yassinekarroukuxvc/WAD.Runner/Resources/Templates/1001/1001A_REQ_Rev0_07232026  .pptx

SMALL PRECISION TOOLS

Wedge Auto-Draw Requirements

Small Wire (SW) Wedge Series – 1001A Series – Microwave Bonding Tools
Requirements

DOCUMENT NO.

1001A_REQ_Rev0_07232026

DATE

2026-23-07

PREPARED BY

Youssef

STATUS

Draft

## Slide 2

Scope

This document defines the production drawing, customer drawing, and overlay requirements for the 1001A Series
Requirements series, covering both the finished wedge and the Pre-Ground Blank (PGB). Including 1001A, 1007, 1002A, 1005A, 1300

SMALL PRECISION TOOLS

Confidential

04

## Slide 3

Tool Overview

SMALL PRECISION TOOLS

Confidential

04

## Slide 4

Configuration Options

Shank: SW_STD with SLB feature , SW_180REV with SLB feature

For Tip detail we have STD 20°ISA , WITH VW VR , CHMFERED W2, 10°BA, 0°BA, SECOND RA2


SMALL PRECISION TOOLS

Confidential

04

## Slide 5

Configuration Options

Foot options: SW_C, SW_F, SW_CG, SW_G, SW_VG, SW_CC


SMALL PRECISION TOOLS

Confidential

04

## Slide 6

Configuration Options

Notch type: SW_L-Notch,


Note : No need for the C value

SMALL PRECISION TOOLS


Confidential

04

## Slide 7

Configuration Options

Feed hole types: STD (Round), Oval, Slot

Note : Y will be used to position the hole

SMALL PRECISION TOOLS


Confidential

04

## Slide 8

Configuration Options

BR feature: N/A


Note :

SMALL PRECISION TOOLS

Confidential

04

## Slide 9

Database Requirements

Schema is largely consistent with the COB tool family.

Note : We may need to add the fields like Wedge type; Foot type; etc.
Note : We will need to add some rules of data handling !

SMALL PRECISION TOOLS

Confidential

04

## Slide 10

Customer Drawing Requirements

For customer drawing we will replicate as the same provided, following the same step as COB

Front, Right & Top Views

Detail & Section Views

Dimensions Tables

Note : Noticed the VFL has an angle, but Not define in the DB

SMALL PRECISION TOOLS

Confidential

04

## Slide 11

Production Drawing Requirements

For customer drawing we will replicate as the same provided, following the same step as COB

Front, Right & Top Views

Detail & Section Views

Dimensions Tables

Add all dimensions and parameters to views

Note : The production drawing will follow the same as sample provided

SMALL PRECISION TOOLS

Confidential

04

## Slide 12

Overlay Requirements: Finish Wedge

Like COB overlay, with different tolerance zone construction. .

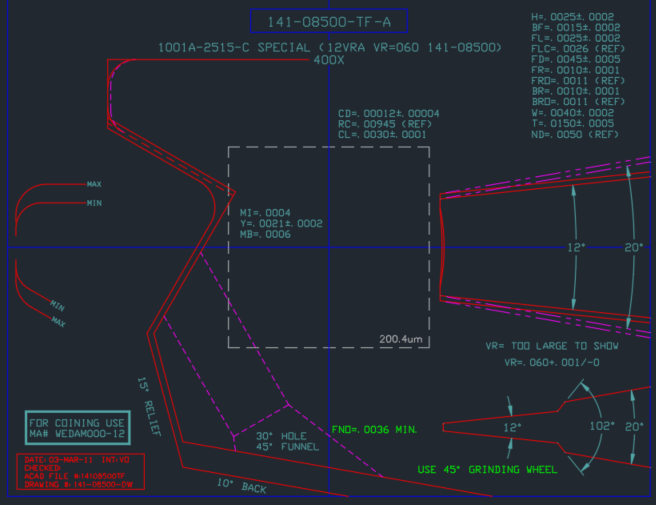
[picture p101: figure]

Note : Scaling the view the same way as COB, The T dimension start from TDF
Note : Only add two views to the overlays
Note : We need definition of the angles 12 & 20 & 102

SMALL PRECISION TOOLS

Confidential

04

## Slide 13

Overlay Requirements: PGB

Remains unchanged from the standard wedge overlay used across all tool families. Feed Hole added

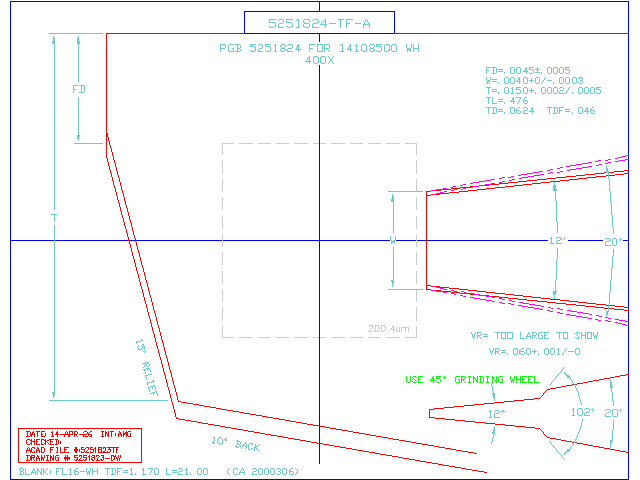
[picture p102: figure]

Note : The PGB may have the VR/VW version !

SMALL PRECISION TOOLS

Confidential

04
