yassinekarroukuxvc/WAD.Runner/Resources/Templates/AB16/AB16_rev1/AB16_REQ_Rev0_07222026 .pptx

SMALL PRECISION TOOLS

Wedge Auto-Draw Requirements

Small Wire (SW) Wedge Series – AB16 Series – Microwave Bonding Tools
Requirements

DOCUMENT NO.

AB16_REQ_Rev0_07222026

DATE

2026-22-07

PREPARED BY

Youssef

STATUS

Draft

## Slide 2

Scope

This document defines the production drawing, customer drawing, and overlay requirements for the AB16 Series – Microwave Bonding Tools
Requirements series, covering both the finished wedge and the Pre-Ground Blank (PGB).

SMALL PRECISION TOOLS

Confidential

04

## Slide 3

Tool Overview

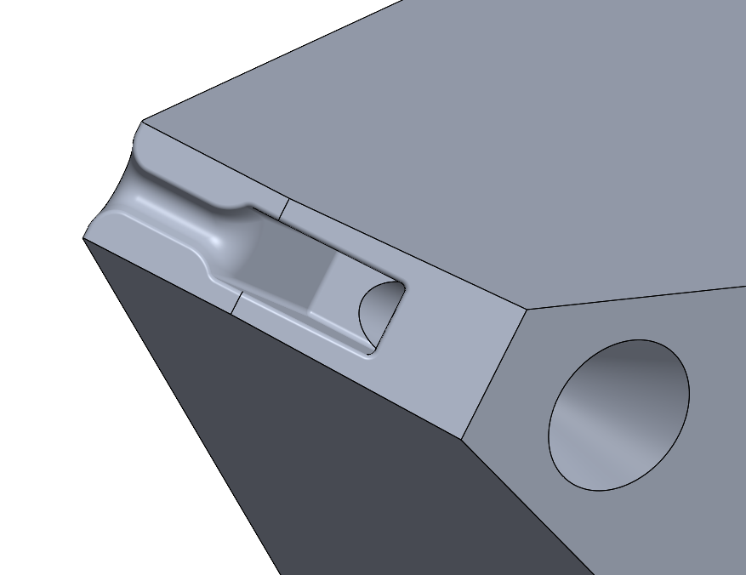
[picture p128: figure]

SMALL PRECISION TOOLS

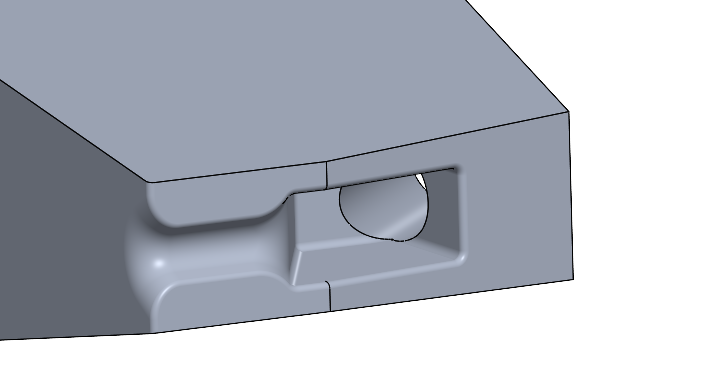
[picture p129: figure]

Confidential

04

## Slide 4

Configuration Options

Shank: SW_STD_Hole with SLB feature

For Tip detail we have STD 20°ISA , WITH VW VR , CHMFERED W2, 10°BA, 0°BA, SECOND RA2


04


SMALL PRECISION TOOLS

Confidential

## Slide 5

Configuration Options

Foot options: SW_VG, SW_VGCG


Note : For VGVG foot option is it the combination of the above ?

SMALL PRECISION TOOLS

Confidential

04

## Slide 6

Configuration Options

Notch type: SW_Cavity,

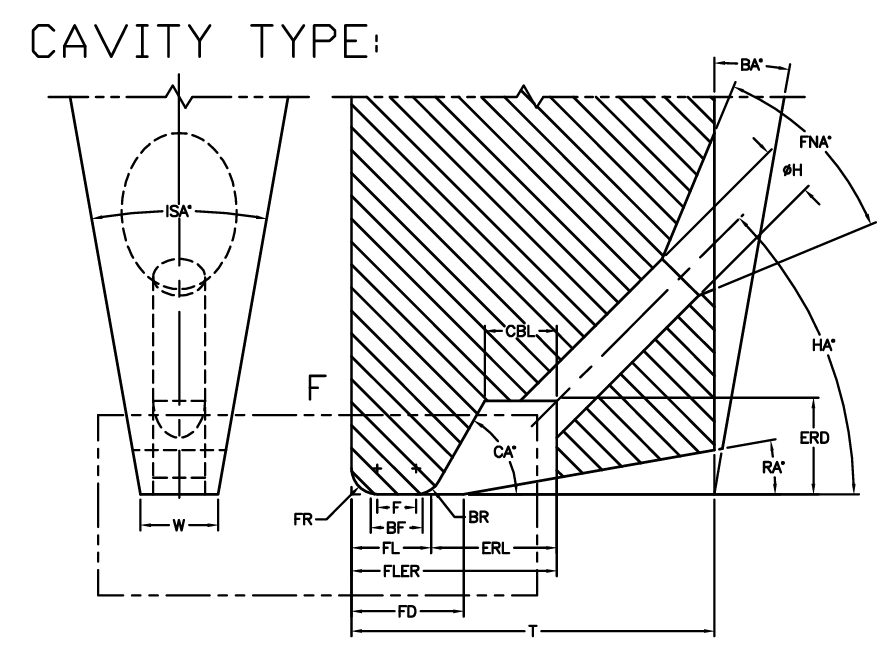
[picture p130: figure]

Note : Hole position with Y , tangent to BR and CA

SMALL PRECISION TOOLS

Confidential

04

## Slide 7

Configuration Options

Feed hole types: STD (Round), Oval, Slot


Note : Y will be used to position the hole

SMALL PRECISION TOOLS

Confidential

04

## Slide 8

Configuration Options

BR feature: Not specified !

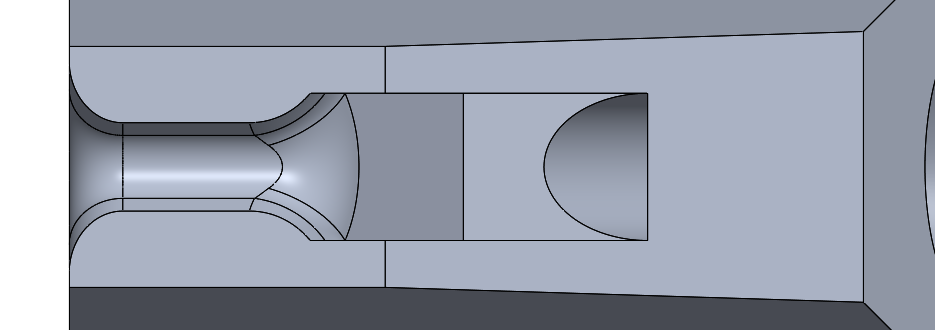
[picture p131: figure]
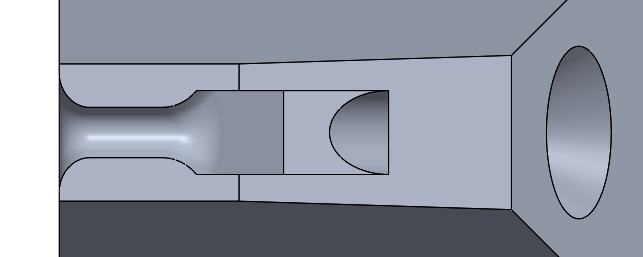
[picture p132: figure]

Note : Based on the drawing this is the output of the 3d model !

SMALL PRECISION TOOLS

Confidential

04

## Slide 9

Database Requirements

Schema is largely consistent with the COB tool family.

| drawing# | SG Description 2 | TL_NOM | TL_LTOL | TL_UTOL | TL_COMMENTS | TD_NOM | TD_LTOL | TD_UTOL
47 | 22002193 | AB16-3L-W-1/16-1.00-G (R) 220-02193 | 1 | 0.005 | 0.005 | | 0.0624 | 0.0001 | 0.0001
38 | 22002193 | AB16-3L-W-1/16-1.00-G 220-02193 | 1 | 0.005 | 0.005 | | 0.0624 | 0.0001 | 0.0001
120 | 2036194 | AB16-3L-W-1/16-1.20-G EP FFTP 2036194 | 1.2 | 0.005 | 0.005 | | 0.0624 | 0.0001 | 0.0001
72 | 2024953 | AB16-3L-WHF-1/16-1.20-G EP FFTP K&S 127260-60B | 1.2 | 0.005 | 0.005 | | 0.0624 | 0.0001 | 0.0001
121 | 2036193 | AB16-3R-W-1/16-1.20-G EP FFTP 2036193 | 1.2 | 0.005 | 0.005 | | 0.0624 | 0.0001 | 0.0001
99 | 2030100 | AB16-3R-WH-1/16-1.20-G | 1.2 | 0.005 | 0.005 | | 0.0624 | 0.0001 | 0.0001
50 | 2020912 | AB16-3R-WHF-1/16-1.20-G (R) CBR=0025 2020912 | 1.2 | 0.005 | 0.005 | | 0.0624 | 0.0001 | 0.0001
77 | 2026935 | AB16-3R-WHF-1/16-1.20-G 2026935 | 1.2 | 0.005 | 0.005 | | 0.0624 | 0.0001 | 0.0001

Note : We may need to add the fields like Wedge type; Foot type; etc.
Note : We will need to add some rules of data handling !

SMALL PRECISION TOOLS

Confidential

04

## Slide 10

Customer Drawing Requirements

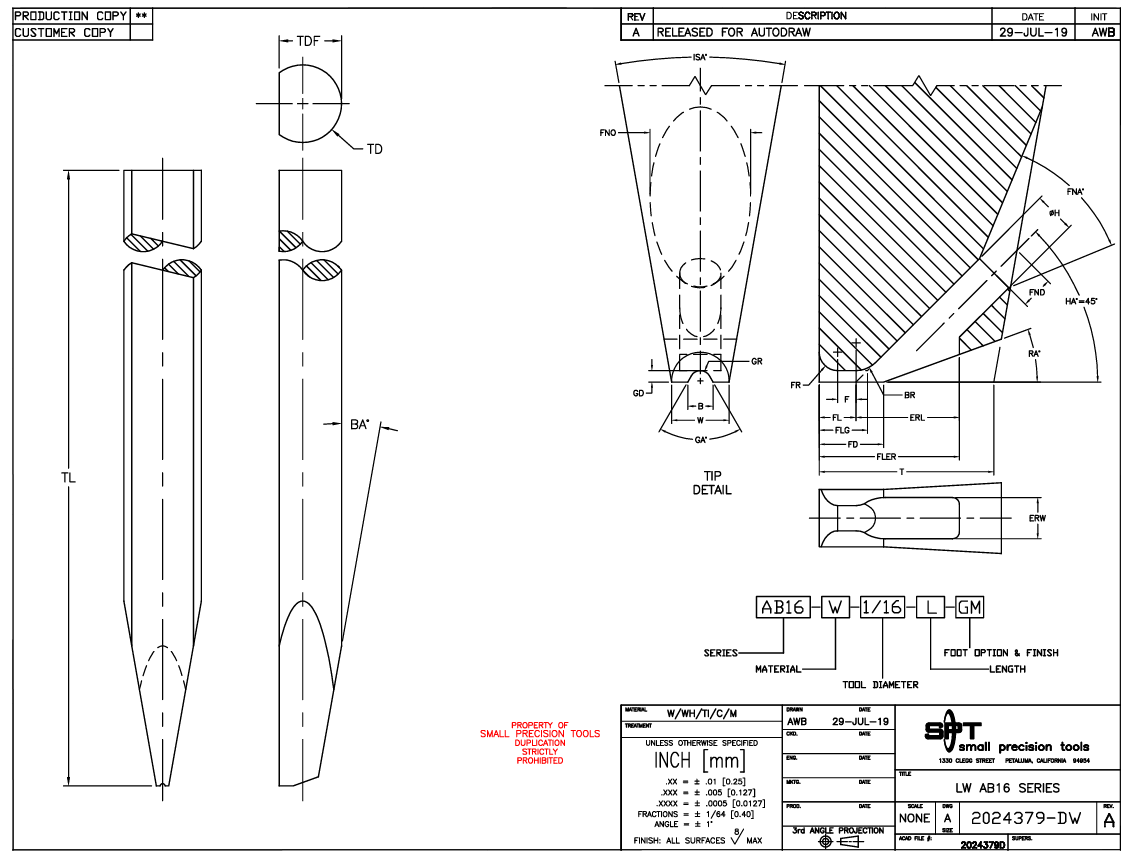
[picture p133: figure]

For customer drawing we will replicate as the same provided, following the same step as COB

Front, Right & Top Views

Detail & Section Views

Dimensions Tables

Note : I wil need the customer drawing sample

SMALL PRECISION TOOLS

Confidential

04

## Slide 11

Production Drawing Requirements

For customer drawing we will replicate as the same provided, following the same step as COB

Front, Right & Top Views

Detail & Section Views

Dimensions Tables

Add all dimensions and parameters to views

Note : The production drawing will follow the same as sample provided

SMALL PRECISION TOOLS

Confidential

04

## Slide 12

Overlay Requirements: Finish Wedge

Like COB overlay, with different tolerance zone construction. .

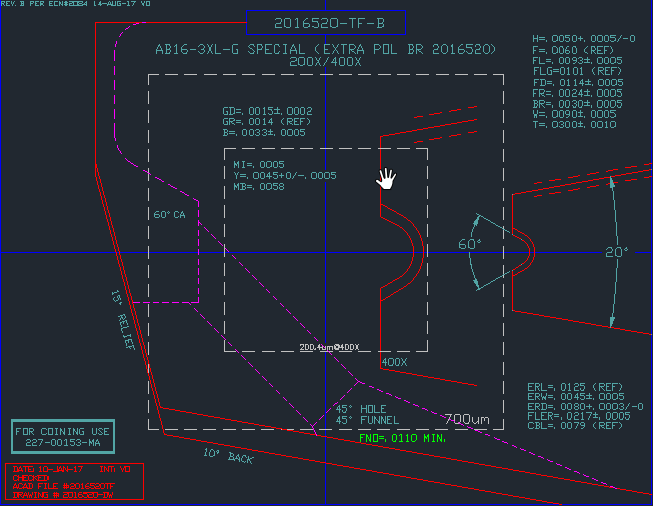
[picture p134: figure]
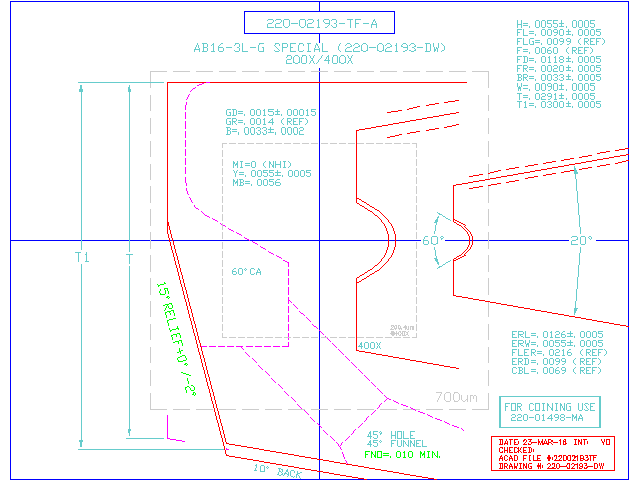
[picture p135: figure]

Note : Scaling the view the same way as COB, The T dimension start from TDF
Note : Only add two views to the overlays
Note : No need to all the annotations

SMALL PRECISION TOOLS

Confidential

04

## Slide 13

Overlay Requirements: PGB

Remains unchanged from the standard wedge overlay used across all tool families. Feed Hole added

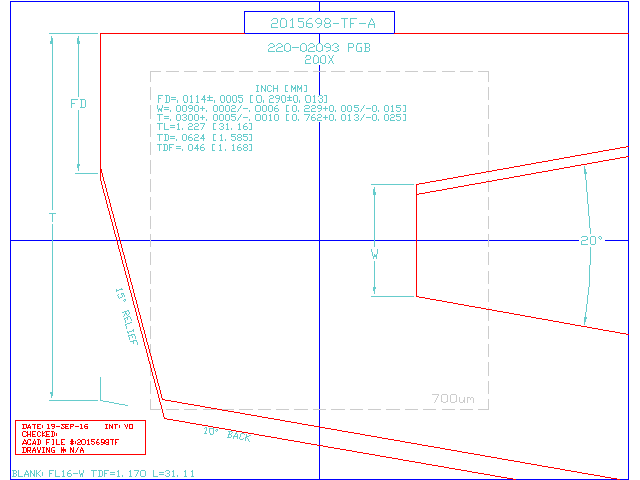
[picture p136: figure]

Note : The PGB may have the VR/VW version !

SMALL PRECISION TOOLS

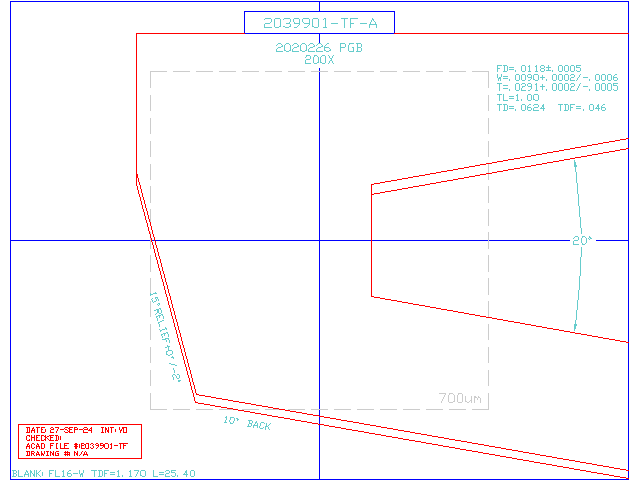
[picture p137: figure]

Confidential

04
