yassinekarroukuxvc/WAD.Runner/Resources/Out/FG/Overlay/3112260/3112260TF.tif

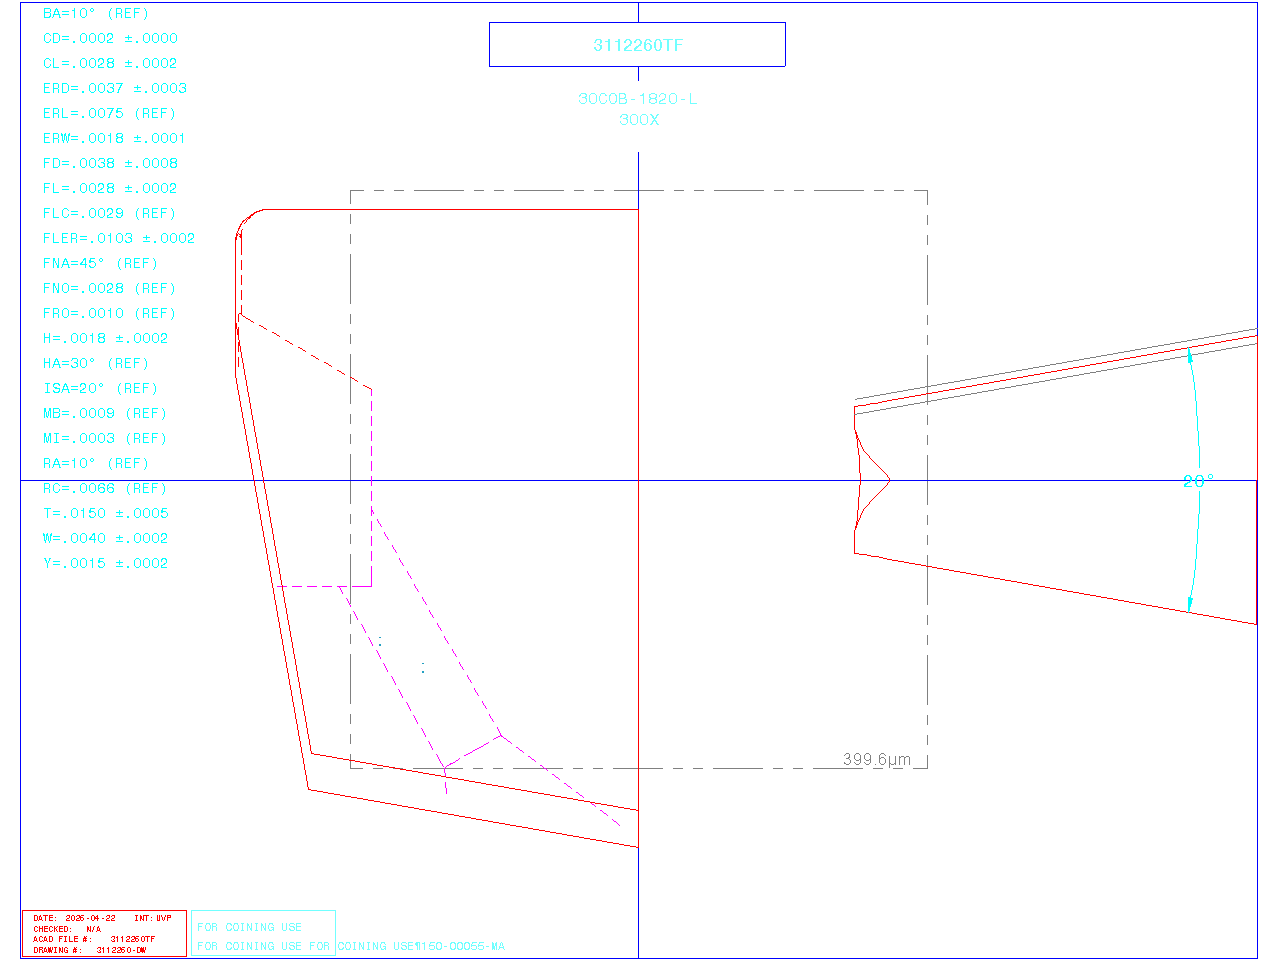
Resources/Out/FG/Overlay/3112260/3112260TF.tif
