yassinekarroukuxvc/WAD.Runner/Resources/Out/FG/Overlay/3118724/3118724TF.tif

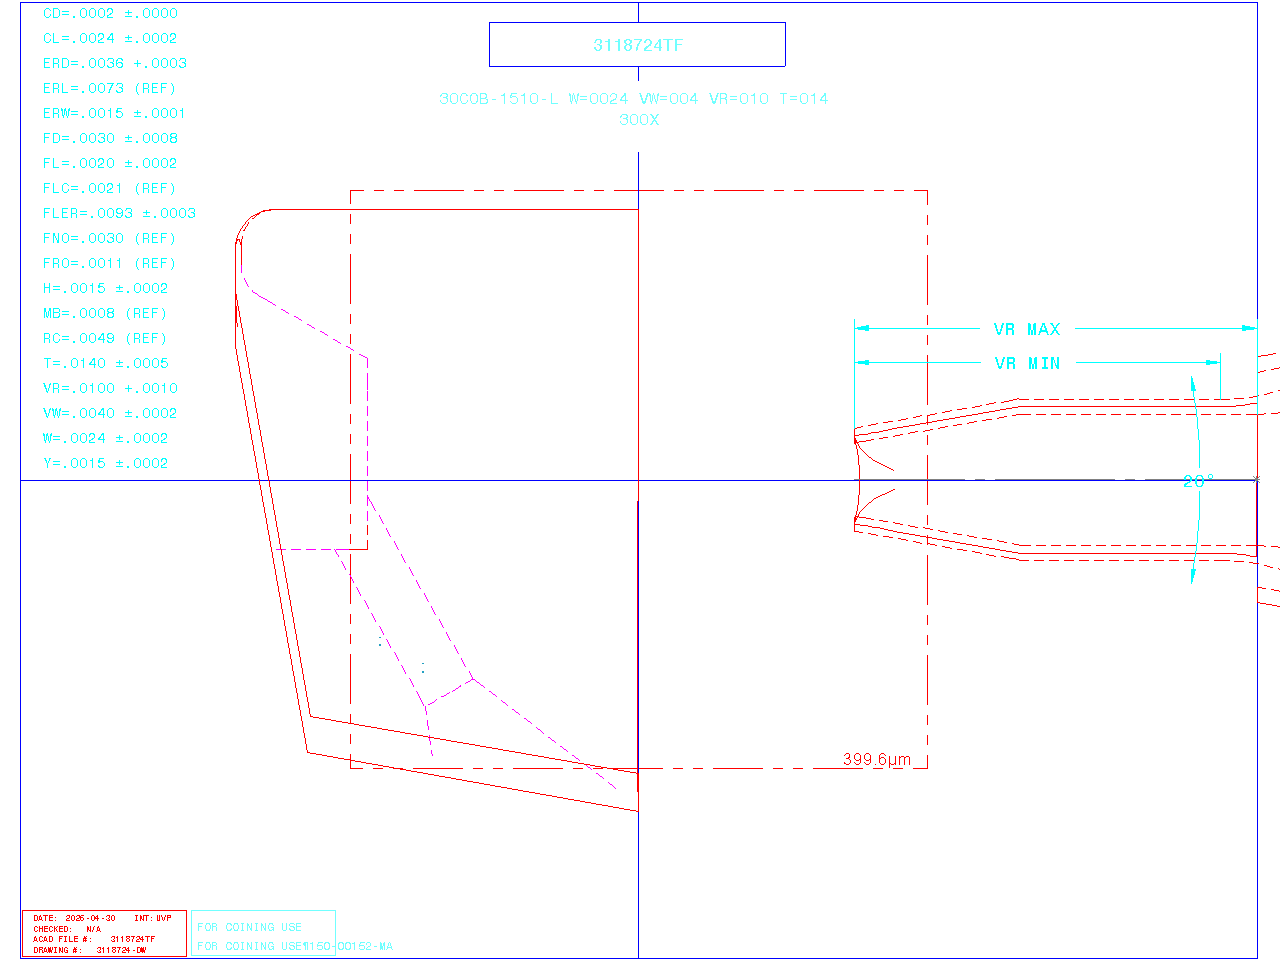
Resources/Out/FG/Overlay/3118724/3118724TF.tif
