yassinekarroukuxvc/WAD.Runner/Resources/Out/PGB/Overlay/3113909/3113909TF.tif

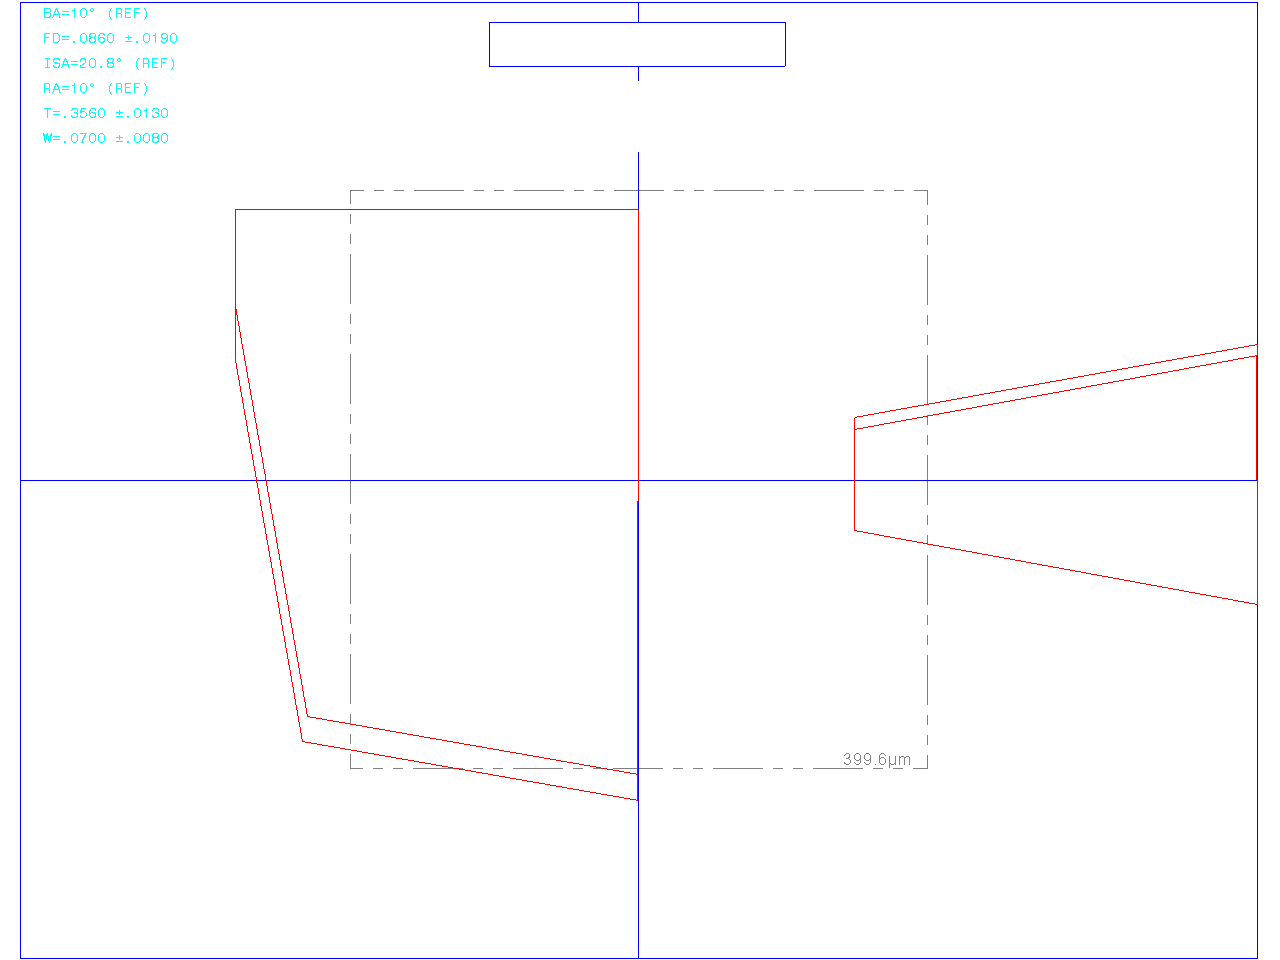
Resources/Out/PGB/Overlay/3113909/3113909TF.tif
