yassinekarroukuxvc/WAD.Runner/Resources/Out/PGB/Overlay/3114051/3114051TF.tif

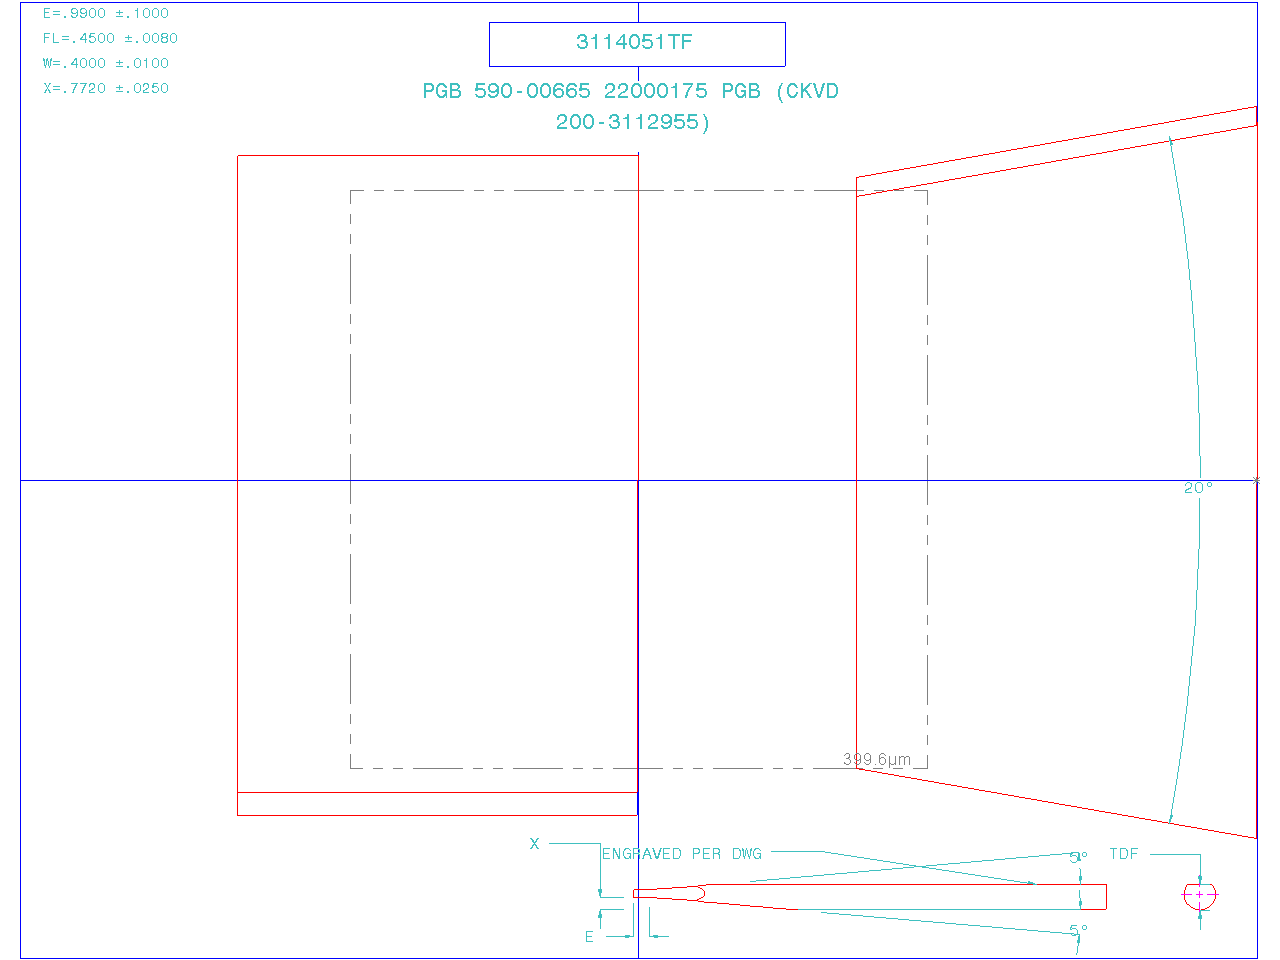
Resources/Out/PGB/Overlay/3114051/3114051TF.tif
