yassinekarroukuxvc/WAD.Runner/Resources/Templates/OSG7/OSG7_Produced_19-23_SG.xlsx

Sheet: Drawing_Sorted
 | drawing# | overlay_PA | article# | partspec# | partspec_templates | sources | PS_PA | drawing_title | wedge_title | units | TL_NOM | TL_LTOL | TL_UTOL | TL_COMMENTS | TD_NOM | TD_LTOL | TD_UTOL | TD_COMMENTS | TDF_NOM | TDF_LTOL | TDF_UTOL | TDF_COMMENTS | T_NOM | T_LTOL | T_UTOL | T_COMMENTS | FL_NOM | FL_LTOL | FL_UTOL | FL_COMMENTS | VFL_NOM | VFL_LTOL | VFL_UTOL | VFL_COMMENTS | FA_NOM | FA_LTOL | FA_UTOL | FA_COMMENTS | FX_NOM | FX_LTOL | FX_UTOL | FX_COMMENTS | X_NOM | X_LTOL | X_UTOL | X_COMMENTS | BA_NOM | BA_LTOL | BA_UTOL | BA_COMMENTS | ISA_NOM | ISA_LTOL | ISA_UTOL | ISA_COMMENTS | W_NOM | W_LTOL | W_UTOL | W_COMMENTS | VW_NOM
0 | 2011434 | SG-PA: 14102014T.etf | 3125071¦3126387 | 0¦128133 | Wed-Spec-Part1¦Wed-Spec-Part2 | Overlay & SG PA | 1 | 2011434-TF-A | OSG7-12-G SPECIAL (2011434-DW) |  | 2.5 | 0.005 | 0.005 | SG-PA: 2.50±.005 | 0.1249 | 0.0001 | 0.0001 | SG-PA: .1249±.0001 | 0.11 | 0.0005 | 0.0005 | SG-PA: .1100±.0005 | 0.0344 | 0.001 | 0.001 | SG-PA: .0344±.0010 {Wed-T.FL} | 0.0344 | 0.001 | 0.001 | FL=.0344±.0010¦SG-PA: .0344±.0010 {Wed-T.FL} |  |  |  |  | 5 | NaN | NaN | 5°FA |  |  |  |  | 0.0348 | 0.001 | 0.001 | X=.0348±.001 | 5 | NaN | NaN | 5°BA | 30 | NaN | NaN | 30°ISA | 0.023 | 0.001 | 0.001 | W=.0230±.0010¦SG-PA: .0230±.0010
1 | 2015228 | SG-PA: 14102014T.etf | 3122389 | 128661 | Wed-Spec-Part1¦Wed-Spec-Part2 | Overlay & SG PA | 1 | 2015228-TF-A | OSG7-20-G SPECIAL¶(20ISA FL=033 VFL=075 FX=0385 B=0202 2015228) |  | 2.5 | 0.005 | 0.005 | SG-PA: 2.50±.005 | 0.1249 | 0.0001 | 0.0001 | SG-PA: .1249±.0001 | 0.11 | 0.0005 | 0.0005 | SG-PA: .1100±.0005 | 0.033 | 0.001 | 0.001 | SG-PA: .0330±.0010 {Wed-T.FL} | 0.033¦0.0332 | 0.001 | 0.001 | FL=.0332±.0010¦SG-PA: .0330±.0010 {Wed-T.FL} | 0.075 | NaN | NaN | 0°FA VFL=.075 | 0 | NaN | NaN | 0°FA VFL=.075 |  |  |  |  | 0.0385 | NaN | NaN | X=.0385 | 5 | NaN | NaN | 5°BA | 20 | NaN | NaN | 20°ISA | 0.035 | 0.001 | 0.001 | W=.0350±.0010¦SG-PA: .0350±.0010
2 | 2015680 |  | 3122861 | 0 |  | Overlay & SG PA |  | 2015680-TF-A | OSG7-3-G SPECIAL (FL=0085 2015680) |  |  |  |  |  |  |  |  |  |  |  |  |  |  |  |  |  | 0.0085 | 0.0003 | 0.0003 | FL=.0085±.0003 |  |  |  |  | 5 | NaN | NaN | 5°FA |  |  |  |  | 0.0477 | NaN | NaN | X=.0477 | 5 | NaN | NaN | 5°BA | 30 | NaN | NaN | 30°ISA | 0.0059 | 0.0005 | 0.0005 | W=.0059±.0005
3 | 2015891 |  | 5201661 | 0 |  | Overlay & SG PA |  | 2015891-TF-A | OSG7-16-G SPECIAL (FL=044 2015891) |  |  |  |  |  |  |  |  |  |  |  |  |  |  |  |  |  | 0.044 | 0.001 | 0.001 | FL=.0440±.0010 |  |  |  |  | 5 | NaN | NaN | 5°FA |  |  |  |  | 0.03 | 0.001 | 0.001 | X=.0300±.0010 | 5 | NaN | NaN | 5°BA | 30 | NaN | NaN | 30°ISA | 0.032 | 0.001 | 0.001 | W=.0320±.0010
4 | 2015955 |  | 3123110 | 0 |  | Overlay & SG PA |  | 2015955-TF-A | OSG7-3-G SPECIAL (FL=0118 2015955) |  |  |  |  |  |  |  |  |  |  |  |  |  |  |  |  |  | 0.0118 | 0.0003 | 0.0003 | FL=.0118±.0003 |  |  |  |  | 5 | NaN | NaN | 5°FA |  |  |  |  | 0.0461 | NaN | NaN | X=.0461 | 5 | NaN | NaN | 5°BA | 30 | NaN | NaN | 30°ISA | 0.0059 | 0.0005 | 0.0005 | W=.0059±.0005
5 | 2016132 | SG-PA: 22000392RT.etf¦SG-PA: 14102014T.etf | 3123231¦3127184¦5201663¦5201825 | 127180¦128720¦133470¦133568 | Wed-Spec-Part1¦Wed-Spec-Part2 | Overlay & SG PA | 1 | 2016132-TF-A | OSG7-20-G SPECIAL (FL=033 VFL=075 FX=0385 2016132-DW) |  | 2.5 | 0.005 | 0.005 | SG-PA: 2.50±.005¦SG-PA: 2.5±.005 | 0.1249 | 0.0001 | 0.0001 | SG-PA: .1249±.0001 | 0.11 | 0.0005 | 0.0005 | SG-PA: .1100±.0005 | 0.033 | 0.001 | 0.001 | SG-PA: .0330±.0010 {Wed-T.FL} | 0.033 | 0.001 | 0.001 | FL=.0330±.0010¦SG-PA: .0330±.0010 {Wed-T.FL} | 0.075 | NaN | NaN | 0°FA VFL=.075 | 0 | NaN | NaN | 0°FA VFL=.075 |  |  |  |  | 0.0385 | NaN | NaN | X=.0385 | 5 | NaN | NaN | 5°BA | 30 | NaN | NaN | 30°ISA | 0.035 | 0.001 | 0.001 | W=.0350±.0010¦SG-PA: .0350±.0010
6 | 2016181 | SG-PA: 22000392RT.etf | 3123271¦3129349 | 127556¦130177 | Wed-Spec-Part1¦Wed-Spec-Part2 | Overlay & SG PA | 1 | 2016181-TF-A | OSG7-14-G SPECIAL (FL=0346 2016181-DW) |  | 2.5 | 0.005 | 0.005 | SG-PA: 2.500±.005 | 0.1249 | 0.0001 | 0.0001 | SG-PA: .1249±.0001 | 0.11 | 0.0005 | 0.0005 | SG-PA: .1100±.0005 | 0.0346 | 0.001 | 0.001 | SG-PA: .0346±.0010 {Wed-T.FL} | 0.0346 | 0.001 | 0.001 | FL=.0346±.0010¦SG-PA: .0346±.0010 {Wed-T.FL} |  |  |  |  | 5 | NaN | NaN | 5°FA |  |  |  |  | 0.035 | NaN | NaN | X=.035 | 5 | NaN | NaN | 5°BA | 30 | NaN | NaN | 30°ISA | 0.027 | 0.001 | 0.001 | W=.0270±.0010¦SG-PA: .0270±.0010
7 | 2016727 |  | 3123872¦3127400 | 0 |  | Overlay & SG PA |  | 2016727-TF-A | OSG7-20-G SPECIAL¶(FL=032 2016727-DW) |  |  |  |  |  |  |  |  |  |  |  |  |  |  |  |  |  | 0.032 | 0.001 | 0.001 | FL=.0320±.0010 |  |  |  |  | 5 | NaN | NaN | 5°FA |  |  |  |  | 0.036 | NaN | NaN | X=.036 | 5 | NaN | NaN | 5°BA | 20¦30 | NaN | NaN | 20°ISA¦30°ISA | 0.035 | 0.001 | 0.001 | W=.0350±.0010
8 | 2016910 |  | 3123975 | 0 |  | Overlay & SG PA |  | 2016910-TF-A | OSG7-12-G SPECIAL (2016910-DW) |  |  |  |  |  |  |  |  |  |  |  |  |  |  |  |  |  | 0.0254 | 0.001 | 0.001 | FL=.0254±.0010 |  |  |  |  | 5 | NaN | NaN | 5°FA |  |  |  |  | 0.0392 | NaN | NaN | X=.0392 | 5 | NaN | NaN | 5°BA | 30 | NaN | NaN | 30°ISA | 0.0227 | 0.001 | 0.001 | W=.0227±.0010
9 | 2017058 | SG-PA: 14102014T.etf | 3124508¦3126341¦5209996¦5209998¦5219736¦5224187 | 128571¦128095¦136967¦136968¦139968¦141447 | Wed-Spec-Part1¦Wed-Spec-Part2 | Overlay & SG PA | 1 | 2017058-TF-B | OSG7-5-G SPECIAL (2017058) |  | 2.5 | 0.005 | 0.005 | SG-PA: 2.50±.005¦SG-PA: 2.5±.005 | 0.1249 | 0.0001 | 0.0001 | SG-PA: .1249±.0001 | 0.11 | 0.0005 | 0.0005 | SG-PA: .1100±.0005 | 0.0148 | 0.0005 | 0.0005 | SG-PA: .0148±.0005 {Wed-T.FL} | 0.0148 | 0.0005 | 0.0005 | CUSTOMER SPECIFIED DIMENSION (NOT BASED ON MASTER)¦FL=.0148±.0005¦SG-PA: .0148±.0005 {Wed-T.FL} |  |  |  |  | 5 | NaN | NaN | 5°FA |  |  |  |  | 0.0442 | NaN | NaN | X=.0442 | 5 | NaN | NaN | 5°BA | 30 | NaN | NaN | 30°ISA | 0.011 | 0.0005 | 0.0005 | CUSTOMER SPECIFIED DIMENSION (NOT BASED ON MASTER)¦W=.0110±.0005¦SG-PA: .0110±.0005
10 | 2017059 |  | 5200780 | 0 |  | Overlay & SG PA |  | 2017059-TF-A | OSG7-5-G SPECIAL (FL=0125 2017059) |  |  |  |  |  |  |  |  |  |  |  |  |  |  |  |  |  | 0.0125 | 0.0005 | 0.0005 | FL=.0125±.0005 |  |  |  |  | 5 | NaN | NaN | 5°FA |  |  |  |  | 0.046 | NaN | NaN | X=.046 | 5 | NaN | NaN | 5°BA | 30 | NaN | NaN | 30°ISA | 0.0105 | 0.0005 | 0.0005 | W=.0105±.0005
11 | 2017060 | SG-PA: 14102014T.etf | 3124509¦3129536 | 0¦130287 | Wed-Spec-Part1¦Wed-Spec-Part2 | Overlay & SG PA | 1 | 2017060-TF-A | OSG7-10-G SPECIAL (2017060) |  | 2.5 | 0.005 | 0.005 | SG-PA: 2.50±.005 | 0.1249 | 0.0001 | 0.0001 | SG-PA: .1249±.0001 | 0.11 | 0.0005 | 0.0005 | SG-PA: .1100±.0005 | 0.0284 | 0.001 | 0.001 | SG-PA: .0284±.0010 {Wed-T.FL} | 0.0284 | 0.001 | 0.001 | FL=.0284±.0010¦SG-PA: .0284±.0010 {Wed-T.FL} |  |  |  |  | 5 | NaN | NaN | 5°FA |  |  |  |  | 0.0378 | 0.001 | 0.001 | X=.0378±.0010 | 5 | NaN | NaN | 5°BA | 30 | NaN | NaN | 30°ISA | 0.019 | 0.001 | 0.001 | W=.0190±.0010¦SG-PA: .0190±.0010
12 | 2017061 | SG-PA: 14102014T.etf | 5210501 | 137292 | Wed-Spec-Part1¦Wed-Spec-Part2 | Overlay & SG PA | 1 | 2017061-TF-A | OSG7-500-G SPECIAL (FL=039 2017061) |  | 2.5 | 0.005 | 0.005 | SG-PA: 2.50±.005 | 0.1249 | 0.0001 | 0.0001 | SG-PA: .1249±.0001 | 0.11 | 0.0005 | 0.0005 | SG-PA: .1100±.0005 | 0.039 | 0.001 | 0.001 | SG-PA: .0390±.0010 {Wed-T.FL} | 0.039 | 0.001 | 0.001 | FL=.0390±.0010¦SG-PA: .0390±.0010 {Wed-T.FL} |  |  |  |  | 5 | NaN | NaN | 5°FA |  |  |  |  | 0.0325 | NaN | NaN | X=.0325 | 5 | NaN | NaN | 5°BA | 30 | NaN | NaN | 30°ISA | 0.04 | 0.001 | 0.001 | W=.0400±.0010¦SG-PA: .0400±.0010
13 | 2017213 | SG-PA: 14008558T.etf | 3124393 | 128940 | Wed-Spec-Part1¦Wed-Spec-Part2 | Overlay & SG PA | 1 | 2017213-TF-B | OSG7-12-G SPECIAL¶(FL=0294 W=VW=019 VR=024 2017213) |  | 2.5 | 0.005 | 0.005 | SG-PA: 2.50±.005 | 0.1249 | 0.0001 | 0.0001 | SG-PA: .1249±.0001 | 0.11 | 0.0005 | 0.0005 | SG-PA: .1100±.0005 | 0.0294 | 0.001 | 0.001 | SG-PA: .0294±.0010 {Wed-T.FL} | 0.0294 | 0.001 | 0.001 | FL=.0294±.0010¦SG-PA: .0294±.0010 {Wed-T.FL} |  |  |  |  | 5 | NaN | NaN | 5°FA |  |  |  |  | 0.0373 | NaN | NaN | X=.0373 | 5 | NaN | NaN | 5°BA | 30 | NaN | NaN | 30°ISA | 0.019 | 0.001 | 0.001 | W=VW=.0190±.0010¦SG-PA: .019±.0010 | 0.019
14 | 2017436 | SG-PA: 14102014T.etf | 3126344¦5201659¦5201660¦5201699 | 128082¦133519¦133520¦133521 | Wed-Spec-Part1¦Wed-Spec-Part2 | Overlay & SG PA | 1 | 2017436-TF-A | OSG7-5-G SPECIAL (FL=012 2017436) |  | 2.5 | 0.005 | 0.005 | SG-PA: 2.50±.005¦SG-PA: 2.500±.005 | 0.1249 | 0.0001 | 0.0001 | SG-PA: .1249±.0001 | 0.11 | 0.0005 | 0.0005 | SG-PA: .1100±.0005 | 0.012 | 0.0005 | 0.0005 | SG-PA: .0120±.0005 {Wed-T.FL} | 0.012 | 0.0005 | 0.0005 | FL=.0120±.0005¦SG-PA: .0120±.0005 {Wed-T.FL} |  |  |  |  | 5 | NaN | NaN | 5°FA |  |  |  |  | 0.046 | NaN | NaN | X=.046 | 5 | NaN | NaN | 5°BA | 30 | NaN | NaN | 30°ISA | 0.011 | 0.0005 | 0.0005 | W=.0110±.0005¦SG-PA: .0110±.0005
15 | 2017438 | SG-PA: 14102014T.etf | 3126345¦3128709¦5202788 | 128142¦130394¦134083 | Wed-Spec-Part1¦Wed-Spec-Part2 | Overlay & SG PA | 1 | 2017438-TF-A | OSG7-20-G SPECIAL (2017438) |  | 2.5 | 0.005 | 0.005 | SG-PA: 2.50±.005 | 0.1249 | 0.0001 | 0.0001 | SG-PA: .1249±.0001 | 0.11 | 0.0005 | 0.0005 | SG-PA: .1100±.0005 | 0.0566 | 0.001 | 0.001 | SG-PA: .0566±.0010 {Wed-T.FL} | 0.0566 | 0.001 | 0.001 | FL=.0566±.0010¦SG-PA: .0566±.0010 {Wed-T.FL} |  |  |  |  | 5 | NaN | NaN | 5°FA |  |  |  |  | 0.024 | NaN | NaN | X=.024 | 5 | NaN | NaN | 5°BA | 30 | NaN | NaN | 30°ISA | 0.038 | 0.001 | 0.001 | W=.0380±.0010¦SG-PA: .0380±.0010
16 | 2017704 |  | 3124916 | 0 |  | Overlay & SG PA |  | 2017704-TF-A | OSG7-16-G SPECIAL (GD=0095 2017704) |  |  |  |  |  |  |  |  |  |  |  |  |  |  |  |  |  | 0.039 | 0.001 | 0.001 | FL=.0390±.0010 |  |  |  |  | 5 | NaN | NaN | 5°FA |  |  |  |  | 0.0325 | NaN | NaN | X=.0325 | 5 | NaN | NaN | 5°BA | 30 | NaN | NaN | 30°ISA | 0.03 | 0.001 | 0.001 | W=.0300±.0010
17 | 2017795 | SG-PA: 22001081T.etf | 3124920¦3124936 | 127468¦0 | Wed-Spec-Part1¦Wed-Spec-Part2 | Overlay & SG PA | 1 | 2017795-TF-A | OSG7-8-G SPECIAL (FL=0195 2017795) |  | 63.5 | 13 | 13 | SG-PA: 63.5±13 |  |  |  |  | 0.11 | 0.005 | 0.005 | SG-PA: .110±.005 | 0.0195 | 0.0005 | 0.0005 | SG-PA: .0195±.0005 {Wed-T.FL} | 0.0195 | 0.0005 | 0.0005 | FL=.0195±.0005¦SG-PA: .0195±.0005 {Wed-T.FL} |  |  |  |  | 5 | NaN | NaN | 5°FA |  |  |  |  | 0.0423 | NaN | NaN | X=.0423 | 5 | NaN | NaN | 5°BA | 30 | NaN | NaN | 30°ISA | 0.0146 | 0.0005 | 0.0005 | W=.0146±.0005¦SG-PA: .0146±.0005
18 | 2018051 | SG-PA: 14102014T.etf | 3125250 | 129186 | Wed-Spec-Part1¦Wed-Spec-Part2 | Overlay & SG PA | 1 | 2018051-TF-A | OSG7-12-G SPECIAL¶(FL=0294 B=0130 2018051) |  | 2.5 | 0.005 | 0.005 | SG-PA: 2.50±.005 | 0.1249 | 0.0001 | 0.0001 | SG-PA: .1249±.0001 | 0.11 | 0.0005 | 0.0005 | SG-PA: .1100±.0005 | 0.0294 | 0.001 | 0.001 | SG-PA: .0294±.0010 {Wed-T.FL} | 0.0294 | 0.001 | 0.001 | FL=.0294±.0010¦SG-PA: .0294±.0010 {Wed-T.FL} |  |  |  |  | 5 | NaN | NaN | 5°FA |  |  |  |  | 0.0373 | NaN | NaN | X=.0373 | 5 | NaN | NaN | 5°BA | 30 | NaN | NaN | 30°ISA | 0.023 | 0.001 | 0.001 | W=.0230±.0010¦SG-PA: .0230±.0010
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
32 | 2021018 | SG-PA: 14102014T.etf | 3127411¦3131731¦5201826 | 0¦131406¦133672 | Wed-Spec-Part1¦Wed-Spec-Part2 | Overlay & SG PA | 1 | 2021018-TF-A | OSG7-20-G SPECIAL (W=VW=031 VR=020¶FL=033 VFL=075 FX=0385 B=0202 2021018) |  | 1.97¦2.5 | 0.005 | 0.005 | SG-PA: 1.97±.005¦SG-PA: 2.5±.005 | 0.1249 | 0.0001 | 0.0001 | SG-PA: .1249±.0001 | 0.11 | 0.0005 | 0.0005 | SG-PA: .1100±.0005 | 0.033 | 0.001 | 0.001 | SG-PA: .0330±.0010 {Wed-T.FL} | 0.033 | 0.001 | 0.001 | FL=.0330±.0010¦SG-PA: .0330±.0010 {Wed-T.FL} | 0.075 | NaN | NaN | 0°FA VFL=.075 | 0 | NaN | NaN | 0°FA VFL=.075 |  |  |  |  | 0.0385 | 0.001 | 0.001 | X=.0385±.001 | 5 | NaN | NaN | 5°BA | 20 | NaN | NaN | 20°ISA | 0.031 | 0.001 | 0.001 | W=.0310±.0010¦SG-PA: .0310±.0010 | 0.031
33 | 2021217 |  | 3127489 | 0 |  | Overlay & SG PA |  | 2021217-TF-A | OSG7-8-G SPECIAL (FL=017 2021217) |  |  |  |  |  |  |  |  |  |  |  |  |  |  |  |  |  | 0.017 | 0.0005 | 0.0005 | FL=.0170±.0005 |  |  |  |  | 5 | NaN | NaN | 5°FA |  |  |  |  | 0.0435 | 0.001 | 0.001 | X=.0435±.001 | 5 | NaN | NaN | 5°BA | 30 | NaN | NaN | 30°ISA | 0.015 | 0.0005 | 0.0005 | W=.0150±.0005
34 | 2021980 | SG-PA: 14102014T.etf | 3128186¦3128427¦5201656¦5201657¦5209675 | 129650¦129739¦133517¦133518¦139890 | Wed-Spec-Part1¦Wed-Spec-Part2 | Overlay & SG PA | 1 | 2021980-TF-A | OSG7-5-G (FL=012 SPECIAL 2021980) |  | 2.5 | 0.005 | 0.005 | SG-PA: 2.50±.005¦SG-PA: 2.500±.005¦SG-PA: 2.5±.005 | 0.1249 | 0.0001 | 0.0001 | SG-PA: .1249±.0001 | 0.11 | 0.0005 | 0.0005 | SG-PA: .1100±.0005 | 0.012 | 0.0005 | 0.0005 | SG-PA: .0120±.0005 {Wed-T.FL} | 0.012 | 0.0005 | 0.0005 | FL=.0120±.0005¦SG-PA: .0120±.0005 {Wed-T.FL} |  |  |  |  | 5 | NaN | NaN | 5°FA |  |  |  |  | 0.046 | NaN | NaN | X=.046 | 5 | NaN | NaN | 5°BA | 30 | NaN | NaN | 30°ISA | 0.011 | 0.0005 | 0.0005 | W=.0110±.0005¦SG-PA: .0110±.0005
35 | 2022644 |  | 5200863 | 0 |  | Overlay & SG PA |  | 2022644-TF-A | OSG7-10-G SPECIAL (FL=021 2022644) |  |  |  |  |  |  |  |  |  |  |  |  |  |  |  |  |  | 0.021 | 0.001 | 0.001 | FL=.0210±.0010 |  |  |  |  | 5 | NaN | NaN | 5°FA |  |  |  |  | 0.0415 | NaN | NaN | X=.0415 | 5 | NaN | NaN | 5°BA | 30 | NaN | NaN | 30°ISA | 0.019 | 0.001 | 0.001 | W=.0190±.0010
36 | 2022645 | SG-PA: 14102014T.etf | 5213520 | 138090 | Wed-Spec-Part1¦Wed-Spec-Part2 | Overlay & SG PA | 1 | 2022645-TF-A | OSG7-20-G SPECIAL (FL=042 2022645) |  | 2.5 | 0.005 | 0.005 | SG-PA: 2.50±.005 | 0.1249 | 0.0001 | 0.0001 | SG-PA: .1249±.0001 | 0.11 | 0.0005 | 0.0005 | SG-PA: .1100±.0005 | 0.042 | 0.001 | 0.001 | SG-PA: .0420±.0010 {Wed-T.FL} | 0.042 | 0.001 | 0.001 | FL=.0420±.0010¦SG-PA: .0420±.0010 {Wed-T.FL} |  |  |  |  | 5 | NaN | NaN | 5°FA |  |  |  |  | 0.031 | NaN | NaN | X=.031 | 5 | NaN | NaN | 5°BA | 30 | NaN | NaN | 30°ISA | 0.038 | 0.001 | 0.001 | W=.0380±.0010¦SG-PA: .0380±.0010
37 | 2023091 | SG-PA: 14102014T.etf | 5203536 | 134550 | Wed-Spec-Part1¦Wed-Spec-Part2 | Overlay & SG PA | 1 | 2023091-TF-A | OSG7-15-G SPECIAL (FL=0366 2023091) |  | 2.5 | 0.005 | 0.005 | SG-PA: 2.50±.005 | 0.1249 | 0.0001 | 0.0001 | SG-PA: .1249±.0001 | 0.11 | 0.0005 | 0.0005 | SG-PA: .1100±.0005 | 0.0366 | 0.001 | 0.001 | SG-PA: .0366±.0010 {Wed-T.FL} | 0.0366 | 0.001 | 0.001 | FL=.0366±.0010¦SG-PA: .0366±.0010 {Wed-T.FL} |  |  |  |  | 5 | NaN | NaN | 5°FA |  |  |  |  | 0.0337 | 0.001 | 0.001 | X=.0337±.0010 | 5 | NaN | NaN | 5°BA | 30 | NaN | NaN | 30°ISA | 0.029 | 0.001 | 0.001 | W=.0290±.0010¦SG-PA: .0290±.0010
38 | 2023097 |  | 5220936 | 0 |  | Overlay & SG PA |  | 2023097-TF-A | OSG7-15-G SPECIAL (FL=0316 2023097) |  |  |  |  |  |  |  |  |  |  |  |  |  |  |  |  |  | 0.0316 | 0.001 | 0.001 | FL=.0316±.0010 |  |  |  |  | 5 | NaN | NaN | 5°FA |  |  |  |  | 0.0362 | NaN | NaN | X=.0362 | 5 | NaN | NaN | 5°BA | 30 | NaN | NaN | 30°ISA | 0.029 | 0.001 | 0.001 | W=.0290±.0010
39 | 2023203 | SG-PA: 14102014T.etf | 3129769 | 130377 | Wed-Spec-Part1¦Wed-Spec-Part2 | Overlay & SG PA | 1 | 2023203-TF-A | OSG7-12-G SPECIAL (2023203) |  | 2.5 | 0.005 | 0.005 | SG-PA: 2.50±.005 | 0.1249 | 0.0001 | 0.0001 | SG-PA: .1249±.0001 | 0.11 | 0.0005 | 0.0005 | SG-PA: .1100±.0005 | 0.0344 | 0.001 | 0.001 | SG-PA: .0344±.0010 {Wed-T.FL} | 0.0344 | 0.001 | 0.001 | FL=.0344±.0010¦SG-PA: .0344±.0010 {Wed-T.FL} |  |  |  |  | 5 | NaN | NaN | 5°FA |  |  |  |  | 0.0348 | 0.001 | 0.001 | X=.0348±.001 | 5 | NaN | NaN | 5°BA | 30 | NaN | NaN | 30°ISA | 0.023 | 0.001 | 0.001 | W=.0230±.0010¦SG-PA: .0230±.0010
40 | 2023432 |  | 3129859 | 0 |  | Overlay & SG PA |  | 2023432-TF-A | OSG7-5-G SPECIAL ((R) B=005 2023432) |  |  |  |  |  |  |  |  |  |  |  |  |  |  |  |  |  | 0.0148 | 0.0005 | 0.0005 | FL=.0148±.0005 |  |  |  |  | 5 | NaN | NaN | 5°FA |  |  |  |  | 0.0442 | NaN | NaN | X=.0442 | 5 | NaN | NaN | 5°BA | 30 | NaN | NaN | 30°ISA | 0.011 | 0.0005 | 0.0005 | W=.0110±.0005
41 | 2023433 |  | 3129860 | 0 |  | Overlay & SG PA |  | 2023433-TF-A | OSG7-12-G SPECIAL ((R) FL=0294 2023433) |  |  |  |  |  |  |  |  |  |  |  |  |  |  |  |  |  | 0.0294 | 0.001 | 0.001 | FL=.0294±.0010 |  |  |  |  | 5 | NaN | NaN | 5°FA |  |  |  |  |  | NaN | NaN | X=0433 | 5 | NaN | NaN | 5°BA | 30 | NaN | NaN | 30°ISA | 0.023 | 0.001 | 0.001 | W=.0230±.0010
42 | 2023467 |  | 3130233 | 0 |  | Overlay & SG PA |  | 2023467-TF-A | OSG7-4-G SPECIAL (FL=0114 2023467) |  |  |  |  |  |  |  |  |  |  |  |  |  |  |  |  |  | 0.0114 | 0.0005 | 0.0005 | FL=.0114±.0005 |  |  |  |  | 5 | NaN | NaN | 5°FA |  |  |  |  | 0.0463 | NaN | NaN | X=.0463 | 5 | NaN | NaN | 5°BA | 30 | NaN | NaN | 30°ISA | 0.0095 | 0.0005 | 0.0005 | W=.0095±.0005
43 | 2024153 |  | 5219122 | 0 |  | Overlay & SG PA |  | 2024153-TF-A | OSG7-20-G SPECIAL (2024153) |  |  |  |  |  |  |  |  |  |  |  |  |  |  |  |  |  | 0.0566 | 0.001 | 0.001 | FL=.0566±.0010 |  |  |  |  | 5 | NaN | NaN | 5°FA |  |  |  |  | 0.024 | NaN | NaN | X=.024 | 5 | NaN | NaN | 5°BA | 30 | NaN | NaN | 30°ISA | 0.038 | 0.001 | 0.001 | W=.0380±.0010
44 | 2025050 |  | 5204209 | 0 |  | Overlay & SG PA |  | 2025050-TF-A | OSG7-4-G SPECIAL (2025050) |  |  |  |  |  |  |  |  |  |  |  |  |  |  |  |  |  | 0.0114 | 0.0005 | 0.0005 | FL=.0114±.0005 |  |  |  |  | 5 | NaN | NaN | 5°FA |  |  |  |  | 0.0463 | NaN | NaN | X=.0463 | 5 | NaN | NaN | 5°BA | 30 | NaN | NaN | 30°ISA | 0.0095 | 0.0005 | 0.0005 | W=.0095±.0005
45 | 2025168 | SG-PA: 14102014T.etf | 3132663 | 132228 | Wed-Spec-Part1¦Wed-Spec-Part2 | Overlay & SG PA | 1 | 2025168-TF-A | OSG7-100-G SPECIAL (R) (FL=0.290 2025168) |  | 2.5 | 0.005 | 0.005 | SG-PA: 2.500±.005 | 0.1249 | 0.0001 | 0.0001 | SG-PA: .1249±.0001 | 0.11 | 0.0005 | 0.0005 | SG-PA: .1100±.0005 | 0.0114 | 0.0005 | 0.0005 | SG-PA: .0114±.0005 {Wed-T.FL} | 0.0114 | 0.0005 | 0.0005 | FL=.0114±.0005¦SG-PA: .0114±.0005 {Wed-T.FL} |  |  |  |  | 5 | NaN | NaN | 5°FA |  |  |  |  | 0.0463 | NaN | NaN | X=.0463 | 5 | NaN | NaN | 5°BA | 30 | NaN | NaN | 30°ISA | 0.008 | 0.0005 | 0.0005 | W=.0080±.0005¦SG-PA: .0080±.0005
46 | 2025169 | SG-PA: 14102014T.etf | 3132664 | 132229 | Wed-Spec-Part1¦Wed-Spec-Part2 | Overlay & SG PA | 1 | 2025169-TF-A | OSG7-125-G SPECIAL (R)(FL=0.361 2025169) |  | 2.5 | 0.005 | 0.005 | SG-PA: 2.500±.005 | 0.1249 | 0.0001 | 0.0001 | SG-PA: .1249±.0001 | 0.11 | 0.0005 | 0.0005 | SG-PA: .1100±.0005 | 0.0142 | 0.0005 | 0.0005 | SG-PA: .0142±.0005 {Wed-T.FL} | 0.0142 | 0.0005 | 0.0005 | FL=.0142±.0005¦SG-PA: .0142±.0005 {Wed-T.FL} |  |  |  |  | 5 | NaN | NaN | 5°FA |  |  |  |  | 0.0499 | NaN | NaN | X=.0499 | 5 | NaN | NaN | 5°BA | 30 | NaN | NaN | 30°ISA | 0.01 | 0.0005 | 0.0005 | W=.0100±.0005¦SG-PA: .0100±.0005
47 | 2025170 | SG-PA: 14102014T.etf | 3132665 | 132230 | Wed-Spec-Part1¦Wed-Spec-Part2 | Overlay & SG PA | 1 | 2025170-TF-A | OSG7-150-G SPECIAL (R) (FL=0.432 2025170) |  | 2.5 | 0.005 | 0.005 | SG-PA: 2.500±.005 | 0.1249 | 0.0001 | 0.0001 | SG-PA: .1249±.0001 | 0.11 | 0.0005 | 0.0005 | SG-PA: .1100±.0005 | 0.017 | 0.0005 | 0.0005 | SG-PA: .0170±.0005 {Wed-T.FL} | 0.017 | 0.0005 | 0.0005 | FL=.0170±.0005¦SG-PA: .0170±.0005 {Wed-T.FL} |  |  |  |  | 5 | NaN | NaN | 5°FA |  |  |  |  | 0.0435 | NaN | NaN | X=.0435 | 5 | NaN | NaN | 5°BA | 30 | NaN | NaN | 30°ISA | 0.012 | 0.0005 | 0.0005 | W=.0120±.0005¦SG-PA: .0120±.0005
48 | 2025171 | SG-PA: 14102014T.etf | 3132666 | 132231 | Wed-Spec-Part1¦Wed-Spec-Part2 | Overlay & SG PA | 1 | 2025171-TF-A | OSG7-200-G SPECIAL (R)(FL=0.574 2025171) |  | 2.5 | 0.005 | 0.005 | SG-PA: 2.500±.005 | 0.1249 | 0.0001 | 0.0001 | SG-PA: .1249±.0001 | 0.11 | 0.0005 | 0.0005 | SG-PA: .1100±.0005 | 0.0226 | 0.0005 | 0.0005 | SG-PA: .0226±.0005 {Wed-T.FL} | 0.0226 | 0.0005 | 0.0005 | FL=.0226±.0005¦SG-PA: .0226±.0005 {Wed-T.FL} |  |  |  |  | 5 | NaN | NaN | 5°FA |  |  |  |  | 0.0407 | NaN | NaN | X=.0407 | 5 | NaN | NaN | 5°BA | 30 | NaN | NaN | 30°ISA | 0.016 | 0.0005 | 0.0005 | W=.0160±.0005¦SG-PA: .0160±.0005
49 | 2025172 | SG-PA: 14102014T.etf | 3132667 | 132232 | Wed-Spec-Part1¦Wed-Spec-Part2 | Overlay & SG PA | 1 | 2025172-TF-A | OSG7-250-G SPECIAL (R) (FL=0.635 2025172) |  | 2.5 | 0.005 | 0.005 | SG-PA: 2.500±.005 | 0.1249 | 0.0001 | 0.0001 | SG-PA: .1249±.0001 | 0.11 | 0.0005 | 0.0005 | SG-PA: .1100±.0005 | 0.025 | 0.001 | 0.001 | SG-PA: .0250±.0010 {Wed-T.FL} | 0.025 | 0.001 | 0.001 | FL=.0250±.0010¦SG-PA: .0250±.0010 {Wed-T.FL} |  |  |  |  | 5 | NaN | NaN | 5°FA |  |  |  |  | 0.0385 | NaN | NaN | X=.0385 | 5 | NaN | NaN | 5°BA | 30 | NaN | NaN | 30°ISA | 0.02 | 0.001 | 0.001 | W=.0200±.0010¦SG-PA: .0200±.0010
50 | 2025173 | SG-PA: 14102014T.etf | 3132668 | 132233 | Wed-Spec-Part1¦Wed-Spec-Part2 | Overlay & SG PA | 1 | 2025173-TF-A | OSG7-300-G SPECIAL (R)¶(FL=0.864 2025173) |  | 2.5 | 0.005 | 0.005 | SG-PA: 2.500±.005 | 0.1249 | 0.0001 | 0.0001 | SG-PA: .1249±.0001 | 0.11 | 0.0005 | 0.0005 | SG-PA: .1100±.0005 | 0.034 | 0.001 | 0.001 | SG-PA: .0340±.0010 {Wed-T.FL} | 0.034 | 0.001 | 0.001 | FL=.0340±.0010¦SG-PA: .0340±.0010 {Wed-T.FL} |  |  |  |  | 5 | NaN | NaN | 5°FA |  |  |  |  | 0.035 | NaN | NaN | X=.0350 | 5 | NaN | NaN | 5°BA | 30 | NaN | NaN | 30°ISA | 0.024 | 0.001 | 0.001 | W=.0240±.0010¦SG-PA: .0240±.0010
51 | 2025174 | SG-PA: 14102014T.etf | 3132669 | 132234 | Wed-Spec-Part1¦Wed-Spec-Part2 | Overlay & SG PA | 1 | 2025174-TF-A | OSG7-380-G SPECIAL (R)(FL=0.952 2025174) |  | 2.5 | 0.005 | 0.005 | SG-PA: 2.500±.005 | 0.1249 | 0.0001 | 0.0001 | SG-PA: .1249±.0001 | 0.11 | 0.0005 | 0.0005 | SG-PA: .1100±.0005 | 0.0375 | 0.001 | 0.001 | SG-PA: .0375±.0010 {Wed-T.FL} | 0.0375 | 0.001 | 0.001 | FL=.0375±.0010¦SG-PA: .0375±.0010 {Wed-T.FL} |  |  |  |  | 5 | NaN | NaN | 5°FA |  |  |  |  | 0.0333 | NaN | NaN | X=.0333 | 5 | NaN | NaN | 5°BA | 30 | NaN | NaN | 30°ISA | 0.03 | 0.001 | 0.001 | W=.0300±.0010¦SG-PA: .0300±.0010
52 | 2025175 | SG-PA: 14102014T.etf | 3132670 | 132235 | Wed-Spec-Part1¦Wed-Spec-Part2 | Overlay & SG PA | 1 | 2025175-TF-A | OSG7-500-G SPECIAL (R) (FL=1.237 2025175) |  | 2.5 | 0.005 | 0.005 | SG-PA: 2.500±.005 | 0.1249 | 0.0001 | 0.0001 | SG-PA: .1249±.0001 | 0.11 | 0.0005 | 0.0005 | SG-PA: .1100±.0005 | 0.0487 | 0.001 | 0.001 | SG-PA: .0487±.0010 {Wed-T.FL} | 0.0487 | 0.001 | 0.001 | FL=.0487±.0010¦SG-PA: .0487±.0010 {Wed-T.FL} |  |  |  |  | 5 | NaN | NaN | 5°FA |  |  |  |  | 0.0276 | NaN | NaN | X=.0276 | 5 | NaN | NaN | 5°BA | 30 | NaN | NaN | 30°ISA | 0.04 | 0.001 | 0.001 | W=.0400±.0010¦SG-PA: .0400±.0010
53 | 2025216 | SG-PA: 14102014T.etf | 3132280 | 132089 | Wed-Spec-Part1¦Wed-Spec-Part2 | Overlay & SG PA | 1 | 2025216-TF-A | OSG7-20-G SPECIAL (W=VW=031 VR=020¶FL=033 VFL=075 FX=0385 B=0202 2025216) |  | 1.97 | 0.005 | 0.005 | SG-PA: 1.970±.005 | 0.1249 | 0.0001 | 0.0001 | SG-PA: .1249±.0001 | 0.11 | 0.0005 | 0.0005 | SG-PA: .1100±.0005 | 0.033 | 0.001 | 0.001 | SG-PA: .0330±.0010 {Wed-T.FL} | 0.033 | 0.001 | 0.001 | FL=.0330±.0010¦SG-PA: .0330±.0010 {Wed-T.FL} | 0.075 | NaN | NaN | 0°FA VFL=.075 | 0 | NaN | NaN | 0°FA VFL=.075 |  |  |  |  | 0.0385 | 0.001 | 0.001 | X=.0385±.001 | 5 | NaN | NaN | 5°BA | 20 | NaN | NaN | 20°ISA | 0.031 | 0.001 | 0.001 | W=.0310±.0010¦SG-PA: .0310±.0010 | 0.031
54 | 2025910 | SG-PA: 14102014T.etf | 5211782¦5216096 | 0¦138961 | Wed-Spec-Part1¦Wed-Spec-Part2 | Overlay & SG PA | 1 | 2025910-TF-A | OSG7-5-G STANDARD |  | 2 | 0.005 | 0.005 | SG-PA: 2±.005 | 0.1249 | 0.0001 | 0.0001 | SG-PA: .1249±.0001 | 0.11 | 0.0005 | 0.0005 | SG-PA: .1100±.0005 | 0.0142 | 0.0005 | 0.0005 | SG-PA: .0142±.0005 {Wed-T.FL} | 0.0142 | 0.0005 | 0.0005 | FL=.0142±.0005¦SG-PA: .0142±.0005 {Wed-T.FL} |  |  |  |  | 5 | NaN | NaN | 5°FA |  |  |  |  | 0.0452 | NaN | NaN | X=.0452 | 5 | NaN | NaN | 5°BA | 30 | NaN | NaN | 30°ISA | 0.01 | 0.0005 | 0.0005 | W=.0100±.0005¦SG-PA: .0100±.0005
55 | 2026480 |  | 5200862 | 0 |  | Overlay & SG PA |  | 2026480-TF-A | OSG7-8-G SPECIAL (FL=017 2026480) |  |  |  |  |  |  |  |  |  |  |  |  |  |  |  |  |  | 0.017 | 0.0005 | 0.0005 | FL=.0170±.0005 |  |  |  |  | 5 | NaN | NaN | 5°FA |  |  |  |  | 0.0435 | NaN | NaN | X=.0435 | 5 | NaN | NaN | 5°BA | 30 | NaN | NaN | 30°ISA | 0.014 | 0.0005 | 0.0005 | W=.0140±.0005
56 | 2026801 | SG-PA: 14102014T.etf | 5200878 | 133065 | Wed-Spec-Part1¦Wed-Spec-Part2 | Overlay & SG PA | 1 | 2026801-TF-A | OSG7-20-G SPECIAL (W=VW=031 VR=071¶FL=033 VFL=075 FX=0385 B=0202 2026801) |  | 1.97 | 0.005 | 0.005 | SG-PA: 1.970±.005 | 0.1249 | 0.0001 | 0.0001 | SG-PA: .1249±.0001 | 0.11 | 0.0005 | 0.0005 | SG-PA: .1100±.0005 | 0.033 | 0.001 | 0.001 | SG-PA: .0330±.0010 {Wed-T.FL} | 0.033 | 0.001 | 0.001 | FL=.0330±.0010¦SG-PA: .0330±.0010 {Wed-T.FL} | 0.075 | NaN | NaN | 0°FA VFL=.075 | 0 | NaN | NaN | 0°FA VFL=.075 |  |  |  |  | 0.0385 | 0.001 | 0.001 | X=.0385±.001 | 5 | NaN | NaN | 5°BA | 20 | NaN | NaN | 20°ISA | 0.031 | 0.001 | 0.001 | W=.0310±.0010¦W=VW¦SG-PA: .0310±.0010 | 0.031
57 | 2026802 | SG-PA: 14102014T.etf | 5200879 | 133064 | Wed-Spec-Part1¦Wed-Spec-Part2 | Overlay & SG PA | 1 | 2026802-TF-A | OSG7-20-G SPECIAL (W=VW=031 VR=079¶FL=033 VFL=075 FX=0385 B=0202 2026802) |  | 1.97 | 0.005 | 0.005 | SG-PA: 1.970±.005 | 0.1249 | 0.0001 | 0.0001 | SG-PA: .1249±.0001 | 0.11 | 0.0005 | 0.0005 | SG-PA: .1100±.0005 | 0.033 | 0.001 | 0.001 | SG-PA: .0330±.0010 {Wed-T.FL} | 0.033 | 0.001 | 0.001 | FL=.0330±.0010¦SG-PA: .0330±.0010 {Wed-T.FL} | 0.075 | NaN | NaN | 0°FA VFL=.075 | 0 | NaN | NaN | 0°FA VFL=.075 |  |  |  |  | 0.0385 | 0.001 | 0.001 | X=.0385±.001 | 5 | NaN | NaN | 5°BA | 20 | NaN | NaN | 20°ISA | 0.031 | 0.001 | 0.001 | W=.0310±.0010¦W=VW¦SG-PA: .0310±.0010 | 0.031
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
64 | 2027203 |  | 5201662 | 0 |  | Overlay & SG PA |  | 2027203-TF-A | OSG7-16-G SPECIAL (FL=044 2027203) |  |  |  |  |  |  |  |  |  |  |  |  |  |  |  |  |  | 0.044 | 0.001 | 0.001 | FL=.0440±.0010 |  |  |  |  | 5 | NaN | NaN | 5°FA |  |  |  |  | 0.03 | 0.001 | 0.001 | X=.0300±.0010 | 5 | NaN | NaN | 5°BA | 30 | NaN | NaN | 30°ISA | 0.032 | 0.001 | 0.001 | W=.0320±.0010
65 | 2027205 | SG-PA: 14102014T.etf | 5201701 | 133469 | Wed-Spec-Part1¦Wed-Spec-Part2 | Overlay & SG PA | 1 | 2027205-TF-A | OSG7-12-G SPECIAL (VFL=050 FL=0235 2027205) |  | 2.5 | 0.005 | 0.005 | SG-PA: 2.5±.005 | 0.1249 | 0.0001 | 0.0001 | SG-PA: .1249±.0001 | 0.11 | 0.0005 | 0.0005 | SG-PA: .1100±.0005 | 0.0235 | 0.0003 | 0.0003 | SG-PA: .0235±.0003 {Wed-T.FL} | 0.0235 | 0.0003 | 0.0003 | FL=.0235±.0003¦SG-PA: .0235±.0003 {Wed-T.FL} | 0.05 | 0 | 0.001 | 0°FA VFL=.050+.001/-0 | 0 | NaN | NaN | 0°FA VFL=.050+.001/-0 |  |  |  |  | 0.0403 | 0.001 | 0.001 | X=.0403±.0010 | 5 | NaN | NaN | 5°BA | 30 | NaN | NaN | 30°ISA | 0.0236 | 0.0005 | 0.0005 | W=.0236±.0005¦SG-PA: .0236±.0005
66 | 2027266 |  | 5212402 | 0 |  | Overlay & SG PA |  | 2027266-TF-A | OSG7-10-G STANDARD |  |  |  |  |  |  |  |  |  |  |  |  |  |  |  |  |  | 0.0283 | 0.0005 | 0.0005 | FL=.0283±.0005 |  |  |  |  | 5 | NaN | NaN | 5°FA |  |  |  |  | 0.0379 | NaN | NaN | X=.0379 | 5 | NaN | NaN | 5°BA | 30 | NaN | NaN | 30°ISA | 0.02 | 0.0005 | 0.0005 | W=.0200±.0005
67 | 2027318 | SG-PA: 14102014T.etf | 5201933 | 133636 | Wed-Spec-Part1¦Wed-Spec-Part2 | Overlay & SG PA | 1 | 2027318-TF-A | OSG7-5-G SPECIAL (R) (FL=0125 2027318) |  | 2.5 | 0.005 | 0.005 | SG-PA: 2.500±.005 | 0.1249 | 0.0001 | 0.0001 | SG-PA: .1249±.0001 | 0.11 | 0.0005 | 0.0005 | SG-PA: .1100±.0005 | 0.0125 | 0.0005 | 0.0005 | SG-PA: .0125±.0005 {Wed-T.FL} | 0.0125 | 0.0005 | 0.0005 | FL=.0125±.0005¦SG-PA: .0125±.0005 {Wed-T.FL} |  |  |  |  | 5 | NaN | NaN | 5°FA |  |  |  |  | 0.0457 | NaN | NaN | X=.0457 | 5 | NaN | NaN | 5°BA | 30 | NaN | NaN | 30°ISA | 0.011 | 0.0005 | 0.0005 | W=.0110±.0005¦SG-PA: .0110±.0005
68 | 2027320 | SG-PA: 14102014T.etf | 5201934 | 133637 | Wed-Spec-Part1¦Wed-Spec-Part2 | Overlay & SG PA | 1 | 2027320-TF-A | OSG7-5-G SPECIAL (SFL FL=0125 2027320) |  | 2.5 | 0.005 | 0.005 | SG-PA: 2.500±.005 | 0.1249 | 0.0001 | 0.0001 | SG-PA: .1249±.0001 | 0.11 | 0.0005 | 0.0005 | SG-PA: .1100±.0005 | 0.0125 | 0.0005 | 0.0005 | SG-PA: .0125±.0005 {Wed-T.FL} | 0.0125 | 0.0005 | 0.0005 | FL=.0125±.0005¦SG-PA: .0125±.0005 {Wed-T.FL} |  |  |  |  | 5 | NaN | NaN | 5°FA |  |  |  |  | 0.0457 | NaN | NaN | X=.0457 | 5 | NaN | NaN | 5°BA | 30 | NaN | NaN | 30°ISA | 0.011 | 0.0005 | 0.0005 | W=.0110±.0005¦SG-PA: .0110±.0005
69 | 2027591 | SG-PA: 14102014T.etf | 5223251 | 141198 | Wed-Spec-Part1¦Wed-Spec-Part2 | Overlay & SG PA | 1 | 2027591-TF-A | OSG7-20-G SPECIAL (FL=0487) |  | 2 | 0 | 0.005 | SG-PA: 2.0+.005/0 | 0.1249 | 0.0001 | 0.0001 | SG-PA: .1249±.0001 | 0.11 | 0.0005 | 0.0005 | SG-PA: .1100±.0005 | 0.0487 | 0.001 | 0.001 | SG-PA: .0487±.0010 {Wed-T.FL} | 0.0487 | 0.001 | 0.001 | FL=.0487±.0010¦SG-PA: .0487±.0010 {Wed-T.FL} |  |  |  |  | 5 | NaN | NaN | 5°FA |  |  |  |  | 0.0276 | NaN | NaN | X=.0276 | 5 | NaN | NaN | 5°BA | 30 | NaN | NaN | 30°ISA | 0.038 | 0.001 | 0.001 | W=.0380±.0010¦SG-PA: .0380±.0010
70 | 2027635 | SG-PA: 14102014T.etf | 5202341¦5202343 | 133990¦133991 | Wed-Spec-Part1¦Wed-Spec-Part2 | Overlay & SG PA | 1 | 2027635-TF-A | OSG7-5 SPECIAL (2027635) |  | 2.5 | 0.005 | 0.005 | SG-PA: 2.50±.005 | 0.1249 | 0.0001 | 0.0001 | SG-PA: .1249±.0001 | 0.11 | 0.0005 | 0.0005 | SG-PA: .1100±.0005 | 0.0152 | 0.0003 | 0.0003 | SG-PA: .0152±.0003 {Wed-T.FL} | 0.0152 | 0.0003 | 0.0003 | FL=.0152±.0003¦SG-PA: .0152±.0003 {Wed-T.FL} |  |  |  |  | 5 | NaN | NaN | 5°FA |  |  |  |  | 0.0444 | NaN | NaN | X=.0444 | 5 | NaN | NaN | 5°BA | 30 | NaN | NaN | 30°ISA | 0.011 | 0.0005 | 0.0005 | W=.0110±.0005¦SG-PA: .0110±.0005
71 | 2027636 | SG-PA: 14102014T.etf | 5202342¦5202344 | 133992¦133993 | Wed-Spec-Part1¦Wed-Spec-Part2 | Overlay & SG PA | 1 | 2027636-TF-A | OSG7-10-G SPECIAL (2027636) |  | 2.5 | 0.005 | 0.005 | SG-PA: 2.50±.005 | 0.1249 | 0.0001 | 0.0001 | SG-PA: .1249±.0001 | 0.11 | 0.0005 | 0.0005 | SG-PA: .1100±.0005 | 0.0283 | 0.001 | 0.001 | SG-PA: .0283±.0010 {Wed-T.FL} | 0.0283 | 0.001 | 0.001 | FL=.0283±.0010¦SG-PA: .0283±.0010 {Wed-T.FL} |  |  |  |  | 5 | NaN | NaN | 5°FA |  |  |  |  | 0.0379 | 0.001 | 0.001 | X=.0379±.0010 | 5 | NaN | NaN | 5°BA | 30 | NaN | NaN | 30°ISA | 0.019 | 0.001 | 0.001 | W=.0190±.0010¦SG-PA: .0190±.0010
72 | 2027869 | SG-PA: 14102014T.etf | 5213521 | 138091 | Wed-Spec-Part1¦Wed-Spec-Part2 | Overlay & SG PA | 1 | 2027869-TF-A | OSG7-5-G SPECIAL (SFL 2027869) |  | 2.5 | 0.005 | 0.005 | SG-PA: 2.50±.005 | 0.1249 | 0.0001 | 0.0001 | SG-PA: .1249±.0001 | 0.11 | 0.0005 | 0.0005 | SG-PA: .1100±.0005 | 0.0148 | 0.0005 | 0.0005 | SG-PA: .0148±.0005 {Wed-T.FL} | 0.0148 | 0.0005 | 0.0005 | FL=.0148±.0005¦SG-PA: .0148±.0005 {Wed-T.FL} |  |  |  |  | 5 | NaN | NaN | 5°FA |  |  |  |  | 0.0442 | NaN | NaN | X=.0442 | 5 | NaN | NaN | 5°BA | 30 | NaN | NaN | 30°ISA | 0.011 | 0.0005 | 0.0005 | W=.0110±.0005¦SG-PA: .0110±.0005
73 | 2027871 | SG-PA: 14102014T.etf | 5203396 | 134451 | Wed-Spec-Part1¦Wed-Spec-Part2 | Overlay & SG PA | 1 | 2027871-TF-A | OSG7-4-G SPECIAL (TDF=100 FL=0112 2027871) |  | 2.5 | 0.005 | 0.005 | SG-PA: 2.50±.005 | 0.1249 | 0.0001 | 0.0001 | SG-PA: .1249±.0001 | 0.1 | 0.0005 | 0.0005 | SG-PA: .1000±.0005 | 0.0112 | 0.0003 | 0.0003 | SG-PA: .0112±.0003 {Wed-T.FL} | 0.0112 | 0.0003 | 0.0003 | FL=.0112±.0003¦SG-PA: .0112±.0003 {Wed-T.FL} |  |  |  |  | 7.5 | NaN | NaN | 7.5°FA |  |  |  |  | 0.0484 | NaN | NaN | X=.0484 | 7.5 | NaN | NaN | 7.5°BA | 30 | NaN | NaN | 30°ISA | 0.011 | 0.0005 | 0.0005 | W=.0110±.0005¦SG-PA: .0110±.0005
74 | 2027948 | SG-PA: 14102014T.etf | 5202877 | 134273 | Wed-Spec-Part1¦Wed-Spec-Part2 | Overlay & SG PA | 1 | 2027948-TF-A | OSG7-12-G SPECIAL (FL=0294 2027948) |  | 2.5 | 0.005 | 0.005 | SG-PA: 2.5±.005 | 0.1249 | 0.0001 | 0.0001 | SG-PA: .1249±.0001 | 0.11 | 0.0005 | 0.0005 | SG-PA: .1100±.0005 | 0.0294 | 0.001 | 0.001 | SG-PA: .0294±.0010 {Wed-T.FL} | 0.0294 | 0.001 | 0.001 | FL=.0294±.0010¦SG-PA: .0294±.0010 {Wed-T.FL} |  |  |  |  | 5 | NaN | NaN | 5°FA |  |  |  |  | 0.0373 | NaN | NaN | X=.0373 | 5 | NaN | NaN | 5°BA | 30 | NaN | NaN | 30°ISA | 0.023 | 0.001 | 0.001 | W=.0230±.0010¦SG-PA: .0230±.0010
75 | 2029875 |  | 5205232 | 0 |  | Overlay & SG PA |  | 2029875-TF-A | OSG7-125-GCG SPECIAL¶(CRMET DWG HWT9142 REV L) |  |  |  |  |  |  |  |  |  |  |  |  |  |  |  |  |  | 0.0142 | 0.0001 | 0.0006 | FL=.0142+.0006/-.0001 |  |  |  |  | 5 | NaN | NaN | 5°FA |  |  |  |  | 0.0454 | NaN | NaN | X=.0454 | 5 | NaN | NaN | 5°BA | 30 | NaN | NaN | 30°ISA | 0.011 | 0.0005 | 0.0005 | W=.0110±.0005
76 | 2029991 |  | 5209224 | 0 |  | Overlay & SG PA |  | 2029991-TF-A | OSG7-15-G SPECIAL (TD=.1246 FL=030 2029991) |  |  |  |  |  |  |  |  |  |  |  |  |  |  |  |  |  | 0.03 | 0.0005 | 0.0005 | FL=.0300±.0005 |  |  |  |  | 0 | NaN | NaN | 0°FA |  |  |  |  | 0.04 | NaN | NaN | X=.040 | 5 | NaN | NaN | 5°BA | 30 | NaN | NaN | 30°ISA | 0.032 | 0.0005 | 0.0005 | W=.0320±.0005
77 | 2030073 |  | 5205824 | 0 |  | Overlay & SG PA |  | 2030073-TF-A | OSG7-5-G SPECIAL (35ISA FL=012 2030073) |  |  |  |  |  |  |  |  |  |  |  |  |  |  |  |  |  | 0.012 | 0.0005 | 0.0005 | FL=.0120±.0005 |  |  |  |  | 5 | NaN | NaN | 5°FA |  |  |  |  | 0.046 | NaN | NaN | X=.046 | 5 | NaN | NaN | 5°BA | 35 | NaN | NaN | 35°ISA | 0.011 | 0.0005 | 0.0005 | W=.0110±.0005
78 | 2030074 |  | 5205826 | 0 |  | Overlay & SG PA |  | 2030074-TF-A | OSG7-5-G SPECIAL (40ISA FL=012 2030074) |  |  |  |  |  |  |  |  |  |  |  |  |  |  |  |  |  | 0.012 | 0.0005 | 0.0005 | FL=.0120±.0005 |  |  |  |  | 5 | NaN | NaN | 5°FA |  |  |  |  | 0.046 | NaN | NaN | X=.046 | 5 | NaN | NaN | 5°BA |  |  |  |  | 0.011 | 0.0005 | 0.0005 | W=.0110±.0005
79 | 2030075 |  | 5205827 | 0 |  | Overlay & SG PA |  | 2030075-TF-A | OSG7-5-G SPECIAL (7.5FA 7.5BA FL=012 2030075) |  |  |  |  |  |  |  |  |  |  |  |  |  |  |  |  |  | 0.012 | 0.0005 | 0.0005 | FL=.0120±.0005 |  |  |  |  | 5¦7.5 | NaN | NaN | 7.5°FA¦5°FA |  |  |  |  | 0.046 | NaN | NaN | X=.046 | 5¦7.5 | NaN | NaN | 7.5°BA¦5°BA | 30 | NaN | NaN | 30°ISA | 0.011 | 0.0005 | 0.0005 | W=.0110±.0005
80 | 2030076 |  | 5205828 | 0 |  | Overlay & SG PA |  | 2030076-TF-A | OSG7-5-G SPECIAL (10FA 10BA FL=012 2030076) |  |  |  |  |  |  |  |  |  |  |  |  |  |  |  |  |  | 0.012 | 0.0005 | 0.0005 | FL=.0120±.0005 |  |  |  |  | 10¦5 | NaN | NaN | 10°FA¦5°FA |  |  |  |  | 0.046 | NaN | NaN | X=.046 | 10¦5 | NaN | NaN | 10°BA¦5°BA | 30 | NaN | NaN | 30°ISA | 0.011 | 0.0005 | 0.0005 | W=.0110±.0005
81 | 2030819 |  | 5208079 | 0 |  | Overlay & SG PA |  | 2030819-TF-A | OSG7-10-G SPECIAL (VFL=030 FL=019) |  |  |  |  |  |  |  |  |  |  |  |  |  |  |  |  |  | 0.019 | 0.001 | 0.001 | FL=.0190±.0010 | 0.03 | 0 | 0.001 | 0°FA VFL=.030+.001/-0 | 0 | NaN | NaN | 0°FA VFL=.030+.001/-0 |  |  |  |  | 0.0425 | NaN | NaN | X=.0425 | 5 | NaN | NaN | 5°BA | 30 | NaN | NaN | 30°ISA | 0.019 | 0.001 | 0.001 | W=.0190±.0010
82 | 2031391 |  | 5209144 | 0 |  | Overlay & SG PA |  | 2031391-TF-A | OSG7-10-G SPECIAL (FL=021 2031391) |  |  |  |  |  |  |  |  |  |  |  |  |  |  |  |  |  | 0.021 | 0.001 | 0.001 | FL=.0210±.0010 |  |  |  |  | 5 | NaN | NaN | 5°FA |  |  |  |  | 0.0415 | NaN | NaN | X=.0415 | 5 | NaN | NaN | 5°BA | 30 | NaN | NaN | 30°ISA | 0.019 | 0.001 | 0.001 | W=.0190±.0010
83 | 2031392 |  | 5209145 | 0 |  | Overlay & SG PA |  | 2031392-TF-A | OSG7-12-G SPECIAL (FL=024 2031392) |  |  |  |  |  |  |  |  |  |  |  |  |  |  |  |  |  | 0.024 | 0.001 | 0.001 | FL=.0240±.0010 |  |  |  |  | 5 | NaN | NaN | 5°FA |  |  |  |  | 0.039 | NaN | NaN | X=.0390 | 5 | NaN | NaN | 5°BA | 30 | NaN | NaN | 30°ISA | 0.023 | 0.001 | 0.001 | W=.0230±.0010
84 | 2031394 |  | 5209146 | 0 |  | Overlay & SG PA |  | 2031394-TF-A | OSG7-20-G SPECIAL (FL=033 2031394) |  |  |  |  |  |  |  |  |  |  |  |  |  |  |  |  |  | 0.0333 | 0.001 | 0.001 | FL=.0333±.0010 |  |  |  |  | 5 | NaN | NaN | 5°FA |  |  |  |  | 0.0354 | NaN | NaN | X=.0354 | 5 | NaN | NaN | 5°BA | 30 | NaN | NaN | 30°ISA | 0.036 | 0.001 | 0.001 | W=.0360±.0010
85 | 2031395 | SG-PA: 14008558T.etf | 5208815 | 136652 | Wed-Spec-Part1¦Wed-Spec-Part2 | Overlay & SG PA | 1 | 2031395-TF-A | OSG7-20-G SPECIAL (180-DEG-REV 2031395) |  | 2.62 | 0.005 | 0.005 | SG-PA: 2.62±.005 | 0.1249 | 0.0001 | 0.0001 | SG-PA: .1249±.0001 | 0.11 | 0.0005 | 0.0005 | SG-PA: .1100±.0005 | 0.0566 | 0.001 | 0.001 | SG-PA: .0566±.0010 {Wed-T.FL} | 0.0566 | 0.001 | 0.001 | FL=.0566±.0010¦SG-PA: .0566±.0010 {Wed-T.FL} |  |  |  |  | 5 | NaN | NaN | 5°FA |  |  |  |  | 0.024 | NaN | NaN | X=.024 | 5 | NaN | NaN | 5°BA | 30 | NaN | NaN | 30°ISA | 0.038 | 0.001 | 0.001 | W=.0380±.0010¦SG-PA: .0380±.0010
86 | 2031905 |  | 5209850 | 0 |  | Overlay & SG PA |  | 2031905-TF-A | OSG7-5-G SPECIAL (FL=012 2031905) |  |  |  |  |  |  |  |  |  |  |  |  |  |  |  |  |  | 0.012 | 0.0005 | 0.0005 | FL=.0120±.0005 |  |  |  |  | 5 | NaN | NaN | 5°FA |  |  |  |  | 0.046 | NaN | NaN | X=.046 | 5 | NaN | NaN | 5°BA | 30 | NaN | NaN | 30°ISA | 0.011 | 0.0005 | 0.0005 | W=.0110±.0005
87 | 2031906 | SG-PA: 14102014T.etf | 5209869 | 137360 | Wed-Spec-Part1¦Wed-Spec-Part2 | Overlay & SG PA | 1 | 2031906-TF-A | OSG7-10-G SPECIAL (FL=0244 2031906) |  | 2.5 | 0.005 | 0.005 | SG-PA: 2.50±.005 | 0.1249 | 0.0001 | 0.0001 | SG-PA: .1249±.0001 | 0.11 | 0.0005 | 0.0005 | SG-PA: .1100±.0005 | 0.0244 | 0.001 | 0.001 | SG-PA: .0244±.0010 {Wed-T.FL} | 0.0244 | 0.001 | 0.001 | FL=.0244±.0010¦SG-PA: .0244±.0010 {Wed-T.FL} |  |  |  |  | 5 | NaN | NaN | 5°FA |  |  |  |  | 0.0398 | NaN | NaN | X=.0398 | 5 | NaN | NaN | 5°BA | 30 | NaN | NaN | 30°ISA | 0.019 | 0.001 | 0.001 | W=.0190±.0010¦SG-PA: .0190±.0010
88 | 2031907 | SG-PA: 14102014T.etf | 5209870 | 137361 | Wed-Spec-Part1¦Wed-Spec-Part2 | Overlay & SG PA | 1 | 2031907-TF-A | OSG7-15-G SPECIAL (FL=0366 2031907) |  | 2.5 | 0.005 | 0.005 | SG-PA: 2.50±.005 | 0.1249 | 0.0001 | 0.0001 | SG-PA: .1249±.0001 | 0.11 | 0.0005 | 0.0005 | SG-PA: .1100±.0005 | 0.0366 | 0.001 | 0.001 | SG-PA: .0366±.0010 {Wed-T.FL} | 0.0366 | 0.001 | 0.001 | FL=.0366±.0010¦SG-PA: .0366±.0010 {Wed-T.FL} |  |  |  |  | 5 | NaN | NaN | 5°FA |  |  |  |  | 0.0337 | 0.001 | 0.001 | X=.0337±.0010 | 5 | NaN | NaN | 5°BA | 30 | NaN | NaN | 30°ISA | 0.029 | 0.001 | 0.001 | W=.0290±.0010¦SG-PA: .0290±.0010
89 | 2031908 | SG-PA: 14102014T.etf | 5209871 | 137362 | Wed-Spec-Part1¦Wed-Spec-Part2 | Overlay & SG PA | 1 | 2031908-TF-A | OSG7-20-G SPECIAL (FL=0487 2031908) |  | 2.5 | 0.005 | 0.005 | SG-PA: 2.50±.005 | 0.1249 | 0.0001 | 0.0001 | SG-PA: .1249±.0001 | 0.11 | 0.0005 | 0.0005 | SG-PA: .1100±.0005 | 0.0487 | 0.001 | 0.001 | SG-PA: .0487±.0010 {Wed-T.FL} | 0.0487 | 0.001 | 0.001 | FL=.0487±.0010¦SG-PA: .0487±.0010 {Wed-T.FL} |  |  |  |  | 5 | NaN | NaN | 5°FA |  |  |  |  | 0.0276 | NaN | NaN | X=.0276 | 5 | NaN | NaN | 5°BA | 30 | NaN | NaN | 30°ISA | 0.038 | 0.001 | 0.001 | W=.0380±.0010¦SG-PA: .0380±.0010
90 | 2032082 |  | 5210108¦5221605 | 0 |  | Overlay & SG PA |  | 2032082-TF-A | OSG7-20-G SPECIAL (20ISA 2032082) |  |  |  |  |  |  |  |  |  |  |  |  |  |  |  |  |  | 0.0566 | 0.001 | 0.001 | FL=.0566±.0010 |  |  |  |  | 5 | NaN | NaN | 5°FA |  |  |  |  | 0.0237 | NaN | NaN | X=.0237 | 5 | NaN | NaN | 5°BA | 20 | NaN | NaN | 20°ISA | 0.038 | 0.001 | 0.001 | W=.0380±.0010
91 | 2032276 |  | 5210727 | 0 |  | Overlay & SG PA |  | 2032276-TF-A | OSG7-15-G SPECIAL (2032276) |  |  |  |  |  |  |  |  |  |  |  |  |  |  |  |  |  | 0.0425 | 0.001 | 0.001 | FL=.0425±.0010 |  |  |  |  | 5 | NaN | NaN | 5°FA |  |  |  |  | 0.0307 | 0.001 | 0.001 | X=.0307±.0010 | 5 | NaN | NaN | 5°BA | 20 | NaN | NaN | 20°ISA | 0.029 | 0.001 | 0.001 | W=.0290±.0010
92 | 2033079 | SG-PA: 14102014T.etf | 5212535¦5214803 | 138307¦0 | Wed-Spec-Part1¦Wed-Spec-Part2 | Overlay & SG PA | 1 | 2033079-TF-A | OSG7-10-G SPECIAL (FL=021 2033079) |  | 2.5 | 0.005 | 0.005 | SG-PA: 2.5±.005 | 0.1249 | 0.0001 | 0.0001 | SG-PA: .1249±.0001 | 0.11 | 0.0005 | 0.0005 | SG-PA: .1100±.0005 | 0.021 | 0.0005 | 0.0005 | SG-PA: .0210±.0005 {Wed-T.FL} | 0.021 | 0.0005 | 0.0005 | FL=.0210±.0005¦SG-PA: .0210±.0005 {Wed-T.FL} |  |  |  |  | 5 | NaN | NaN | 5°FA |  |  |  |  | 0.0415 | NaN | NaN | X=.0415 | 5 | NaN | NaN | 5°BA | 30 | NaN | NaN | 30°ISA | 0.019 | 0.0005 | 0.0005 | W=.0190±.0005¦SG-PA: .0190±.0005
93 | 2033174 | SG-PA: 14102014T.etf | 5213116 | 138005 | Wed-Spec-Part1¦Wed-Spec-Part2 | Overlay & SG PA | 1 | 2033174-TF-B | OSG7-20-G SPECIAL (FL=042 B=0195 2033174 |  | 2.5 | 0.005 | 0.005 | SG-PA: 2.5±.005 | 0.1249 | 0.0001 | 0.0001 | SG-PA: .1249±.0001 | 0.11 | 0.0005 | 0.0005 | SG-PA: .1100±.0005 | 0.042 | 0.001 | 0.001 | SG-PA: .0420±.0010 {Wed-T.FL} | 0.042 | 0.001 | 0.001 | FL=.0420±.0010¦SG-PA: .0420±.0010 {Wed-T.FL} |  |  |  |  | 5 | NaN | NaN | 5°FA |  |  |  |  | 0.0309 | 0.001 | 0.001 | X=.0309±.0010 | 5 | NaN | NaN | 5°BA |  |  |  |  | 0.04 | 0.001 | 0.001 | W=.0400±.0010¦SG-PA: .0400±.0010
94 | 2033249 |  | 5214493 | 0 |  | Overlay & SG PA |  | 2033249-TF-A | OSG7-15-G SPECIAL (FL=0375 20ISA 2033249) |  |  |  |  |  |  |  |  |  |  |  |  |  |  |  |  |  | 0.0375 | 0.001 | 0.001 | FL=.0375±.0010 |  |  |  |  | 5 | NaN | NaN | 5°FA |  |  |  |  | 0.0333 | NaN | NaN | X=.0333 | 5 | NaN | NaN | 5°BA | 20 | NaN | NaN | 20°ISA | 0.03 | 0.001 | 0.001 | W=.0300±.0010
95 | 2033253 |  | 5214309 | 0 |  | Overlay & SG PA |  | 2033253-TF-A | OSG7-10-G SPECIAL (2033253) |  |  |  |  |  |  |  |  |  |  |  |  |  |  |  |  |  | 0.0284 | 0.001 | 0.001 | FL=.0284±.0010 |  |  |  |  | 5 | NaN | NaN | 5°FA |  |  |  |  | 0.0378 | 0.001 | 0.001 | X=.0378±.0010 | 5 | NaN | NaN | 5°BA | 30 | NaN | NaN | 30°ISA | 0.019 | 0.001 | 0.001 | W=.0190±.0010
96 | 2034297 |  | 5216117 | 0 |  | Overlay & SG PA |  | 2034297-TF-A | OSG7-15-G SPECIAL ( 2034297) |  |  |  |  |  |  |  |  |  |  |  |  |  |  |  |  |  | 0.0425 | 0.001 | 0.001 | FL=.0425±.0010 |  |  |  |  | 5 | NaN | NaN | 5°FA |  |  |  |  | 0.03675 | REF | REF | X=.03675 (REF) | 5 | NaN | NaN | 5°BA |  |  |  |  | 0.0305 | 0.001 | 0.001 | W=.0305±.0010
97 | 2034298 | SG-PA: 14102014T.etf | 5215979¦5215980¦5215981 | 138805¦139154¦139155 | Wed-Spec-Part1¦Wed-Spec-Part2 | Overlay & SG PA | 1 | 2034298-TF-A | OSG7-15-G SPECIAL (FL=0316 2034298) |  | 2.5 | 0.005 | 0.005 | SG-PA: 2.50±.005 | 0.1249 | 0.0001 | 0.0001 | SG-PA: .1249±.0001 | 0.11 | 0.0005 | 0.0005 | SG-PA: .1100±.0005 | 0.0316 | 0.001 | 0.001 | SG-PA: .0316±.0010 {Wed-T.FL} | 0.0316 | 0.001 | 0.001 | FL=.0316±.0010¦SG-PA: .0316±.0010 {Wed-T.FL} |  |  |  |  | 5 | NaN | NaN | 5°FA |  |  |  |  | 0.0362 | 0.001 | 0.001 | X=.0362±.0010 | 5 | NaN | NaN | 5°BA | 30 | NaN | NaN | 30°ISA | 0.029 | 0.001 | 0.001 | W=.0290±.0010¦SG-PA: .0290±.0010
98 | 2034299 | SG-PA: 14102014T.etf | 5224402 | 141553 | Wed-Spec-Part1¦Wed-Spec-Part2 | Overlay & SG PA | 1 | 2034299-TF-A | OSG7-5 SPECIAL (2034299) |  | 2.5 | 0.005 | 0.005 | SG-PA: 2.50±.005 | 0.1249 | 0.0001 | 0.0001 | SG-PA: .1249±.0001 | 0.11 | 0.0005 | 0.0005 | SG-PA: .1100±.0005 | 0.0152 | 0.0003 | 0.0003 | SG-PA: .0152±.0003 {Wed-T.FL} | 0.0152 | 0.0003 | 0.0003 | FL=.0152±.0003¦SG-PA: .0152±.0003 {Wed-T.FL} |  |  |  |  | 5 | NaN | NaN | 5°FA |  |  |  |  | 0.0444 | 0.001 | 0.001 | X=.0444±.0010 | 5 | NaN | NaN | 5°BA | 30 | NaN | NaN | 30°ISA | 0.011 | 0.0005 | 0.0005 | W=.0110±.0005¦SG-PA: .0110±.0005
99 | 2034302 |  | 5216752 | 0 |  | Overlay & SG PA |  | 2034302-TF-A | 180-DEG-REV¶OSG7-12-G SPECIAL ( 2034302) |  |  |  |  |  |  |  |  |  |  |  |  |  |  |  |  |  | 0.0344 | 0.001 | 0.001 | FL=.0344±.0010 |  |  |  |  | 5 | NaN | NaN | 5°FA |  |  |  |  | 0.0408 | REF | REF | X=.0408 (REF) | 5 | NaN | NaN | 5°BA |  |  |  |  | 0.024 | 0.001 | 0.001 | W=.0240±.0010
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
111 | 2034892 | SG-PA: 14102014T.etf | 5217481 | 139278 | Wed-Spec-Part1¦Wed-Spec-Part2 | Overlay & SG PA | 1 | 2034892-TF-A | OSG7-20-G SPECIAL (20ISA W=035 VW=0353 VR=040 FL=033 VFL=075 FX=0385 2034892) |  | 2.5 | 0.005 | 0.005 | SG-PA: 2.5±.005 | 0.1249 | 0.0001 | 0.0001 | SG-PA: .1249±.0001 | 0.11 | 0.0005 | 0.0005 | SG-PA: .1100±.0005 | 0.033 | 0.001 | 0.001 | SG-PA: .0330±.0010 {Wed-T.FL} | 0.033 | 0.001 | 0.001 | FL=.0330±.0010¦SG-PA: .0330±.0010 {Wed-T.FL} | 0.075 | 0 | 0.003 | VFL=.075+.003/-0 | 0 | NaN | NaN | 0°FA | 0.0385 | 0.001 | 0.001 | FX=.0385±.0010 | 0.0385 | REF | REF | X=.0385 (REF) | 5 | NaN | NaN | 5°BA | 20 | NaN | NaN | 20°ISA | 0.035 | 0.001 | 0.001 | W=.0350±.0010¦SG-PA: .0350±.0010 | 0.0353
112 | 2034974 |  | 5217819 | 0 |  | Overlay & SG PA |  | 2034974-TF-A | OSG7-20-G SPECIAL 2034974-DW |  |  |  |  |  |  |  |  |  |  |  |  |  |  |  |  |  | 0.0555 | 0.0005 | 0.0005 | FL=.0555±.0005 |  |  |  |  | 5 | NaN | NaN | 5°FA |  |  |  |  | 0.0243 | 0.001 | 0.001 | X=.0243±.0010 | 5 | NaN | NaN | 5°BA | 30 | NaN | NaN | 30°ISA | 0.0382 | 0.0005 | 0.0005 | W=.0382±.0005
113 | 2035307 |  | 5219147 | 0 |  | Overlay & SG PA |  | 2035307-TF-A | OSG7-15-G SPECIAL (FL=0415 B=0146 2035307) |  |  |  |  |  |  |  |  |  |  |  |  |  |  |  |  |  | 0.0415 | 0.0005 | 0.0005 | FL=.0415±.0005 |  |  |  |  | 5 | NaN | NaN | 5°FA |  |  |  |  | 0.0313 | NaN | NaN | X=.0313 | 5 | NaN | NaN | 5°BA | 30 | NaN | NaN | 30°ISA | 0.03 | 0.0005 | 0.0005 | *W=.0300±.0005
114 | 2035316 | SG-PA: 14102014T.etf | 5219923 | 140148 | Wed-Spec-Part1¦Wed-Spec-Part2 | Overlay & SG PA | 1 | 2035316-TF-A | OSG7-20-G SPECIAL (FL=0388 2035316) |  | 2.5 | 0.005 | 0.005 | SG-PA: 2.5±.005 | 0.1249 | 0.0001 | 0.0001 | SG-PA: .1249±.0001 | 0.11 | 0.0005 | 0.0005 | SG-PA: .1100±.0005 | 0.0388 | 0.001 | 0.001 | SG-PA: .0388±.0010 {Wed-T.FL} | 0.0388 | 0.001 | 0.001 | FL=.0388±.0010¦MAKE FL=.0388 AND COIN ¶ IN THE MIDDLE (.0067 REF) FROM F¦SG-PA: .0388±.0010 {Wed-T.FL} |  |  |  |  | 5 | NaN | NaN | 5°FA |  |  |  |  | 0.0326 | 0.001 | 0.001 | X=.0326±.0010 | 5 | NaN | NaN | 5°BA | 30 | NaN | NaN | 30°ISA | 0.038 | 0.001 | 0.001 | W=.0380±.0010¦SG-PA: .0380±.0010
115 | 2035395 |  | 5221286 | 0 |  | Overlay & SG PA |  | 2035395-TF-C | OSG7-5-G SPECIAL (FL=0145 B=0049 2035395) |  |  |  |  |  |  |  |  |  |  |  |  |  |  |  |  |  | 0.0145 | 0.0005 | 0.0005 | FL=.0145±.0005 |  |  |  |  | 5 | NaN | NaN | 5°FA |  |  |  |  | 0.0442 | NaN | NaN | X=.0442 | 5 | NaN | NaN | 5°BA | 30 | NaN | NaN | 30°ISA | 0.0105 | 0.0005 | 0.0005 | *W=.0105±.0005
116 | 2035398 |  | 5221285 | 0 |  | Overlay & SG PA |  | 2035398-TF-A | OSG7-12-G SPECIAL¶(FL=0335 B=0118 2035398) |  |  |  |  |  |  |  |  |  |  |  |  |  |  |  |  |  | 0.0335 | 0.001 | 0.001 | FL=.0335±.0010 |  |  |  |  | 5 | NaN | NaN | 5°FA |  |  |  |  | 0.0365 | 0.001 | 0.001 | X=.0365±.0010 | 5 | NaN | NaN | 5°BA | 30 | NaN | NaN | 30°ISA | 0.023 | 0.001 | 0.001 | W=.0230±.0010
117 | 2035399 |  | 5221659 | 0 |  | Overlay & SG PA |  | 2035399-TF-A | OSG7-16-G SPACIAL (FL=044 B=0157 2035399) |  |  |  |  |  |  |  |  |  |  |  |  |  |  |  |  |  | 0.044 | 0.001 | 0.001 | FL=.0440±.0010 |  |  |  |  | 5 | NaN | NaN | 5°FA |  |  |  |  | 0.03 | 0.001 | 0.001 | X=.0300±.0010 | 5 | NaN | NaN | 5°BA | 30 | NaN | NaN | 30°ISA | 0.032 | 0.001 | 0.001 | W=.0320±.0010
118 | 2035400 |  | 5221660 | 0 |  | Overlay & SG PA |  | 2035400-TF-A | OSG7-20-G SPECIAL (FL=0555 B=0197 2035400) |  |  |  |  |  |  |  |  |  |  |  |  |  |  |  |  |  | 0.0555 | 0.001 | 0.001 | FL=.0555±.0010 |  |  |  |  | 5 | NaN | NaN | 5°FA |  |  |  |  | 0.0243 | 0.001 | 0.001 | X=.0243±.0010 | 5 | NaN | NaN | 5°BA | 30 | NaN | NaN | 30°ISA | 0.0382 | 0.001 | 0.001 | W=.0382±.0010
119 | 2035401 | SG-PA: 14102014T.etf | 5219283 | 140175 | Wed-Spec-Part1¦Wed-Spec-Part2 | Overlay & SG PA | 1 | 2035401-TF-A | OSG7-15-G SPECIAL ( 2035401) |  | 2.62 | 0.005 | 0.005 | SG-PA: 2.62±.005 | 0.1249 | 0.0001 | 0.0001 | SG-PA: .1249±.0001 | 0.11 | 0.0005 | 0.0005 | SG-PA: .1100±.0005 | 0.0425 | 0.001 | 0.001 | SG-PA: .0425±.0010 {Wed-T.FL} | 0.0425 | 0.001 | 0.001 | FL=.0425±.0010¦SG-PA: .0425±.0010 {Wed-T.FL} |  |  |  |  | 5 | NaN | NaN | 5°FA |  |  |  |  | 0.03675 | REF | REF | X=.03675 (REF) | 5 | NaN | NaN | 5°BA |  |  |  |  | 0.0305 | 0.001 | 0.001 | W=.0305±.0010¦SG-PA: .0305±.0010
120 | 2035402 | SG-PA: 14102014T.etf | 5219284 | 140178 | Wed-Spec-Part1¦Wed-Spec-Part2 | Overlay & SG PA | 1 | 2035402-TF-A | OSG7-15-G SPECIAL C2 ( 2035402)¦OSG7-15-G SPECIAL C2 ( 20354027) |  | 2.62 | 0.005 | 0.005 | SG-PA: 2.62±.005 | 0.1249 | 0.0001 | 0.0001 | SG-PA: .1249±.0001 | 0.11 | 0.0005 | 0.0005 | SG-PA: .1100±.0005 | 0.0425 | 0.001 | 0.001 | SG-PA: .0425±.0010 {Wed-T.FL} | 0.0425 | 0.001 | 0.001 | FL=.0425±.0010¦SG-PA: .0425±.0010 {Wed-T.FL} |  |  |  |  | 5 | NaN | NaN | 5°FA |  |  |  |  | 0.03675 | REF | REF | X=.03675 (REF) | 5 | NaN | NaN | 5°BA |  |  |  |  | 0.0305 | 0.001 | 0.001 | W=.0305±.0010¦SG-PA: .0305±.0010
121 | 2035666 | SG-PA: 14102014T.etf | 5220886 | 140304 | Wed-Spec-Part1¦Wed-Spec-Part2 | Overlay & SG PA | 1 | 2035666-TF-B | OSG7-20-G SPECIAL (20ISA W=031 VW=0353 VR=040 FL=033 VFL=075 FX=0385 2035666) |  | 2.5 | 0.005 | 0.005 | SG-PA: 2.5±.005 | 0.1249 | 0.0001 | 0.0001 | SG-PA: .1249±.0001 | 0.11 | 0.0005 | 0.0005 | SG-PA: .1100±.0005 | 0.033 | 0.001 | 0.001 | SG-PA: .0330±.0010 {Wed-T.FL} | 0.033 | 0.001 | 0.001 | FL=.0330±.0010¦SG-PA: .0330±.0010 {Wed-T.FL} | 0.075 | 0 | 0.003 | VFL=.075+.003/-0 | 0 | NaN | NaN | 0°FA | 0.0385 | 0.001 | 0.001 | FX=.0385±.0010 | 0.0385 | REF | REF | X=.0385 (REF) | 5 | NaN | NaN | 5°BA | 20 | NaN | NaN | 20°ISA | 0.031 | 0.001 | 0.001 | W=.0310±.0010¦SG-PA: .0310±.0010 | 0.0353
122 | 2035991 |  | 5221321 | 0 |  | Overlay & SG PA |  | 2035991-TF-A | OSG7-15-G SPECIAL (180-DEG-REV 2035991) |  |  |  |  |  |  |  |  |  |  |  |  |  |  |  |  |  | 0.0425 | 0.001 | 0.001 | FL=.0425±.0010 |  |  |  |  | 5 | NaN | NaN | 5°FA |  |  |  |  | 0.0307 | 0.001 | 0.001 | X=.0307±.0010 | 5 | NaN | NaN | 5°BA | 30 | NaN | NaN | 30°ISA | 0.029 | 0.001 | 0.001 | W=.0290±.0010
123 | 2036069 | SG-PA: 14102014T.etf | 5221935 | 140728 | Wed-Spec-Part1¦Wed-Spec-Part2 | Overlay & SG PA | 1 | 2036069-TF-B | OSG7-20-G SPECIAL (20ISA W=031 VW=0353 VR=040 FL=033 VFL=075 FX=0385 2036069 |  | 1.97 | 0.005 | 0.005 | SG-PA: 1.970±.005 | 0.1249 | 0.0001 | 0.0001 | SG-PA: .1249±.0001 | 0.11 | 0.0005 | 0.0005 | SG-PA: .1100±.0005 | 0.033 | 0.001 | 0.001 | SG-PA: .0330±.0010 {Wed-T.FL} | 0.033 | 0.001 | 0.001 | FL=.0330±.0010¦SG-PA: .0330±.0010 {Wed-T.FL} | 0.075 | 0 | 0.003 | VFL=.075+.003/-0¦0°FA VFL=.075 | 0 | NaN | NaN | 0°FA VFL=.075 | 0.0385 | 0.001 | 0.001 | FX=.0385±.0010 |  |  |  |  | 5 | NaN | NaN | 5°BA | 20 | NaN | NaN | 20°ISA | 0.031 | 0.001 | 0.001 | W=.0310±.0010¦SG-PA: .0310±.0010 | 0.0353
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
135 | 22000135 | SG-PA: 22000135T.etf | 3113014¦3113073¦3127396 | 117025¦116907¦0 | Wed-Spec-Part1¦Wed-Spec-Part2 | Overlay & SG PA |  | 220-00135-TF-E | OSG7-10-G 220-00135 |  | 63.5 | 0.13 | 0.13 | SG-PA: 63.5±.130 | 0.1249 | 0.0001 | 0.0001 | SG-PA: .1249±.0001 | 0.11 | 0.0005 | 0.0005 | SG-PA: .110±.0005 | 0.0283 | 0.001 | 0.001 | SG-PA: .0283±.0010 {Wed-T.FL} | 0.0283 | 0.001 | 0.001 | FL=.0283±.0010¦SG-PA: .0283±.0010 {Wed-T.FL} |  |  |  |  | 5 | NaN | NaN | 5°FA |  |  |  |  | 0.0379 | NaN | NaN | X=.0379 | 5 | NaN | NaN | 5°BA | 30 | NaN | NaN | 30°ISA | 0.02 | 0.001 | 0.001 | W=.0200±.0010¦SG-PA: .0200±.0010
136 | 22000497 |  | 5209610 | 0 |  | Overlay & SG PA |  | 220-00497-TF-B | OSG7-380-G SPECIAL (FL=036 220-00497-DW) |  |  |  |  |  |  |  |  |  |  |  |  |  |  |  |  |  | 0.036 | 0.001 | 0.001 | FL=.0360±.0010 |  |  |  |  | 5 | NaN | NaN | 5°FA |  |  |  |  | 0.034 | NaN | NaN | X=.034 | 5 | NaN | NaN | 5°BA | 30 | NaN | NaN | 30°ISA | 0.03 | 0.001 | 0.001 | W=.0300±.0010
137 | 22000533 |  | 5205983 | 0 |  | Overlay & SG PA |  | 220-00533-TF-B | OSG7-150-G SPECIAL¶(FL=0140 TDF=110 DWG 220-00533-DW) |  |  |  |  |  |  |  |  |  |  |  |  |  |  |  |  |  | 0.014 | 0.0005 | 0.0005 | FL=.0140±.0005 |  |  |  |  | 5 | NaN | NaN | 5°FA |  |  |  |  | 0.045 | NaN | NaN | X=.0450 | 5 | NaN | NaN | 5°BA | 30 | NaN | NaN | 30°ISA | 0.012 | 0.0005 | 0.0005 | W=.0120±.0005
138 | 22000535 | SG-PA: 22000535T.etf¦SG-PA: 14102014T.etf | 3113009¦3116154¦3128871¦5204110 | 117009¦133694¦129948¦135092 | Wed-Spec-Part1¦Wed-Spec-Part2 | Overlay & SG PA | 1 | 220-00535-TF-C | OSG7-100 SPECIAL FL=010 (TDF=110 220-00535-DW) |  | 2.5¦63.5 | 0.005¦0.13 | 0.005¦0.13 | SG-PA: 63.5±0.13¦SG-PA: 2.50±.005¦SG-PA: 2.5±.005 | 0.1249 | 0.0001 | 0.0001 | SG-PA: .1249±.0001 | 0.11 | 0.0005 | 0.0005 | SG-PA: .110±.0005¦SG-PA: .1100±.0005 | 0.01 | 0.0005 | 0.0005 | SG-PA: .0100±.0005 {Wed-T.FL} | 0.01 | 0.0005 | 0.0005 | FL=.0100±.0005¦SG-PA: .0100±.0005 {Wed-T.FL} |  |  |  |  | 5 | NaN | NaN | 5°FA |  |  |  |  | 0.0475 | NaN | NaN | X=.0475 | 5 | NaN | NaN | 5°BA | 30 | NaN | NaN | 30°ISA | 0.009 | 0.0005 | 0.0005 | W=.0090±.0005¦SG-PA: .0090±.0005
139 | 22000591 | SG-PA: 22000591T.etf¦SG-PA: 14102014T.etf | 3114767¦3128676 | 117867¦129862 | Wed-Spec-Part1¦Wed-Spec-Part2 | Overlay & SG PA | 1 | 220-00591-TF-F | OSG7-380 SPECIAL (FL=031 220-00591-DW) |  | 2.5¦63.5 | 0.005¦13 | 0.005¦13 | SG-PA: 63.5±13¦SG-PA: 2.50±.005 | 0.1249 | 0.0001 | 0.0001 | SG-PA: .1249±.0001 | 0.11 | 0.0005 | 0.0005 | SG-PA: 0.11±.0005¦SG-PA: .1100±.0005 | 0.031 | 0.001 | 0.001 | SG-PA: .0310±.0010 {Wed-T.FL} | 0.031 | 0.001 | 0.001 | FL=.0310±.0010¦SG-PA: .0310±.0010 {Wed-T.FL} |  |  |  |  | 5 | NaN | NaN | 5°FA |  |  |  |  | 0.0365 | NaN | NaN | X=.0365 | 5 | NaN | NaN | 5°BA | 30 | NaN | NaN | 30°ISA | 0.029 | 0.0005¦0.001 | 0.0005¦0.001 | W=.0290±.0010¦SG-PA: 0.029±.0005¦SG-PA: .0290±.0010
140 | 22000614 | SG-PA: 22000614T.etf | 3113062 | 116912 | Wed-Spec-Part1¦Wed-Spec-Part2 | Overlay & SG PA | 1 | 220-00614-TF-C | OSG7-200-G SPECIAL (SPEC BR REL DWG 220-00614-DW) |  | 63.5 | 13 | 13 | SG-PA: 63.5±13 |  |  |  |  | 0.11 | 0.0005 | 0.0005 | SG-PA: .110±.0005 |  |  |  |  | 0.0215 | 0.0005 | 0.0005 | FL=.0215±.0005 |  |  |  |  | 5 | NaN | NaN | 5°FA |  |  |  |  | 0.0413 | NaN | NaN | X=.0413 | 5 | NaN | NaN | 5°BA | 30 | NaN | NaN | 30°ISA | 0.0147 | 0.0005 | 0.0005 | W=.0147±.0005¦SG-PA: .0147±.0005
141 | 22000615 | SG-PA: 14102014T.etf | 3113044 | 129003 | Wed-Spec-Part1¦Wed-Spec-Part2 | Overlay & SG PA | 1 | 220-00615-TF-C | OSG7-150 SPECIAL (FL=0165 TDF=110¶SPECIAL BR REL) DWG 220-00615-DW |  | 2.5 | 0.005 | 0.005 | SG-PA: 2.50±.005 | 0.1249 | 0.0001 | 0.0001 | SG-PA: .1249±.0001 | 0.11 | 0.0005 | 0.0005 | SG-PA: .1100±.0005 | 0.0165 | 0.0005 | 0.0005 | SG-PA: .0165±.0005 {Wed-T.FL} | 0.0165 | 0.0005 | 0.0005 | FL=.0165±.0005¦SG-PA: .0165±.0005 {Wed-T.FL} |  |  |  |  | 5 | NaN | NaN | 5°FA |  |  |  |  | 0.0437 | NaN | NaN | X=.0437 | 5 | NaN | NaN | 5°BA | 30 | NaN | NaN | 30°ISA | 0.012 | 0.0005 | 0.0005 | W=.0120±.0005¦SG-PA: .0120±.0005
142 | 22000621 | SG-PA: 22000621T.etf | 3113027¦3113029 | 116911¦117008 | Wed-Spec-Part1¦Wed-Spec-Part2 | Overlay & SG PA | 1 | 220-00621-TF-E | OSG7-125 SPECIAL¶(FL=016 TDF=110 SPECIAL BR REL 220-00621-DW) |  | 63.5 | 0.13 | 0.13 | SG-PA: 63.5±0.13 |  |  |  |  | 0.11 | 0.0005 | 0.0005 | SG-PA: .110±.0005 |  |  |  |  | 0.016 | 0.0005 | 0.0005 | FL=.0160±.0005 |  |  |  |  | 5 | NaN | NaN | 5°FA |  |  |  |  | 0.044 | NaN | NaN | X=.044 | 5 | NaN | NaN | 5°BA | 30 | NaN | NaN | 30°ISA | 0.0108 | 0.0005 | 0.0005 | W=.0108±.0005¦SG-PA: .0108±.0005
143 | 22000622 | SG-PA: 22000622T.etf | 3113072 | 117006 | Wed-Spec-Part1¦Wed-Spec-Part2 | Overlay & SG PA | 1 | 220-00622-TF-C | OSG7-250 SPECIAL (FL=0285 TDF=110¶SPEC BR REL 220-00622-DW) |  | 63.5 | 0.13 | 0.13 | SG-PA: 63.5±0.13 |  |  |  |  | 0.11 | 0.0005 | 0.0005 | SG-PA: .110±.0005 | 0.0242 | NaN | NaN | SG-PA: .0242 {Wed-T.FL} | 0.0242¦0.0285 | 0.0005 | 0.0005 | FL=.0285±.0005¦SG-PA: .0242 {Wed-T.FL} |  |  |  |  | 5 | NaN | NaN | 5°FA |  |  |  |  | 0.038 | NaN | NaN | X=.038 | 5 | NaN | NaN | 5°BA | 30 | NaN | NaN | 30°ISA | 0.0192 | 0.0005 | 0.0005 | W=.0192±.0005¦SG-PA: .0192±.0005
144 | 22000948 | SG-PA: 22000948T.etf¦SG-PA: 14102014T.etf | 3113089¦3115255 | 116920¦131134 | Wed-Spec-Part1¦Wed-Spec-Part2 | Overlay & SG PA | 1 | 220-00948-TF-C | OSG7-380 SPECIAL (FL=031 220-00948-DW) |  | 2.5¦63.5 | 0.005¦13 | 0.005¦13 | SG-PA: 63.5±13¦SG-PA: 2.500±.005 | 0.1249 | 0.0001 | 0.0001 | SG-PA: .1249±.0001 | 0.11 | 0.0005 | 0.0005 | SG-PA: .110±.0005¦SG-PA: .1100±.0005 | 0.031 | 0.0005 | 0.0005 | SG-PA: .0310±.0005 {Wed-T.FL} | 0.031 | 0.0005 | 0.0005 | FL=.0310±.0005¦SG-PA: .0310±.0005 {Wed-T.FL} |  |  |  |  | 5 | NaN | NaN | 5°FA |  |  |  |  | 0.0365 | NaN | NaN | X=.0365 | 5 | NaN | NaN | 5°BA | 30 | NaN | NaN | 30°ISA | 0.029 | 0.0005 | 0.0005 | W=.0290±.0005¦SG-PA: .0290±.0005
145 | 22000979 |  | 5205988 | 0 |  | Overlay & SG PA |  | 220-00979-TF-A | OSG7-200 STANDARD (TDF=110) |  |  |  |  |  |  |  |  |  |  |  |  |  |  |  |  |  | 0.0216¦0.0226 | 0.0005¦REF | 0.0005¦REF | GRINDING FL¦FINISHED FL=.0216 (REF)¦GRINDING FL=.0226±.0005 |  |  |  |  | 5 | NaN | NaN | 5°FA |  |  |  |  | 0.0407 | NaN | NaN | X=.0407 | 5 | NaN | NaN | 5°BA |  |  |  |  | 0.016 | 0.0005 | 0.0005 | W=.0160±.0005
146 | 22001102 | SG-PA: 22001102T.etf | 3113015 | 117020 | Wed-Spec-Part1¦Wed-Spec-Part2 | Overlay & SG PA |  | 220-01102-TF-D | OSG7-10-G SPECIAL (NFL) 220-01102-DW |  |  |  |  |  |  |  |  |  |  |  |  |  |  |  |  |  | 0.0283 | 0.0005 | 0.0005 | FL=.0283±.0005 |  |  |  |  | 5 | NaN | NaN | 5°FA |  |  |  |  | 0.0385 | NaN | NaN | X=.0385 | 5 | NaN | NaN | 5°BA | 30 | NaN | NaN | 30°ISA | 0.019 | 0.0005 | 0.0005 | W=.0190±.0005
147 | 22001104 | SG-PA: 22000135T.etf | 3129803 | 130374 | Wed-Spec-Part1¦Wed-Spec-Part2 | Overlay & SG PA |  | 220-01104-TF-D | OSG7-250 SPECIAL (W=019 FL=0283 TDF=110 DWG 220-01104-DW) |  | 63.5 | 0.13 | 0.13 | SG-PA: 63.5±.130 | 0.1249 | 0.0001 | 0.0001 | SG-PA: .1249±.0001 | 0.11 | 0.0005 | 0.0005 | SG-PA: .110±.0005 | 0.0283 | 0.001 | 0.001 | SG-PA: .0283±.0010 {Wed-T.FL} | 0.0283 | 0.0005¦0.001 | 0.0005¦0.001 | FL=.0283±.0005¦SG-PA: .0283±.0010 {Wed-T.FL} |  |  |  |  | 5 | NaN | NaN | 5°FA |  |  |  |  | 0.0385 | NaN | NaN | X=.0385 | 5 | NaN | NaN | 5°BA | 30 | NaN | NaN | 30°ISA | 0.019¦0.02 | 0.0005¦0.001 | 0.0005¦0.001 | W=.0190±.0005¦SG-PA: .0200±.0010
148 | 22001189 | SG-PA: 22001189T.etf | 3113057¦5206801¦5206802 | 116917¦136233¦136234 | Wed-Spec-Part1¦Wed-Spec-Part2 | Overlay & SG PA | 1 | 220-01189-TF-C | OSG7-175-GCG SPECIAL (TDF=110 FL=011¶FR=003 BR=005 GD=0045 B=008 DWG 220-01189-DW) |  | 64 | 13 | 13 | SG-PA: 64±13 |  |  |  |  |  |  |  |  | 0.011 | 0.0005 | 0.0005 | SG-PA: .0110±.0005 {Wed-T.FL} | 0.011 | 0.0005 | 0.0005 | FL=.0110±.0005¦SG-PA: .0110±.0005 {Wed-T.FL} |  |  |  |  | 5 | NaN | NaN | 5°FA |  |  |  |  | 0.047 | 0.0005 | 0.0005 | X=.0470±.0005 | 5 | NaN | NaN | 5°BA | 30 | NaN | NaN | 30°ISA | 0.014 | 0.0005 | 0.0005 | W=.0140±.0005¦SG-PA: .0140±.0005
149 | 22001246 | SG-PA: 14102014T.etf | 3113034¦3127397¦5217239¦5225959 | 140737¦0¦140586¦142132 | Wed-Spec-Part1¦Wed-Spec-Part2 | Overlay & SG PA | 1 | 220-01246-TF-C | OSG7-12-G SPECIAL 220-01246-DW |  | 2.5 | 0.005 | 0.005 | SG-PA: 2.50±.005 | 0.1249 | 0.0001 | 0.0001 | SG-PA: .1249±.0001 | 0.11 | 0.0005 | 0.0005 | SG-PA: .1100±.0005 | 0.0342 | 0.0015 | 0 | SG-PA: .0342+0/-.0015 {Wed-T.FL} | 0.0342¦0.0344 | 0.0015 | 0 | FL=.0342+0/-.0015¦FL DIMENSION TO BE CLOSE¶TO OE 127153-12 (FL=.0344)¦SG-PA: .0342+0/-.0015 {Wed-T.FL} |  |  |  |  | 5 | NaN | NaN | 5°FA |  |  |  |  | 0.036 | NaN | NaN | X=.036 | 5 | NaN | NaN | 5°BA | 30 | NaN | NaN | 30°ISA | 0.023 | 0.001 | 0.001 | W=.0230±.0010¦SG-PA: .0230±.0010
150 | 22001251 | SG-PA: 22001251T.etf | 3113064 | 117021 | Wed-Spec-Part1¦Wed-Spec-Part2 | Overlay & SG PA | 1 | 220-01251-TF-B | OSG7-20-G SPECIAL 220-01251-DW |  | 2.5 | 0.005 | 0.005 | SG-PA: 2.5±0.005 | 0.1249 | 0.0001 | 0.0001 | SG-PA: 0.1249±0.0001 | 0.11 | 0.0005 | 0.0005 | SG-PA: 0.11±0.0005 | 0.0555 | 0.0005 | 0.0005 | SG-PA: .0555±0.0005 {Wed-T.FL} | 0.0555 | 0.0005 | 0.0005 | FL=.0555±.0005¦SG-PA: .0555±0.0005 {Wed-T.FL} |  |  |  |  | 5 | NaN | NaN | 5°FA |  |  |  |  | 0.0243 | NaN | NaN | X=.0243 | 5 | NaN | NaN | 5°BA | 30 | NaN | NaN | 30°ISA | 0.0382 | 0.0005 | 0.0005 | W=.0382±.0005¦SG-PA: 0.0382±0.0005
151 | 22001253 | SG-PA: 22001253T.etf¦SG-PA: 22000392RT.etf | 3113047¦3113087¦3114712 | 117023¦116898¦113315 | Wed-Spec-Part1¦Wed-Spec-Part2 | Overlay & SG PA |  | 220-01253-TF-B | OSG7-15-G SPECIAL 220-01253-DW |  | 63.5 | 13 | 13 | SG-PA: 63.5±13 |  |  |  |  | 0.11 | 0.0005 | 0.0005 | SG-PA: .110±.0005 |  |  |  |  | 0.0415 | 0.0005 | 0.0005 | FL=.0415±.0005 |  |  |  |  | 5 | NaN | NaN | 5°FA |  |  |  |  | 0.0313 | NaN | NaN | X=.0313 | 5 | NaN | NaN | 5°BA | 30 | NaN | NaN | 30°ISA | 0.0288¦0.0298 | 0.0005 | 0.0005 | W=.0288±.0005¦SG-PA: .0288±.0005¦SG-PA: .0298±.0005
152 | 22001289 | SG-PA: 22001289T.etf | 3113107 | 117028 | Wed-Spec-Part1¦Wed-Spec-Part2 | Overlay & SG PA | 1 | 220-01289-TF-C | OSG7-5-G SPECIAL (NFL 220-01289-DW) |  | 63.5 | 13 | 13 | SG-PA: 63.5±13 |  |  |  |  | 0.11 | 0.005 | 0.005 | SG-PA: .110±+.005 | 0.0148 | 0.005 | 0.005 | SG-PA: .0148±+.005 {Wed-T.FL} | 0.0148 | 0.0005¦0.005 | 0.0005¦0.005 | CUSTOMER SPECIFIED DIMENSION (NOT BASED ON MASTER)¦FL=.0148±.0005¦SG-PA: .0148±+.005 {Wed-T.FL} |  |  |  |  | 5 | NaN | NaN | 5°FA |  |  |  |  | 0.0442 | NaN | NaN | X=.0442 | 5 | NaN | NaN | 5°BA | 30 | NaN | NaN | 30°ISA | 0.011 | 0.0005 | 0.0005 | CUSTOMER SPECIFIED DIMENSION (NOT BASED ON MASTER)¦W=.0110±.0005¦SG-PA: .0110±+.0005
153 | 22001292 | SG-PA: 22001292T.etf | 3113035¦3114711¦3129329 | 117041¦113710¦130197 | Wed-Spec-Part1¦Wed-Spec-Part2 | Overlay & SG PA | 1 | 220-01292-TF-D | OSG7-12-G 220-01292-DW |  | 63.5 | 13 | 13 | SG-PA: 63.5±13 |  |  |  |  | 0.11 | 0.0005 | 0.0005 | SG-PA: .110±.0005 | 0.0294 | 0.0005 | 0.0005 | SG-PA: .0294±.0005 {Wed-T.FL} | 0.0294 | 0.0005¦0.001 | 0.0005¦0.001 | FL=.0294±.0010¦SG-PA: .0294±.0005 {Wed-T.FL} |  |  |  |  | 5 | NaN | NaN | 5°FA |  |  |  |  | 0.0373 | NaN | NaN | X=.0373 | 5 | NaN | NaN | 5°BA | 30 | NaN | NaN | 30°ISA | 0.023 | 0.0005¦0.001 | 0.0005¦0.001 | W=.0230±.0010¦SG-PA: .0230±.0005
154 | 22001293 | SG-PA: 22001293T.etf¦SG-PA: 14102014T.etf | 3113051¦5201636 | 117031¦133648 | Wed-Spec-Part1¦Wed-Spec-Part2 | Overlay & SG PA | 1 | 220-01293-TF-C | OSG7-16-G SPECIAL (220-01293-DW) |  | 2.5¦63.5 | 0.005¦13 | 0.005¦13 | SG-PA: 63.5±13¦SG-PA: 2.5±.005 | 0.1249 | 0.0001 | 0.0001 | SG-PA: .1249±.0001 | 0.11 | 0.0005 | 0.0005 | SG-PA: .110±.0005¦SG-PA: .1100±.0005 | 0.039 | 0.001 | 0.001 | SG-PA: .0390±.0010 {Wed-T.FL} | 0.039 | 0.001 | 0.001 | FL=.0390±.0010¦SG-PA: .0390±.0010 {Wed-T.FL} |  |  |  |  | 5 | NaN | NaN | 5°FA |  |  |  |  | 0.0325 | NaN | NaN | X=.0325 | 5 | NaN | NaN | 5°BA | 30 | NaN | NaN | 30°ISA | 0.03 | 0.001 | 0.001 | W=.0300±.0010¦SG-PA: .0300±.0010
155 | 22001295 | SG-PA: 22001295T.etf | 3113065¦5215590 | 117032¦138705 | Wed-Spec-Part1¦Wed-Spec-Part2 | Overlay & SG PA | 1 | 220-01295-TF-C | OSG7-20-G SPECIAL (220-01295-DW) |  | 2.5 | 0.005 | 0.005 | SG-PA: 2.5±.005 | 0.1249 | 0.0001 | 0.0001 | SG-PA: .1249±.0001 | 0.11 | 0.005 | 0.005 | SG-PA: .110±+.005¦SG-PA: .1100±.005 | 0.042 | 0.001 | 0.001 | SG-PA: .0420±+.0010 {Wed-T.FL}¦SG-PA: .0420±.0010 {Wed-T.FL} | 0.042 | 0.001 | 0.001 | FL=.0420±.0010¦SG-PA: .0420±+.0010 {Wed-T.FL}¦SG-PA: .0420±.0010 {Wed-T.FL} |  |  |  |  | 5 | NaN | NaN | 5°FA |  |  |  |  | 0.031 | NaN | NaN | X=.031 | 5 | NaN | NaN | 5°BA | 30 | NaN | NaN | 30°ISA | 0.038 | 0.001 | 0.001 | W=.0380±.0010¦SG-PA: .0380±+.0010¦SG-PA: .0380±.0010
156 | 22001424 | SG-PA: 22001424T.etf | 3113108 | 117034 | Wed-Spec-Part1¦Wed-Spec-Part2 | Overlay & SG PA |  | 220-01424-TF-C | OSG7-5-G SPECIAL (NFL 220-01424-DW) |  |  |  |  |  |  |  |  |  |  |  |  |  |  |  |  |  | 0.0145 | 0.0005 | 0.0005 | FL=.0145±.0005 |  |  |  |  | 5 | NaN | NaN | 5°FA |  |  |  |  | 0.0442 | NaN | NaN | X=.0442 | 5 | NaN | NaN | 5°BA | 30 | NaN | NaN | 30°ISA | 0.0105 | 0.0005 | 0.0005 | W=.0105±.0005
157 | 22001442 | SG-PA: 22001442T.etf | 3113094¦3127398 | 117038¦0 | Wed-Spec-Part1¦Wed-Spec-Part2 | Overlay & SG PA |  | 220-01442-TF-B | OSG7-4-G SPECIAL 220-01442-DW |  |  |  |  |  |  |  |  |  |  |  |  |  |  |  |  |  | 0.0114 | 0.0005 | 0.0005 | FL=.0114±.0005 |  |  |  |  | 5 | NaN | NaN | 5°FA |  |  |  |  | 0.0463 | NaN | NaN | X=.0463 | 5 | NaN | NaN | 5°BA | 30 | NaN | NaN | 30°ISA | 0.0095 | 0.0005 | 0.0005 | W=.0095±.0005
158 | 22001497 |  | 3116849 | 0 |  | Overlay & SG PA |  | 220-01497-TF-A | OSG7-3-G SPECIAL (220-01497-DW) |  |  |  |  |  |  |  |  |  |  |  |  |  |  |  |  |  | 0.005 | 0.0003 | 0.0003 | FL=.0050±.0003 |  |  |  |  | 5 | NaN | NaN | 5°FA |  |  |  |  | 0.0495 | NaN | NaN | X=.0495 | 5 | NaN | NaN | 5°BA | 30 | NaN | NaN | 30°ISA | 0.0087 | 0.0003 | 0.0003 | W=.0087±.0003
159 | 22001672 | SG-PA: 14102014T.etf | 5220295 | 140198 | Wed-Spec-Part1¦Wed-Spec-Part2 | Overlay & SG PA | 1 | 220-01672-TF-A | OSG7-8-G SPECIAL (NFL 220-01672-DW) |  | 2.5 | 0.005 | 0.005 | SG-PA: 2.5±.005 | 0.1249 | 0.0001 | 0.0001 | SG-PA: .1249±.0001 | 0.11 | 0.0005 | 0.0005 | SG-PA: .1100±.0005 | 0.0195 | 0.0005 | 0.0005 | SG-PA: .0195±.0005 {Wed-T.FL} | 0.0195 | 0.0005 | 0.0005 | FL=.0195±.0005¦SG-PA: .0195±.0005 {Wed-T.FL} |  |  |  |  | 5 | NaN | NaN | 5°FA |  |  |  |  | 0.0433 | NaN | NaN | X=.0433 | 5 | NaN | NaN | 5°BA | 30 | NaN | NaN | 30°ISA | 0.0146 | 0.0005 | 0.0005 | W=.0146±.0005¦SG-PA: .0146±.0005
160 | 22001688 | SG-PA: 22001688T.etf | 3113069¦3113071 | 116919¦116918 | Wed-Spec-Part1¦Wed-Spec-Part2 | Overlay & SG PA |  | 220-01688-TF-F | OSG7-20-G SPECIAL (FL=033 VFL=075 FX=0385 220-01688-DW) |  | 2.5¦63.5 | 0.005¦13 | 0.005¦13 | SG-PA: 2.5±.005¦SG-PA: 63.5±13 | 0.1249 | 0.0001 | 0.0001 | SG-PA: .1249±.0001 | 0.11 | 0.0005 | 0.0005 | SG-PA: .110±.0005 | 0.033 | 0.001 | 0.001 | SG-PA: 0.0330±0.0010 {Wed-T.FL} | 0.033 | 0.001 | 0.001 | FL=.0330±.0010¦SG-PA: 0.0330±0.0010 {Wed-T.FL} | 0.075 | NaN | NaN | 0°FA VFL=.075 | 0 | NaN | NaN | 0°FA VFL=.075 |  |  |  |  | 0.0385 | NaN | NaN | X=.0385 | 5 | NaN | NaN | 5°BA | 30 | NaN | NaN | 30°ISA | 0.035 | 0.001 | 0.001 | W=.0350±.0010¦SG-PA: .0350±.001¦SG-PA: .0350±.0010
161 | 22001739 | SG-PA: 22001739T.etf | 3113067 | 117060 | Wed-Spec-Part1¦Wed-Spec-Part2 | Overlay & SG PA |  | 220-01739-TF-A | OSG7-20-G SPECIAL (FL=030 W=035 220-01739-DW) |  |  |  |  |  |  |  |  |  |  |  |  |  |  |  |  |  | 0.03 | 0.001 | 0.001 | FL=.0300±.0010 |  |  |  |  | 5 | NaN | NaN | 5°FA |  |  |  |  | 0.037 | NaN | NaN | X=.037 | 5 | NaN | NaN | 5°BA | 30 | NaN | NaN | 30°ISA | 0.035 | 0.001 | 0.001 | W=.0350±.0010
162 | 22001769 | SG-PA: 22001769T.etf | 3113116 | 117062 | Wed-Spec-Part1¦Wed-Spec-Part2 | Overlay & SG PA |  | 220-01769-TF-A | OSG7-6-G SPECIAL (220-01769-DW) |  |  |  |  |  |  |  |  |  |  |  |  |  |  |  |  |  | 0.014 | 0.0005 | 0.0005 | FL=.0140±.0005 |  |  |  |  | 5 | NaN | NaN | 5°FA |  |  |  |  | 0.045 | NaN | NaN | X=.0450 | 5 | NaN | NaN | 5°BA | 30 | NaN | NaN | 30°ISA | 0.012 | 0.0005 | 0.0005 | W=.0120±.0005
163 | 22001838 |  | 5220951 | 0 |  | Overlay & SG PA |  | 220-01838-TF-A | OSG7-8-G SPECIAL (220-01838-DW) |  |  |  |  |  |  |  |  |  |  |  |  |  |  |  |  |  | 0.022 | 0.0005 | 0.0005 | FL=.0220±.0005 |  |  |  |  | 5 | NaN | NaN | 5°FA |  |  |  |  | 0.0415 | NaN | NaN | X=.0415 | 5 | NaN | NaN | 5°BA | 30 | NaN | NaN | 30°ISA | 0.0155 | 0.0005 | 0.0005 | W=.0155±.0005
164 | 22001841 |  | 5220952 | 0 |  | Overlay & SG PA |  | 220-01841-TF-A | OSG7-15-G SPECIAL (220-01841-DW) |  |  |  |  |  |  |  |  |  |  |  |  |  |  |  |  |  | 0.0415 | 0.001 | 0.001 | FL=.0415±.0010 |  |  |  |  | 5 | NaN | NaN | 5°FA |  |  |  |  | 0.0313 | NaN | NaN | X=.0313 | 5 | NaN | NaN | 5°BA | 30 | NaN | NaN | 30°ISA | 0.0288 | 0.001 | 0.001 | W=.0288±.0010
165 | 22001895 | SG-PA: 14102014T.etf | 3113109 | 132102 | Wed-Spec-Part1¦Wed-Spec-Part2 | Overlay & SG PA | 1 | 220-01895-TF-A | OSG7-5-G SPECIAL (220-01895-DW) |  | 2.5 | 0.005 | 0.005 | SG-PA: 2.500±.005 | 0.1249 | 0.0001 | 0.0001 | SG-PA: .1249±.0001 | 0.11 | 0.0005 | 0.0005 | SG-PA: .1100±.0005 | 0.0142 | 0.0005 | 0.0005 | SG-PA: .0142±.0005 {Wed-T.FL} | 0.0142 | 0.0005 | 0.0005 | FL=.0142±.0005¦SG-PA: .0142±.0005 {Wed-T.FL} |  |  |  |  | 5 | NaN | NaN | 5°FA |  |  |  |  | 0.0449 | NaN | NaN | X=.0449 | 5 | NaN | NaN | 5°BA | 30 | NaN | NaN | 30°ISA | 0.011 | 0.0005 | 0.0005 | W=.0110±.0005¦SG-PA: .0110±.0005
166 | 22001896 | SG-PA: 22000467T.etf | 3113019 | 122507 | Wed-Spec-Part1¦Wed-Spec-Part2 | Overlay & SG PA | 1 | 220-01896-TF-B | OSG7-10-G SPECIAL (220-01896-DW) |  | 63.5 | 13 | 13 | SG-PA: 63.5±13 |  |  |  |  | 0.11 | 0.0005 | 0.0005 | SG-PA: 0.11±.0005 | 0.0283 | 0.001 | 0.001 | SG-PA: .0283±.0010 {Wed-T.FL} | 0.0283 | 0.001 | 0.001 | FL=.0283±.0010¦SG-PA: .0283±.0010 {Wed-T.FL} |  |  |  |  | 5 | NaN | NaN | 5°FA |  |  |  |  | 0.0379 | 0.001 | 0.001 | X=.0379±.0010 | 5 | NaN | NaN | 5°BA | 30 | NaN | NaN | 30°ISA | 0.0195 | 0.001 | 0.001 | W=.0195±.0010¦SG-PA: .0195±.0010
167 | 22001929 |  | 3128828 | 0 |  | Overlay & SG PA |  | 220-01929-TF-A | OSG7-15-G STANDARD |  |  |  |  |  |  |  |  |  |  |  |  |  |  |  |  |  | 0.0415 | 0.001 | 0.001 | FL=.0415±.0010 |  |  |  |  | 5 | NaN | NaN | 5°FA |  |  |  |  | 0.0313 | NaN | NaN | X=.0313 | 5 | NaN | NaN | 5°BA | 30 | NaN | NaN | 30°ISA | 0.0288 | 0.001 | 0.001 | W=.0288±.0010
168 | 22001942 | SG-PA: 22001942T.etf | 3113124 | 117801 | Wed-Spec-Part1¦Wed-Spec-Part2 | Overlay & SG PA |  | 220-01942-TF-A | OSG7-8-G SPECIAL (FL=017 220-01942-DW) |  |  |  |  |  |  |  |  |  |  |  |  |  |  |  |  |  | 0.017 | 0.0005 | 0.0005 | FL=.0170±.0005 |  |  |  |  | 5 | NaN | NaN | 5°FA |  |  |  |  | 0.0435 | NaN | NaN | X=.0435 | 5 | NaN | NaN | 5°BA | 30 | NaN | NaN | 30°ISA | 0.014 | 0.0005 | 0.0005 | W=.0140±.0005
169 | 22002032 |  | 3128829 | 0 |  | Overlay & SG PA |  | 220-02032-TF-A | OSG7-8-G SPECIAL |  |  |  |  |  |  |  |  |  |  |  |  |  |  |  |  |  | 0.022 | 0.0005 | 0.0005 | FL=.0220±.0005 |  |  |  |  | 5 | NaN | NaN | 5°FA |  |  |  |  | 0.0415 | NaN | NaN | X=.0415 | 5 | NaN | NaN | 5°BA | 30 | NaN | NaN | 30°ISA | 0.0155 | 0.0005 | 0.0005 | W=.0155±.0005
170 | 22002033 | SG-PA: 22001779T.etf¦SG-PA: 22001292T.etf | 3114437¦5225474 | 122353¦141960 | Wed-Spec-Part1¦Wed-Spec-Part2 | Overlay & SG PA | 1 | 220-02033-TF-B | OSG7-6-G SPECIAL (220-02033-DW) |  | 2.5¦63.5 | 0.005¦0.13 | 0.005¦0.13 | SG-PA: 63.5±.13¦SG-PA: 2.5±0.005 | 0.1249 | 0.0001 | 0.0001 | SG-PA: .1249±.0001¦SG-PA: .1249±0.0001 | 0.11 | 0.0005 | 0.0005 | SG-PA: .1100±.0005¦SG-PA: .110±.0005 | 0.0167 | 0.0005 | 0.0005 | SG-PA: .0167±.0005 {Wed-T.FL} | 0.0167 | 0.0005 | 0.0005 | FL=.0167±.0005¦SG-PA: .0167±.0005 {Wed-T.FL} |  |  |  |  | 5 | NaN | NaN | 5°FA |  |  |  |  | 0.0436 | NaN | NaN | X=.0436 | 5 | NaN | NaN | 5°BA | 30 | NaN | NaN | 30°ISA | 0.012 | 0.0005 | 0.0005 | W=.0120±.0005¦SG-PA: .0120±.0005
171 | 22002073 | SG-PA: 14102014T.etf | 3126388¦5219121 | 128134¦0 | Wed-Spec-Part1¦Wed-Spec-Part2 | Overlay & SG PA | 1 | 220-02073-TF-A | OSG7-12-G SPECIAL (220-02073) |  | 2.5 | 0.005 | 0.005 | SG-PA: 2.50±.005 | 0.1249 | 0.0001 | 0.0001 | SG-PA: .1249±.0001 | 0.11 | 0.0005 | 0.0005 | SG-PA: .1100±.0005 | 0.0344 | 0.001 | 0.001 | SG-PA: .0344±.0010 {Wed-T.FL} | 0.0344 | 0.001 | 0.001 | FL=.0344±.0010¦SG-PA: .0344±.0010 {Wed-T.FL} |  |  |  |  | 5 | NaN | NaN | 5°FA |  |  |  |  | 0.0348 | 0.001 | 0.001 | X=.0348±.001 | 5 | NaN | NaN | 5°BA | 30 | NaN | NaN | 30°ISA | 0.023 | 0.001 | 0.001 | W=.0230±.0010¦SG-PA: .0230±.0010
172 | 22002094 |  | 3117561 | 0 |  | Overlay & SG PA |  | 220-02094-TF-A | OSG7-10-G SPECIAL (FL=021 220-02094-DW) |  |  |  |  |  |  |  |  |  |  |  |  |  |  |  |  |  | 0.021 | 0.001 | 0.001 | FL=.0210±.0010 | 0.03 | 0 | 0.001 | 0°FA VFL=.030+.001/-0 | 0 | NaN | NaN | 0°FA VFL=.030+.001/-0 |  |  |  |  | 0.0415 | NaN | NaN | X=.0415 | 5 | NaN | NaN | 5°BA | 30 | NaN | NaN | 30°ISA | 0.019 | 0.001 | 0.001 | W=.0190±.0010
173 | 22002097 |  | 3117743¦3127399¦3129084 | 0 |  | Overlay & SG PA |  | 220-02097-TF-A | OSG7-5-G SPECIAL (FL=011 220-02097-DW) |  |  |  |  |  |  |  |  |  |  |  |  |  |  |  |  |  | 0.011 | 0.0005 | 0.0005 | FL=.0110±.0005 |  |  |  |  | 5 | NaN | NaN | 5°FA |  |  |  |  | 0.0465 | NaN | NaN | X=.0465 | 5 | NaN | NaN | 5°BA | 30 | NaN | NaN | 30°ISA | 0.0105 | 0.0005 | 0.0005 | W=.0105±.0005
174 | 22002146 | SG-PA: 22001292T.etf | 3120420¦5225473 | 123660¦141958 | Wed-Spec-Part1¦Wed-Spec-Part2 | Overlay & SG PA | 1 | 220-02146-TF-A | OSG7-12-G SPECIAL (FL=025 220-02146) |  | 2.5¦63.5 | 0.005¦13 | 0.005¦13 | SG-PA: 63.5±13¦SG-PA: 2.5±0.005 | 0.1249 | 0.0001 | 0.0001 | SG-PA: .1249±0.0001 | 0.11 | 0.0005 | 0.0005 | SG-PA: .110±.0005 | 0.025 | 0.001 | 0.001 | SG-PA: .0250±.0010 {Wed-T.FL} | 0.025 | 0.001 | 0.001 | FL=.0250±.0010¦SG-PA: .0250±.0010 {Wed-T.FL} |  |  |  |  | 5 | NaN | NaN | 5°FA |  |  |  |  | 0.0395 | 0.001 | 0.001 | X=.0395±.001 | 5 | NaN | NaN | 5°BA | 30 | NaN | NaN | 30°ISA | 0.023 | 0.001 | 0.001 | W=.0230±.0010¦SG-PA: .0230±.0010
175 | 22002147 | SG-PA: 14102014T.etf | 3125869¦5221752¦5225396 | 130205¦0¦141932 | Wed-Spec-Part1¦Wed-Spec-Part2 | Overlay & SG PA | 1 | 220-02147-TF-A | OSG7-10-G SPECIAL (FL=0244 220-02147) |  | 2.5 | 0¦0.005 | 0.005 | TL=2.50+.005/-0¦SG-PA: 2.50±.005 | 0.1249 | 0.0001 | 0.0001 | TD=.1249 TDF=.110¦SG-PA: .1249±.0001 | 0.11 | 0.0005 | 0.0005 | TD=.1249 TDF=.110¦SG-PA: .1100±.0005 | 0.0244 | 0.001 | 0.001 | SG-PA: .0244±.0010 {Wed-T.FL} | 0.0244¦0.0487 | 0.001 | 0.0006¦0.001 | FL=.0487+.0006/-.0010¦FL=.0244±.0010¦SG-PA: .0244±.0010 {Wed-T.FL} |  |  |  |  | 5 | NaN | NaN | 5°FA |  |  |  |  | 0.0276¦0.0398 | 0.001 | 0.001 | X=.0276±.0010¦X=.0398 | 5 | NaN | NaN | 5°BA | 30 | NaN | NaN | 30°ISA | 0.019¦0.038 | 0.001¦0.0012 | 0.0006¦0.001 | W=.0380+.0006/-.0012¦W=.0190±.0010¦SG-PA: .0190±.0010
176 | 22002178 |  | 5205987 | 0 |  | Overlay & SG PA |  | 220-02178-TF-A | OSG7-5-G SPECIAL (220-02178) |  |  |  |  |  |  |  |  |  |  |  |  |  |  |  |  |  | 0.0142 | 0.0005 | 0.0005 | FL=.0142±.0005 |  |  |  |  | 5 | NaN | NaN | 5°FA |  |  |  |  | 0.0452 | NaN | NaN | X=.0452 | 5 | NaN | NaN | 5°BA | 30 | NaN | NaN | 30°ISA | 0.01 | 0.0005 | 0.0005 | W=.0100±.0005
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
190 | 22000599 | SG-PA: 22000599T.etf | 3113122¦5224610 | 117022¦141622 | Wed-Spec-Part1¦Wed-Spec-Part2 | Overlay & SG PA |  | 220-00599-TF2-A¦220-00599-TF-C | OSG7-200 GEM SHANGHAI SPECIAL (TDF=110)¶DWG 220-00599-DW 200X¦OSG7-8-G SPECIAL (NFL) |  |  |  |  |  |  |  |  |  |  |  |  |  |  |  |  |  | 0.022 | 0.0005 | 0.0005 | FL=.0220±.0005 |  |  |  |  | 5 | NaN | NaN | 5°FA |  |  |  |  | 0.0415 | NaN | NaN | X=.0415 | 5 | NaN | NaN | 5°BA | 30 | NaN | NaN | 30°ISA | 0.0155 | 0.0005 | 0.0005 | W=.0155±.0005
191 | 22000609 | SG-PA: 22000609T.etf | 3113083 | 113318 | Wed-Spec-Part1¦Wed-Spec-Part2 | Overlay & SG PA | 1 | 220-00609-TF2-A¦220-00609-TF-B | OSG7-350 SPECIAL (FL=044 TDF=110 SPECIAL BR REL)¶DWG 220-00609-DW 100X¦OSG7-350 SPECIAL¶(FL=044 TDF=110 SPECIAL BR REL 220-00609-DW) |  | 63.5 | 13 | 13 | SG-PA: 63.5±13 |  |  |  |  | 0.11 | 0.0005 | 0.0005 | SG-PA: .110±.0005 |  |  |  |  | 0.044 | 0.0005 | 0.0005 | FL=.0440±.0005 |  |  |  |  | 5 | NaN | NaN | 5°FA |  |  |  |  | 0.03 | NaN | NaN | X=.0300 | 5 | NaN | NaN | 5°BA | 30 | NaN | NaN | 30°ISA | 0.03 | 0.0005 | 0.0005 | W=.0300±.0005¦SG-PA: .0300±.0005
192 | 22000648 | SG-PA: 22000648T.etf¦SG-PA: 22000621T.etf | 3113079¦3113080¦3119050 | 116916¦113556¦121984 | Wed-Spec-Part1¦Wed-Spec-Part2 | Overlay & SG PA | 1 | 220-00648-100X-TF-A¦220-00648-TF-B | OSG7-300 SPECIAL (TDF=110 FL=026) |  | 63.5 | 13 | 13 | SG-PA: 63.5±13 |  |  |  |  | 0.11 | 0.0005 | 0.0005 | SG-PA: .110±.0005 | 0.026 | 0.001 | 0.001 | SG-PA: .0260±.0010 {Wed-T.FL} | 0.026 | 0.001 | 0.001 | FL=.0260±.0010¦SG-PA: .0260±.0010 {Wed-T.FL} |  |  |  |  | 5 | NaN | NaN | 5°FA |  |  |  |  | 0.039 | NaN | NaN | X=.0390 | 5 | NaN | NaN | 5°BA | 30 | NaN | NaN | 30°ISA | 0.023 | 0.001 | 0.001 | W=.0230±.0010¦SG-PA: .0230±.0010
193 | 22001081 | SG-PA: 22001081T.etf | 3113063¦5215376 | 117013¦138744 | Wed-Spec-Part1¦Wed-Spec-Part2 | Overlay & SG PA | 1 | 220-01081-GPTF-A¦220-01081-TF-D | OSG7-200-G GRANDPA MASTER¦OSG7-200 SPECIAL (TDF=110 220-01081-DW) |  | 63.5¦64 | 0.13 | 0.13 | SG-PA: 63.5±.13¦SG-PA: 64±.13 | 0.1249 | 0.0001 | 0.0001 | SG-PA: .1249±.0001 | 0.11 | 0.0005 | 0.0005 | SG-PA: .110±+.0005¦SG-PA: .110±.0005 | 0.0195 | 0.001 | 0.001 | SG-PA: .0195±+.0010 {Wed-T.FL}¦SG-PA: .0195±.0010 {Wed-T.FL} | 0.0195¦0.0208 | 0.0003¦0.001 | 0.0003¦0.001 | FL=.0208±.0003¦FL=.0195±.0010¦SG-PA: .0195±+.0010 {Wed-T.FL}¦SG-PA: .0195±.0010 {Wed-T.FL} |  |  |  |  | 5¦6.5 | NaN | NaN | 6.5°FA¦5°FA |  |  |  |  | 0.0423 | NaN | NaN | X=.0423 | 5¦6.5 | NaN | NaN | 6.5°BA¦5°BA | 30 | NaN | NaN | 30°ISA | 0.0146¦0.036 | 0.0003¦0.001 | 0.0003¦0.001 | W=.0360±.0003¦W=.0146±.0010¦SG-PA: .0146±+.0010¦SG-PA: .0146±.0010
194 | 22500002 | SG-PA: 14102014T.etf | 3113130¦5204388 | 129818¦0 | Wed-Spec-Part1¦Wed-Spec-Part2 | Overlay & SG PA | 1 | 225-00002-OL-B¦225-00002-TF-A¦225-00002-TF-H | OSG7-125-GCG SPECIAL (B=0043 FL=0142 TDF=110)¶DWG HWT9142 REV E 100X/250X¦OSG7-125-GCG SPECIAL¶(B=0043 FL=0142 TDF=110)¶DWG HWT9142 REV F¦OSG7-125-GCG SPECIAL¶(B=0043 FL=0142 TDF=110 DWG HWT9142) |  | 2.5 | 0.005 | 0.005 | SG-PA: 2.50±.005 | 0.1249 | 0.0001 | 0.0001 | SG-PA: .1249±.0001 | 0.11 | 0.0005 | 0.0005 | SG-PA: .1100±.0005 | 0.0142 | 0.0001 | 0.0006 | SG-PA: .0142+.0006/-.0001 {Wed-T.FL} | 0.0136¦0.0142 | 0.0001¦0.0005¦REF | 0.0005¦0.0006¦REF | FINISHED FL=.0136 (REF)¦GRINDING FL=.0142±.0005¦FL=.0142+.0006/-.0001¦SG-PA: .0142+.0006/-.0001 {Wed-T.FL} |  |  |  |  | 5 | NaN | NaN | 5°FA |  |  |  |  | 0.0454 | NaN | NaN | X=.0454 | 5 | NaN | NaN | 5°BA | 30 | NaN | NaN | 30°ISA | 0.011 | 0.0005 | 0.0005 | W=.0110±.0005¦SG-PA: .0110±.0005

Sheet: Article_Sorted
 | drawing# | overlay_PA | article# | partspec# | partspec_templates | PS_PA | drawing_title | wedge_title | units | TL_NOM | TL_LTOL | TL_UTOL | TL_COMMENTS | TD_NOM | TD_LTOL | TD_UTOL | TD_COMMENTS | TDF_NOM | TDF_LTOL | TDF_UTOL | TDF_COMMENTS | T_NOM | T_LTOL | T_UTOL | T_COMMENTS | FL_NOM | FL_LTOL | FL_UTOL | FL_COMMENTS | VFL_NOM | VFL_LTOL | VFL_UTOL | VFL_COMMENTS | FA_NOM | FA_LTOL | FA_UTOL | FA_COMMENTS | FX_NOM | FX_LTOL | FX_UTOL | FX_COMMENTS | X_NOM | X_LTOL | X_UTOL | X_COMMENTS | BA_NOM | BA_LTOL | BA_UTOL | BA_COMMENTS | ISA_NOM | ISA_LTOL | ISA_UTOL | ISA_COMMENTS | W_NOM | W_LTOL | W_UTOL | W_COMMENTS | VW_NOM | VW_LTOL
0 | 22000535 | SG-PA: 22000535T.etf | 3113009 | 117009 | Wed-Spec-Part1¦Wed-Spec-Part2 | 1 | 220-00535-TF-C | OSG7-100 SPECIAL FL=010 (TDF=110 220-00535-DW) |  | 63.5 | 0.13 | 0.13 | SG-PA: 63.5±0.13 |  |  |  |  | 0.11 | 0.0005 | 0.0005 | SG-PA: .110±.0005 | 0.01 | 0.0005 | 0.0005 | SG-PA: .0100±.0005 {Wed-T.FL} | 0.01 | 0.0005 | 0.0005 | FL=.0100±.0005¦SG-PA: .0100±.0005 {Wed-T.FL} |  |  |  |  | 5 | NaN | NaN | 5°FA |  |  |  |  | 0.0475 | NaN | NaN | X=.0475 | 5 | NaN | NaN | 5°BA | 30 | NaN | NaN | 30°ISA | 0.009 | 0.0005 | 0.0005 | W=.0090±.0005¦SG-PA: .0090±.0005
1 | 22000135 |  | 3113014 | 117025 | Wed-Spec-Part1¦Wed-Spec-Part2 |  | 220-00135-TF-E | OSG7-10-G 220-00135 |  |  |  |  |  |  |  |  |  |  |  |  |  |  |  |  |  | 0.0283 | 0.001 | 0.001 | FL=.0283±.0010 |  |  |  |  | 5 | NaN | NaN | 5°FA |  |  |  |  | 0.0379 | NaN | NaN | X=.0379 | 5 | NaN | NaN | 5°BA | 30 | NaN | NaN | 30°ISA | 0.02 | 0.001 | 0.001 | W=.0200±.0010
2 | 22001102 | SG-PA: 22001102T.etf | 3113015 | 117020 | Wed-Spec-Part1¦Wed-Spec-Part2 |  | 220-01102-TF-D | OSG7-10-G SPECIAL (NFL) 220-01102-DW |  |  |  |  |  |  |  |  |  |  |  |  |  |  |  |  |  | 0.0283 | 0.0005 | 0.0005 | FL=.0283±.0005 |  |  |  |  | 5 | NaN | NaN | 5°FA |  |  |  |  | 0.0385 | NaN | NaN | X=.0385 | 5 | NaN | NaN | 5°BA | 30 | NaN | NaN | 30°ISA | 0.019 | 0.0005 | 0.0005 | W=.0190±.0005
3 | 22001896 | SG-PA: 22000467T.etf | 3113019 | 122507 | Wed-Spec-Part1¦Wed-Spec-Part2 | 1 | 220-01896-TF-B | OSG7-10-G SPECIAL (220-01896-DW) |  | 63.5 | 13 | 13 | SG-PA: 63.5±13 |  |  |  |  | 0.11 | 0.0005 | 0.0005 | SG-PA: 0.11±.0005 | 0.0283 | 0.001 | 0.001 | SG-PA: .0283±.0010 {Wed-T.FL} | 0.0283 | 0.001 | 0.001 | FL=.0283±.0010¦SG-PA: .0283±.0010 {Wed-T.FL} |  |  |  |  | 5 | NaN | NaN | 5°FA |  |  |  |  | 0.0379 | 0.001 | 0.001 | X=.0379±.0010 | 5 | NaN | NaN | 5°BA | 30 | NaN | NaN | 30°ISA | 0.0195 | 0.001 | 0.001 | W=.0195±.0010¦SG-PA: .0195±.0010
4 | 22000395 | SG-PA: 22000395T.etf | 3113026 | 116904 | Wed-Spec-Part1¦Wed-Spec-Part2 |  | 220-00395R-TF-B¦220-00395-TF-G | OSG7-5 SPECIAL (220-00395R-DW)¦OSG7-125 SPECIAL (TDF=110 220-00395-DW) | INCH [MM] | 63.5 | 13 | 13 | SG-PA: 63.5±13 |  |  |  |  | 0.11 | 0.0005 | 0.0005 | SG-PA: .110±.0005 |  |  |  |  | 0.0145¦0.368 | 0.0005¦0.013 | 0.0005¦0.013 | FL=.0145±.0005 [0.368±0.013]¦FL=.0145±.0005 |  |  |  |  | 5 | NaN | NaN | 5°FA |  |  |  |  | 0.0442¦1.123 | NaN | NaN | X=.0442 [1.123]¦X=.0442 | 5 | NaN | NaN | 5°BA | 30 | NaN | NaN | 30°ISA | 0.0105¦0.267 | 0.0005¦0.013 | 0.0005¦0.013 | W=.0105±.0005 [0.267±0.013]¦W=.0105±.0005¦SG-PA: .0105±.0005
5 | 22000621 | SG-PA: 22000621T.etf | 3113027 | 116911 | Wed-Spec-Part1¦Wed-Spec-Part2 | 1 | 220-00621-TF-E | OSG7-125 SPECIAL¶(FL=016 TDF=110 SPECIAL BR REL 220-00621-DW) |  | 63.5 | 0.13 | 0.13 | SG-PA: 63.5±0.13 |  |  |  |  | 0.11 | 0.0005 | 0.0005 | SG-PA: .110±.0005 |  |  |  |  | 0.016 | 0.0005 | 0.0005 | FL=.0160±.0005 |  |  |  |  | 5 | NaN | NaN | 5°FA |  |  |  |  | 0.044 | NaN | NaN | X=.044 | 5 | NaN | NaN | 5°BA | 30 | NaN | NaN | 30°ISA | 0.0108 | 0.0005 | 0.0005 | W=.0108±.0005¦SG-PA: .0108±.0005
6 | 22000395 | SG-PA: 22100395RT.etf | 3113028 | 116909 | Wed-Spec-Part1¦Wed-Spec-Part2 |  | 220-00395R-TF-B¦220-00395-TF-G | OSG7-5 SPECIAL (220-00395R-DW)¦OSG7-125 SPECIAL (TDF=110 220-00395-DW) | INCH [MM] | 63.5 | 13 | 13 | SG-PA: 63.5±13 |  |  |  |  | 0.11 | 0.0005 | 0.0005 | SG-PA: .110±.0005 |  |  |  |  | 0.0145¦0.368 | 0.0005¦0.013 | 0.0005¦0.013 | FL=.0145±.0005 [0.368±0.013]¦FL=.0145±.0005 |  |  |  |  | 5 | NaN | NaN | 5°FA |  |  |  |  | 0.0442¦1.123 | NaN | NaN | X=.0442 [1.123]¦X=.0442 | 5 | NaN | NaN | 5°BA | 30 | NaN | NaN | 30°ISA | 0.0105¦0.0115¦0.267 | 0.0005¦0.013 | 0.0005¦0.013 | W=.0105±.0005 [0.267±0.013]¦W=.0105±.0005¦SG-PA: .0115±.0005
7 | 22000621 | SG-PA: 22000621T.etf | 3113029 | 117008 | Wed-Spec-Part1¦Wed-Spec-Part2 |  | 220-00621-TF-E | OSG7-125 SPECIAL¶(FL=016 TDF=110 SPECIAL BR REL 220-00621-DW) |  |  |  |  |  |  |  |  |  |  |  |  |  |  |  |  |  | 0.016 | 0.0005 | 0.0005 | FL=.0160±.0005 |  |  |  |  | 5 | NaN | NaN | 5°FA |  |  |  |  | 0.044 | NaN | NaN | X=.044 | 5 | NaN | NaN | 5°BA | 30 | NaN | NaN | 30°ISA | 0.0108 | 0.0005 | 0.0005 | W=.0108±.0005
8 | 22001246 | SG-PA: 14102014T.etf | 3113034 | 140737 | Wed-Spec-Part1¦Wed-Spec-Part2 | 1 | 220-01246-TF-C | OSG7-12-G SPECIAL 220-01246-DW |  | 2.5 | 0.005 | 0.005 | SG-PA: 2.50±.005 | 0.1249 | 0.0001 | 0.0001 | SG-PA: .1249±.0001 | 0.11 | 0.0005 | 0.0005 | SG-PA: .1100±.0005 | 0.0342 | 0.0015 | 0 | SG-PA: .0342+0/-.0015 {Wed-T.FL} | 0.0342¦0.0344 | 0.0015 | 0 | FL=.0342+0/-.0015¦FL DIMENSION TO BE CLOSE¶TO OE 127153-12 (FL=.0344)¦SG-PA: .0342+0/-.0015 {Wed-T.FL} |  |  |  |  | 5 | NaN | NaN | 5°FA |  |  |  |  | 0.036 | NaN | NaN | X=.036 | 5 | NaN | NaN | 5°BA | 30 | NaN | NaN | 30°ISA | 0.023 | 0.001 | 0.001 | W=.0230±.0010¦SG-PA: .0230±.0010
9 | 22001292 | SG-PA: 22001292T.etf | 3113035 | 117041 | Wed-Spec-Part1¦Wed-Spec-Part2 |  | 220-01292-TF-D | OSG7-12-G 220-01292-DW |  |  |  |  |  |  |  |  |  |  |  |  |  |  |  |  |  | 0.0294 | 0.001 | 0.001 | FL=.0294±.0010 |  |  |  |  | 5 | NaN | NaN | 5°FA |  |  |  |  | 0.0373 | NaN | NaN | X=.0373 | 5 | NaN | NaN | 5°BA | 30 | NaN | NaN | 30°ISA | 0.023 | 0.001 | 0.001 | W=.0230±.0010
10 | 22101897 |  | 3113043 | 117795 | Wed-Spec-Part1¦Wed-Spec-Part2 | 1 | 221-01897-TF-A | OSG7-14-G SPECIAL (221-01897-DW) |  | 2.5 | 0.005 | 0.005 | SG-PA: 2.5±.005 | 0.1249 | 0.0001 | 0.0001 | SG-PA: .1249±.0001 | 0.11 | 0.0005 | 0.0005 | SG-PA: .1100±.0005 | 0.0396 | 0.001 | 0.001 | SG-PA: .0396±.001 {Wed-T.FL} | 0.0396 | 0.001 | 0.001 | FL=.0396±.0010¦SG-PA: .0396±.001 {Wed-T.FL} |  |  |  |  | 5 | NaN | NaN | 5°FA |  |  |  |  | 0.0322 | NaN | NaN | X=.0322 | 5 | NaN | NaN | 5°BA | 30 | NaN | NaN | 30°ISA | 0.0264 | 0.001 | 0.001 | W=.0264±.0010¦SG-PA: .0264±.001
11 | 22000615 | SG-PA: 14102014T.etf | 3113044 | 129003 | Wed-Spec-Part1¦Wed-Spec-Part2 | 1 | 220-00615-TF-C | OSG7-150 SPECIAL (FL=0165 TDF=110¶SPECIAL BR REL) DWG 220-00615-DW |  | 2.5 | 0.005 | 0.005 | SG-PA: 2.50±.005 | 0.1249 | 0.0001 | 0.0001 | SG-PA: .1249±.0001 | 0.11 | 0.0005 | 0.0005 | SG-PA: .1100±.0005 | 0.0165 | 0.0005 | 0.0005 | SG-PA: .0165±.0005 {Wed-T.FL} | 0.0165 | 0.0005 | 0.0005 | FL=.0165±.0005¦SG-PA: .0165±.0005 {Wed-T.FL} |  |  |  |  | 5 | NaN | NaN | 5°FA |  |  |  |  | 0.0437 | NaN | NaN | X=.0437 | 5 | NaN | NaN | 5°BA | 30 | NaN | NaN | 30°ISA | 0.012 | 0.0005 | 0.0005 | W=.0120±.0005¦SG-PA: .0120±.0005
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
