yassinekarroukuxvc/WAD.Runner/Resources/Templates/1001/1001A_part_rev1.SLDPRT

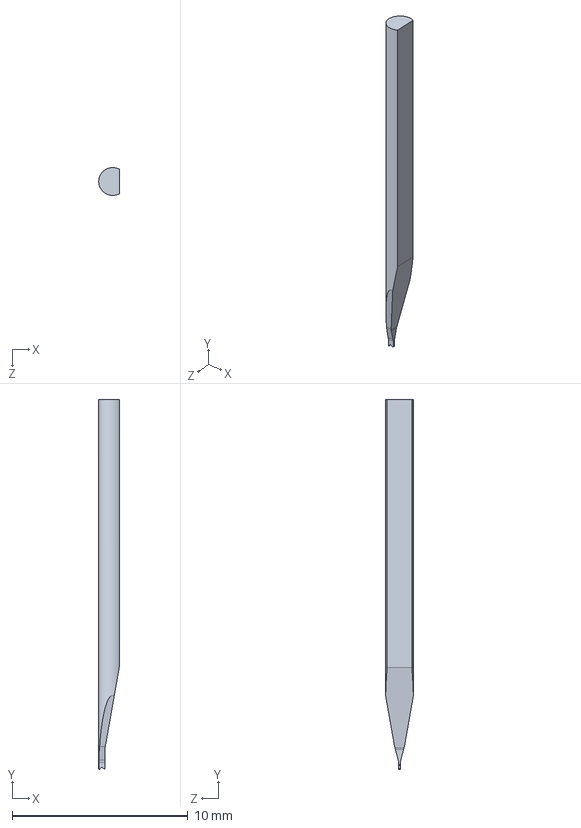
[picture p142: CAD file, 2026-10-05]
Resources/Templates/1001/1001A_part_rev1.SLDPRT
1.17 x 21.0 x 1.58 mm
