yassinekarroukuxvc/WAD.Runner/Resources/Templates/4516/4516_part_rev2.SLDPRT

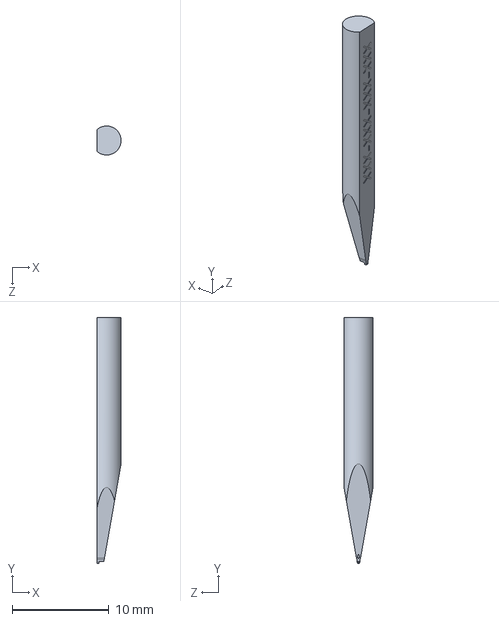
[picture p143: CAD file, 2026-10-11]
Resources/Templates/4516/4516_part_rev2.SLDPRT
2.50 x 25.4 x 3.00 mm
