yassinekarroukuxvc/WAD.Runner/Resources/Templates/45CK/45CK_rev1/CK45_part_rev1.SLDPRT

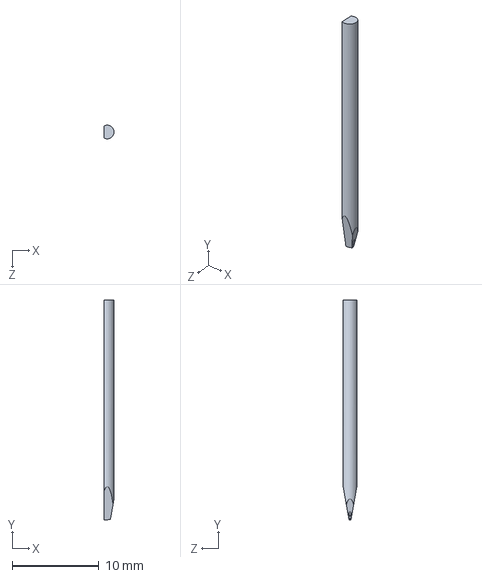
[picture p144: CAD file, 2026-08-26]
Resources/Templates/45CK/45CK_rev1/CK45_part_rev1.SLDPRT
1.17 x 25.4 x 1.58 mm
