yassinekarroukuxvc/WAD.Runner/Resources/Templates/ABT/ABT_rev1/ABT_part_rev1.SLDPRT

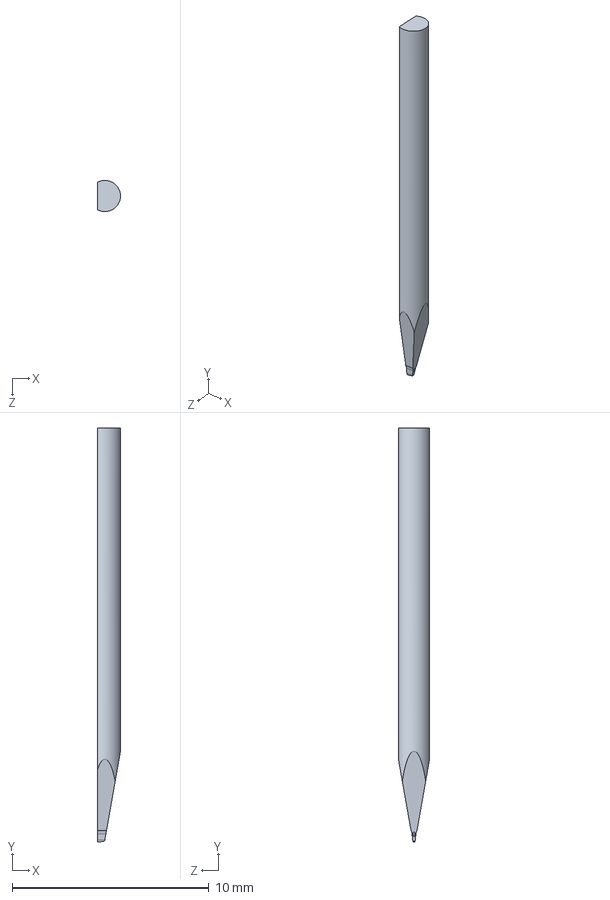
[picture p145: CAD file, 2026-10-11]
Resources/Templates/ABT/ABT_rev1/ABT_part_rev1.SLDPRT
1.17 x 21.0 x 1.58 mm
