yassinekarroukuxvc/WAD.Runner/Resources/Templates/CKVD/CKVD_rev2/ckvd_part_rev2.SLDPRT

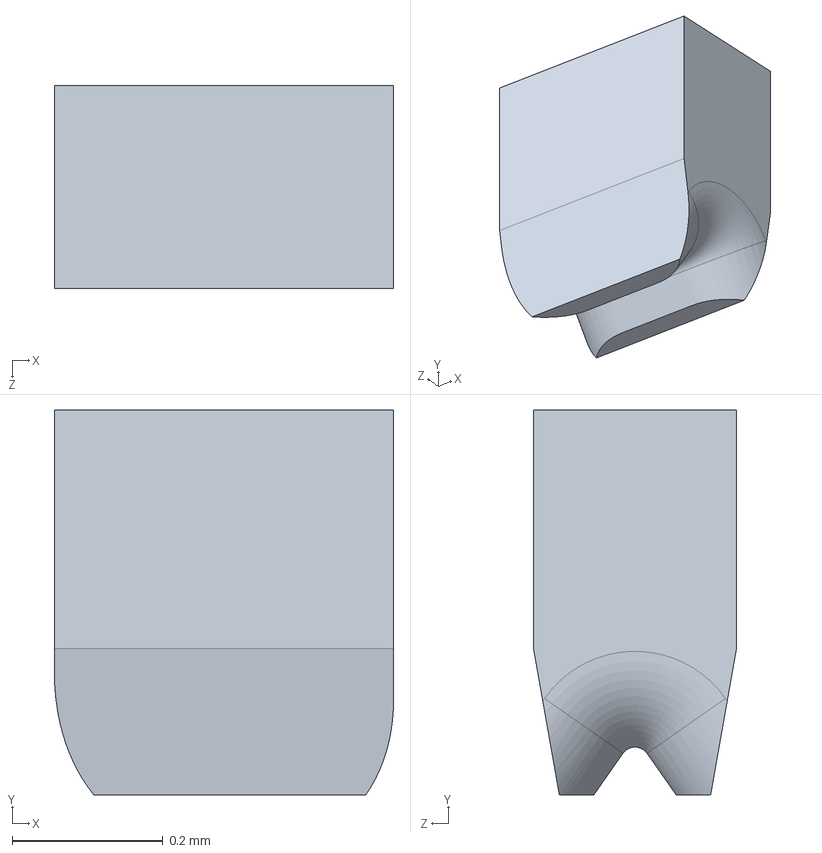
[picture p146: CAD file, 2026-10-05]
Resources/Templates/CKVD/CKVD_rev2/ckvd_part_rev2.SLDPRT
0.45 x 0.51 x 0.269 mm
