yassinekarroukuxvc/WAD.Runner/Resources/Templates/CKVD/Working Version/CKVD_2023.SLDPRT

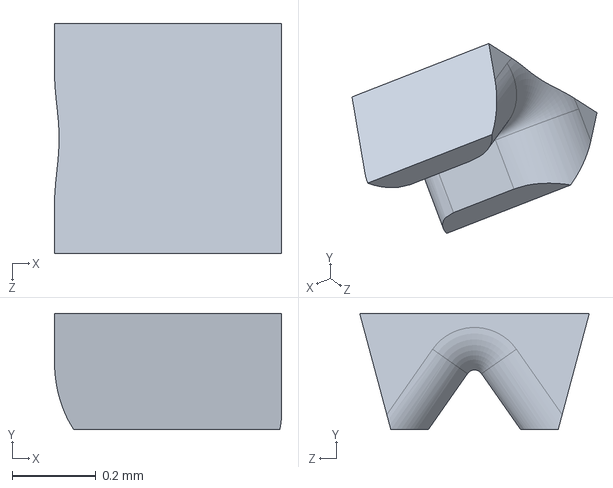
[picture p147: CAD file, 2026-03-04]
Resources/Templates/CKVD/Working Version/CKVD_2023.SLDPRT
0.541 x 0.278 x 0.548 mm
