yassinekarroukuxvc/WAD.Runner/Resources/Templates/COB/COB template 02-14-2026/COB.SLDPRT

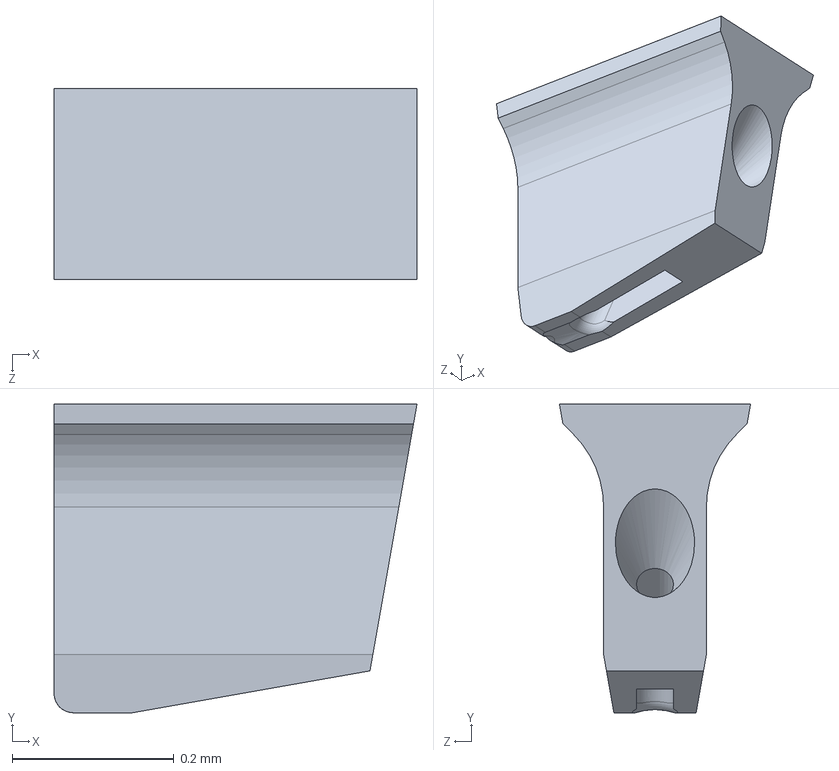
[picture p148: CAD file, 2026-04-16]
Resources/Templates/COB/COB template 02-14-2026/COB.SLDPRT
0.448 x 0.381 x 0.236 mm
