yassinekarroukuxvc/WAD.Runner/Resources/Templates/COB/COB_part_rev1.SLDPRT

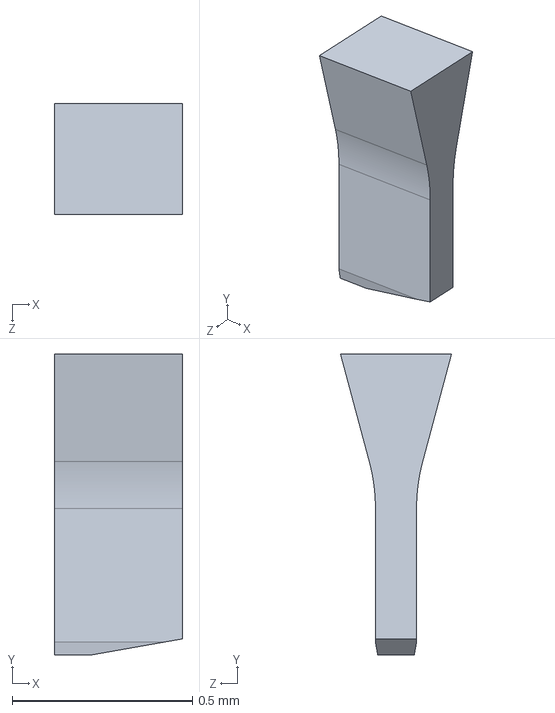
[picture p149: CAD file, 2026-08-28]
Resources/Templates/COB/COB_part_rev1.SLDPRT
0.356 x 0.836 x 0.308 mm
