yassinekarroukuxvc/WAD.Runner/Resources/Templates/COB/Working Version/COB.SLDPRT

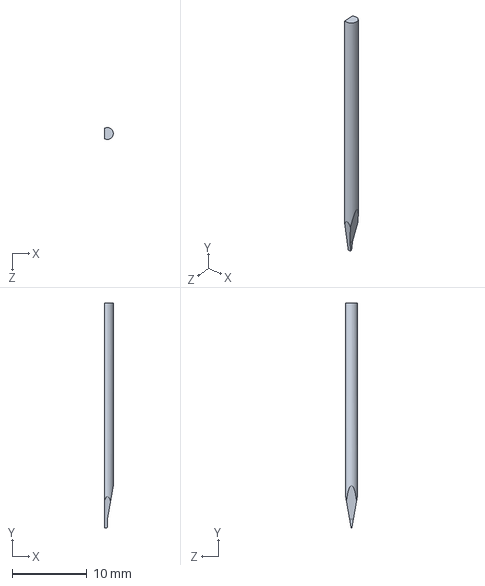
[picture p150: CAD file, 2026-07-19]
Resources/Templates/COB/Working Version/COB.SLDPRT
1.17 x 30.0 x 1.58 mm
