yassinekarroukuxvc/WAD.Runner/Resources/Templates/FP/FP_rev2/FP_part_rev1.SLDPRT

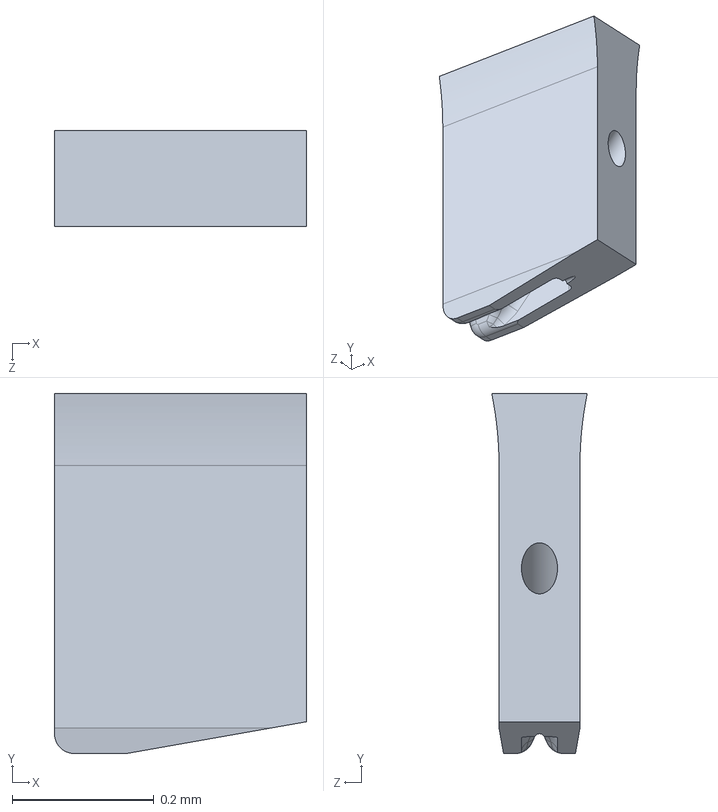
[picture p151: CAD file, 2026-08-28]
Resources/Templates/FP/FP_rev2/FP_part_rev1.SLDPRT
0.356 x 0.508 x 0.135 mm
