yassinekarroukuxvc/WAD.Runner/Resources/Templates/FP/V1/COB.SLDPRT

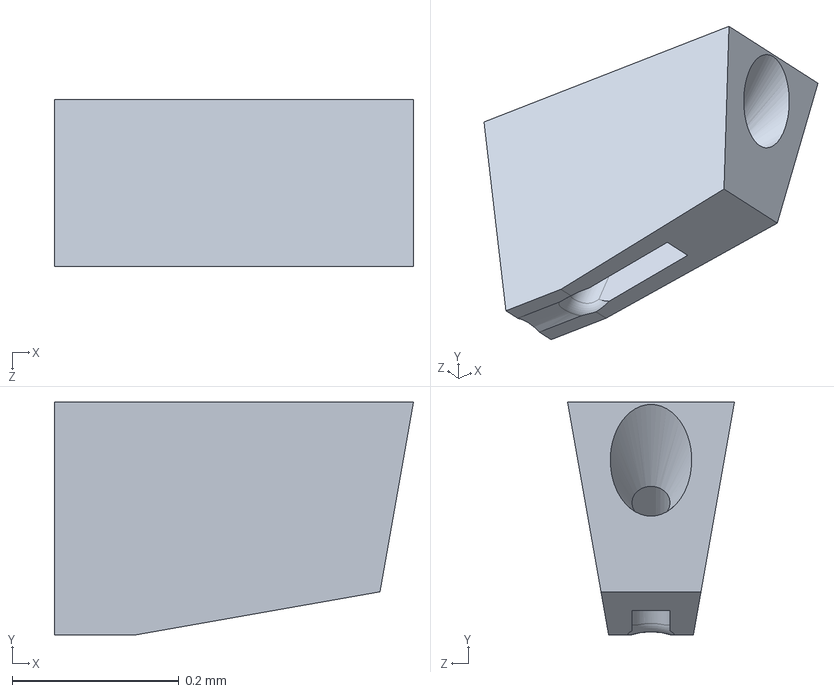
[picture p152: CAD file, 2026-04-26]
Resources/Templates/FP/V1/COB.SLDPRT
0.43 x 0.279 x 0.2 mm
