yassinekarroukuxvc/WAD.Runner/Resources/Templates/FP/Working Version/COB.SLDPRT

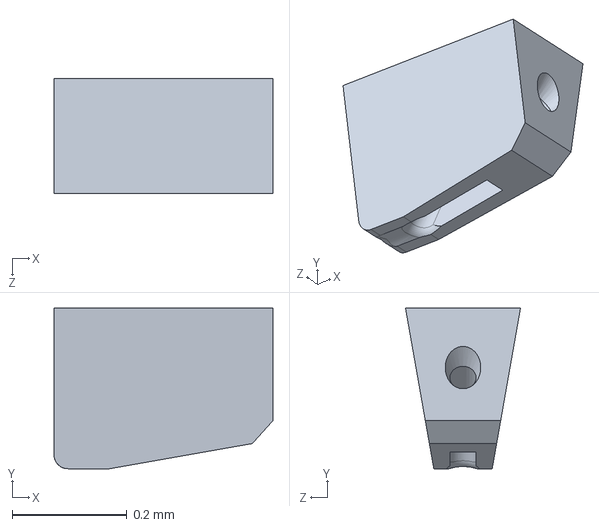
[picture p153: CAD file, 2026-07-19]
Resources/Templates/FP/Working Version/COB.SLDPRT
0.381 x 0.279 x 0.2 mm
