yassinekarroukuxvc/WAD.Runner/Resources/Templates/OSG7/OSG7.SLDPRT

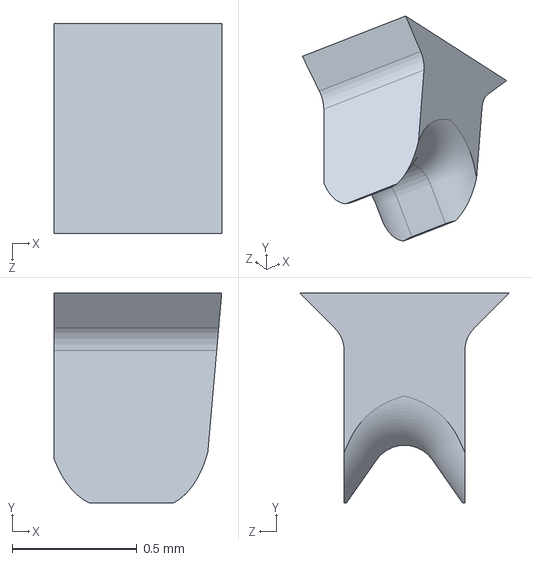
[picture p154: CAD file, 2026-07-19]
Resources/Templates/OSG7/OSG7.SLDPRT
0.67 x 0.84 x 0.839 mm
