yassinekarroukuxvc/WAD.Runner/Resources/Templates/OSG7/Working Version/OSG7.SLDPRT

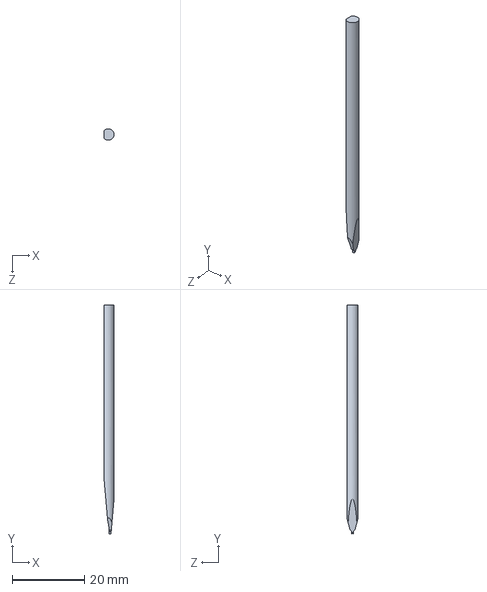
[picture p155: CAD file, 2026-07-19]
Resources/Templates/OSG7/Working Version/OSG7.SLDPRT
2.79 x 63.5 x 3.17 mm
