yassinekarroukuxvc/WAD.Runner/Resources/Templates/UT-US/UTUS_rev2/UTUS_part_rev1.SLDPRT

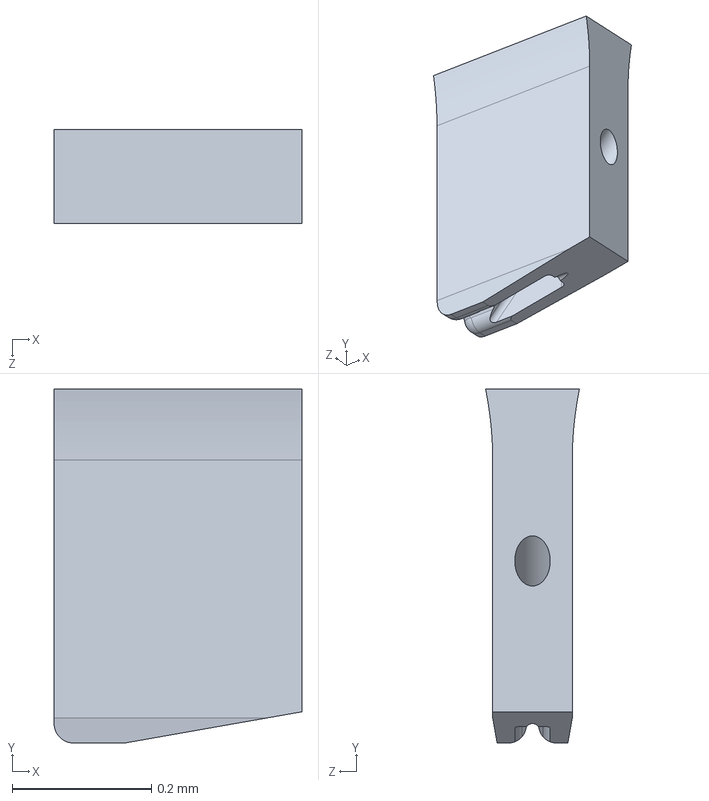
[picture p156: CAD file, 2026-08-30]
Resources/Templates/UT-US/UTUS_rev2/UTUS_part_rev1.SLDPRT
0.356 x 0.508 x 0.135 mm
