yassinekarroukuxvc/WAD.Runner/Resources/Templates/VM/VM_part_rev1.SLDPRT

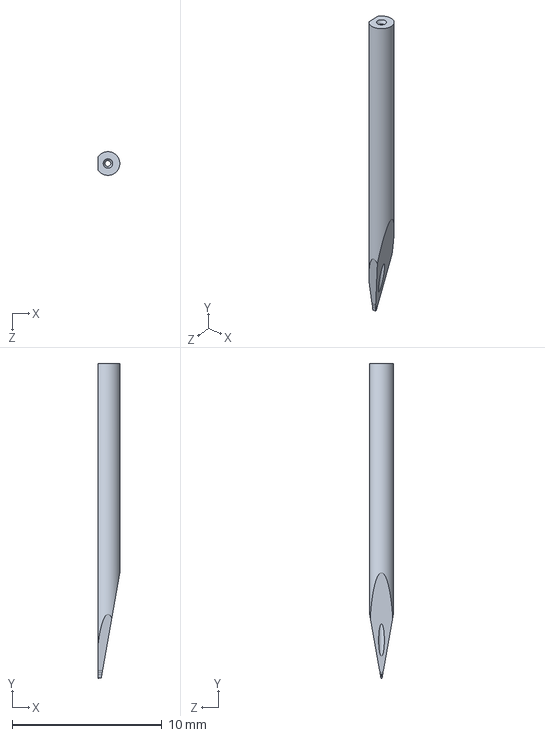
[picture p157: CAD file, 2026-10-05]
Resources/Templates/VM/VM_part_rev1.SLDPRT
1.45 x 21.0 x 1.58 mm
