yassinekarroukuxvc/WAD.Runner/Resources/Templates/UT-US/V1/wedge-auto-draw-UT-US-3d-model_sw_version_2023.SLDPRT

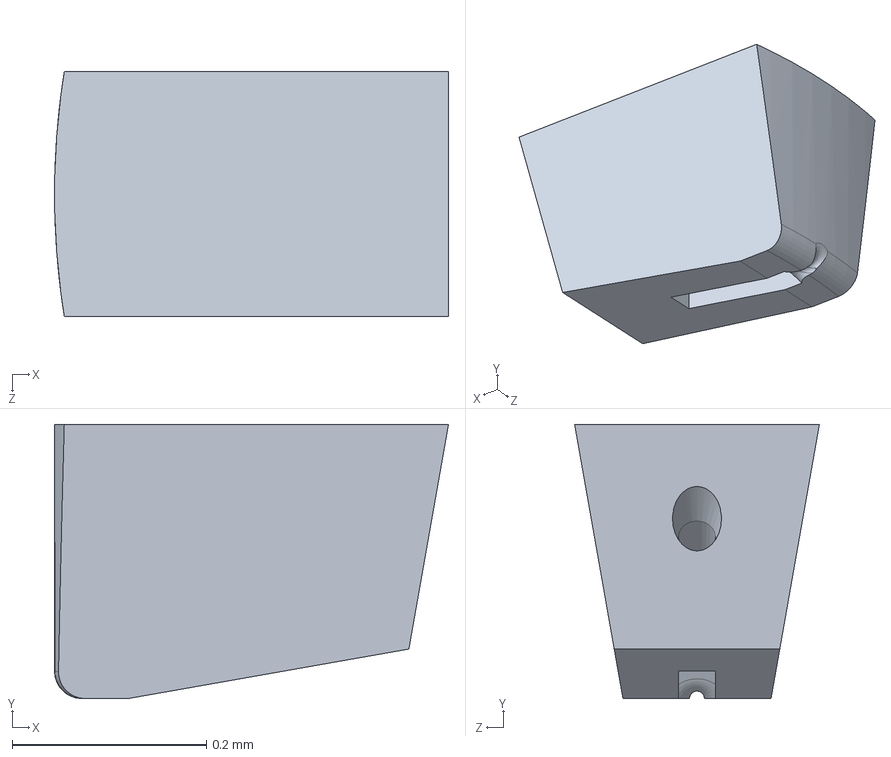
[picture p158: CAD file, 2026-04-05]
Resources/Templates/UT-US/V1/wedge-auto-draw-UT-US-3d-model_sw_version_2023.SLDPRT
0.405 x 0.282 x 0.252 mm
