yassinekarroukuxvc/WAD.Runner/(list of files, cad)

Other CAD files:
Resources/Templates/AB16/AB16_rev1/AB16_part_rev1.SLDPRT
Resources/Templates/COB/COB template 02-14-2026/V4/wedge-auto-draw-COB-3d-model_sw_version_2023.SLDPRT
Resources/Templates/COB/COB_rev2/COB_part_rev1.SLDPRT
Resources/Templates/M/M_part_rev1.SLDPRT
Resources/Templates/UT-US/Working Version/COB.SLDPRT
Resources/Templates/COB/COB template 02-14-2026/wedge-auto-draw-COB-3d-model_sw_version_2023.SLDPRT
Resources/Templates/FP/V1/wedge-auto-draw-FP-3d-model_sw_version_2023.SLDPRT
Resources/Templates/OSG7/V1/wedge_auto_draw_OSG7_3d.SLDPRT
Resources/Templates/OSG7/wedge_auto_draw_OSG7_3d.SLDPRT
Resources/Out/FG/Overlay/3112260/3112260TF.SLDDRW
Resources/Out/FG/Overlay/3112260/3112260TF.SLDPRT
Resources/Out/FG/Overlay/3118724/3118724TF.SLDDRW
Resources/Out/FG/Overlay/3118724/3118724TF.SLDPRT
Resources/Out/FG/Production/3112260/3112260P.SLDDRW
Resources/Out/FG/Production/3112260/3112260P.SLDPRT
Resources/Out/FG/Production/3118724/3118724P.SLDDRW
Resources/Out/FG/Production/3118724/3118724P.SLDPRT
Resources/Out/PGB/Overlay/3113909/3113909TF.SLDDRW
Resources/Out/PGB/Overlay/3113909/3113909TF.SLDPRT
Resources/Out/PGB/Overlay/3114012/3114012TF.SLDDRW
Resources/Out/PGB/Overlay/3114012/3114012TF.SLDPRT
Resources/Out/PGB/Overlay/3114051/3114051TF.SLDDRW
Resources/Out/PGB/Overlay/3114051/3114051TF.SLDPRT
Resources/Out/PGB/Overlay/3118710/3118710TF.SLDDRW
Resources/Out/PGB/Overlay/3118710/3118710TF.SLDPRT
Resources/Out/PGB/Overlay/5201065/5201065TF.SLDPRT
Resources/Out/PGB/Production/3112256/3112256D.SLDDRW
Resources/Out/PGB/Production/3112256/3112256D.SLDPRT
Resources/Out/PGB/Production/3113909/3113909D.SLDDRW
Resources/Out/PGB/Production/3113909/3113909D.SLDPRT
Resources/Out/PGB/Production/3118724/3118724D.SLDDRW
Resources/Out/PGB/Production/3118724/3118724D.SLDPRT
Resources/Out/PGB/Production/5201065/5201065D.SLDPRT
Resources/Out/PGB/Production/5203313/5203313D.SLDDRW
Resources/Out/PGB/Production/5203313/5203313D.SLDPRT
Resources/Out/PGB/Production/5222389/5222389D.SLDDRW
Resources/Out/PGB/Production/5222389/5222389D.SLDPRT
Resources/Out/PGB/Production/5222704/5222704D.SLDDRW
Resources/Out/PGB/Production/5222704/5222704D.SLDPRT
Resources/Templates/1001/1001A_drawing_rev1.SLDPRT.SLDDRW
Resources/Templates/1001/1001A_overlay_rev1.SLDDRW
Resources/Templates/4516/4516_drawing_rev2.SLDPRT.SLDDRW
Resources/Templates/4516/4516_overlay_rev2.SLDDRW
Resources/Templates/4516/backup/4516_drawing_rev2.SLDPRT.SLDDRW
Resources/Templates/4516/backup/4516_overlay_rev2.SLDDRW
Resources/Templates/4516/backup/4516_part_rev2.SLDPRT
Resources/Templates/45CK/45CK_rev1/CK45_drawing_rev2.SLDPRT.SLDDRW
Resources/Templates/45CK/45CK_rev1/CK45_overlay_rev2.SLDDRW
Resources/Templates/AB16/AB16_rev1/AB16_drawing_rev2.SLDPRT.SLDDRW
Resources/Templates/AB16/AB16_rev1/AB16_overlay_rev2.SLDDRW
Resources/Templates/ABT/ABT_rev1/ABT_drawing_rev1.SLDPRT.SLDDRW
Resources/Templates/ABT/ABT_rev1/ABT_overlay_rev1.SLDDRW
Resources/Templates/ABT/ABT_rev1_old/ABT_part_rev1.SLDPRT
Resources/Templates/CKVD/CKVD_rev2/ckvd_drawing_rev2.SLDPRT.SLDDRW
Resources/Templates/CKVD/CKVD_rev2/ckvd_overlay_rev2.SLDDRW
Resources/Templates/CKVD/Working Version/CKVD_2023.SLDDRW
Resources/Templates/CKVD/Working Version/OVERLAY_TEMPLATE.SLDDRW
Resources/Templates/COB/COB template 02-14-2026/COB_Overlay.SLDDRW
Resources/Templates/COB/COB template 02-14-2026/V1/wedge-auto-draw-COB-3d-model_sw_version_2023.SLDPRT
Resources/Templates/COB/COB template 02-14-2026/V2/wedge-auto-draw-COB-2d-drawing.SLDDRW
Resources/Templates/COB/COB template 02-14-2026/V2/wedge-auto-draw-COB-3d-model_sw_version_2023.SLDPRT
Resources/Templates/COB/COB template 02-14-2026/V3/wedge-auto-draw-COB-2d-drawing.SLDDRW
Resources/Templates/COB/COB template 02-14-2026/V4/wedge-auto-draw-COB-2d-drawing.SLDDRW
Resources/Templates/COB/COB template 02-14-2026/V4/wedge-auto-draw-COB-2d-overlay.SLDDRW
Resources/Templates/COB/COB template 02-14-2026/wedge-auto-draw-COB-2d-drawing.SLDDRW
Resources/Templates/COB/COB template 02-14-2026/wedge-auto-draw-COB-2d-overlay.SLDDRW
Resources/Templates/COB/COB_drawing_rev1.SLDPRT.SLDDRW
Resources/Templates/COB/COB_overlay_rev1.SLDDRW
Resources/Templates/COB/COB_rev2/COB_drawing_rev1.SLDPRT.SLDDRW
Resources/Templates/COB/COB_rev2/COB_overlay_rev1.SLDDRW
Resources/Templates/COB/Working Version/COB_Overlay.SLDDRW
Resources/Templates/COB/Working Version/COB_drawings.SLDDRW
Resources/Templates/FP/COB.SLDPRT
Resources/Templates/FP/COB_Overlay.SLDDRW
Resources/Templates/FP/FP_rev2/FP_drawing_rev1.SLDPRT.SLDDRW
Resources/Templates/FP/FP_rev2/FP_overlay_rev1.SLDDRW
Resources/Templates/FP/V1/COB_drawings.SLDDRW
Resources/Templates/FP/V1/wedge-auto-draw-FP-2d-drawing.SLDDRW
Resources/Templates/FP/V1/wedge-auto-draw-FP-2d-overlay.SLDDRW
Resources/Templates/FP/Working Version/COB_Overlay.SLDDRW
Resources/Templates/FP/Working Version/COB_drawings.SLDDRW
Resources/Templates/M/M_drawing_rev1.SLDPRT.SLDDRW
Resources/Templates/M/M_overlay_rev1.SLDDRW
Resources/Templates/OSG7/OSG7.SLDDRW
Resources/Templates/OSG7/OSG7_overlay.SLDDRW
Resources/Templates/OSG7/V1/OSG7.SLDDRW
Resources/Templates/OSG7/V1/OSG7_overlay.SLDDRW
Resources/Templates/OSG7/V1/wedge_auto_draw_OSG7_3d.SLDDRW
Resources/Templates/OSG7/Working Version/OSG7.SLDDRW
Resources/Templates/OSG7/Working Version/OSG7_overlay.SLDDRW
Resources/Templates/UT-US/UTUS_rev2/UTUS_drawing_rev1.SLDPRT.SLDDRW
Resources/Templates/UT-US/UTUS_rev2/UTUS_overlay_rev1.SLDDRW
Resources/Templates/UT-US/V1/COB_Overlay.SLDDRW
Resources/Templates/UT-US/V1/COB_drawings.SLDDRW
Resources/Templates/UT-US/V1/wedge-auto-draw-UT-US-2d-drawing.SLDDRW
Resources/Templates/UT-US/V1/wedge-auto-draw-UT-US-2d-overlay.SLDDRW
Resources/Templates/UT-US/Working Version/COB_Overlay.SLDDRW
Resources/Templates/UT-US/Working Version/COB_drawings.SLDDRW
Resources/Templates/VM/VM_drawing_rev1.SLDPRT.SLDDRW
Resources/Templates/VM/VM_overlay_rev1.SLDDRW
