yassinekarroukuxvc/WAD.Runner/Resources/Out/PGB/Production/5203313/5203313D.pdf

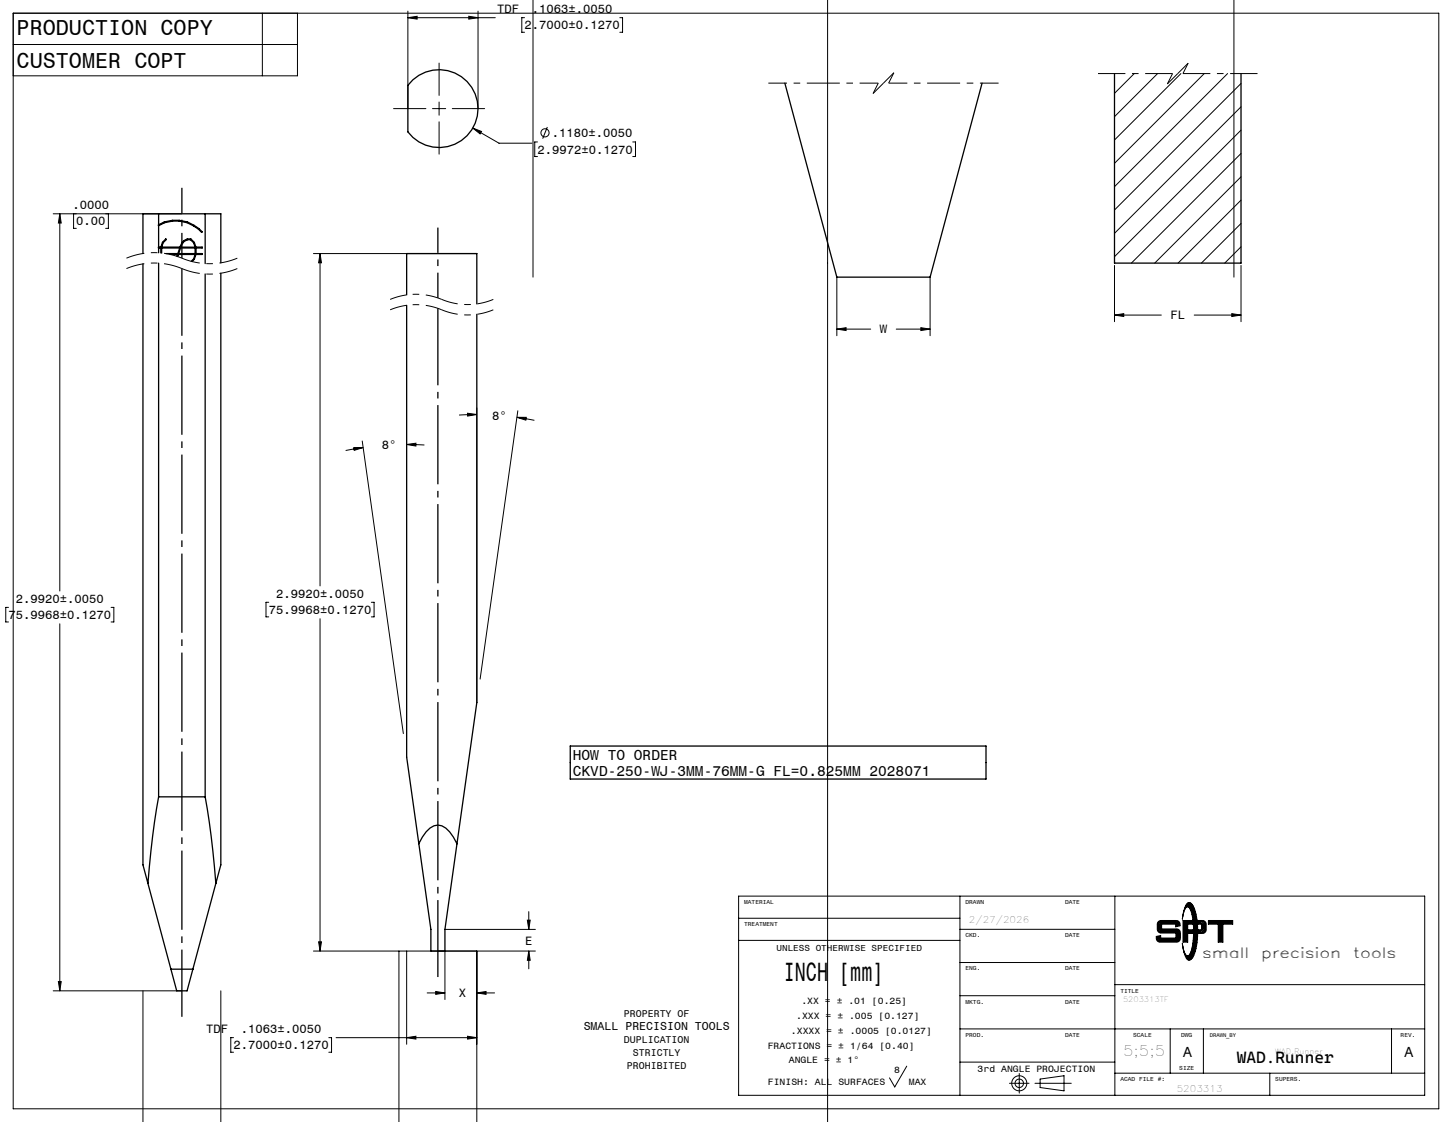
[picture p159: page 1]
3rd ANGLE PROJECTION; FINISH: ALL SURFACES; MAX; .XXX; ANGLE = ± 1°; FRACTIONS; .XXXX; ACAD FILE #:; TDF .1063±.0050

PRODUCTION COPY
CUSTOMER COPT

HOW TO ORDER
CKVD-250-WJ-3MM-76MM-G FL=0.825MM 2028071

UNLESS OTHERWISE SPECIFIED

small precision tools

PROPERTY OF
SMALL PRECISION TOOLS

DRAWN_BY
WAD.Runner
