yassinekarroukuxvc/WAD.Runner/Resources/Out/PGB/Production/5222704/5222704D.pdf

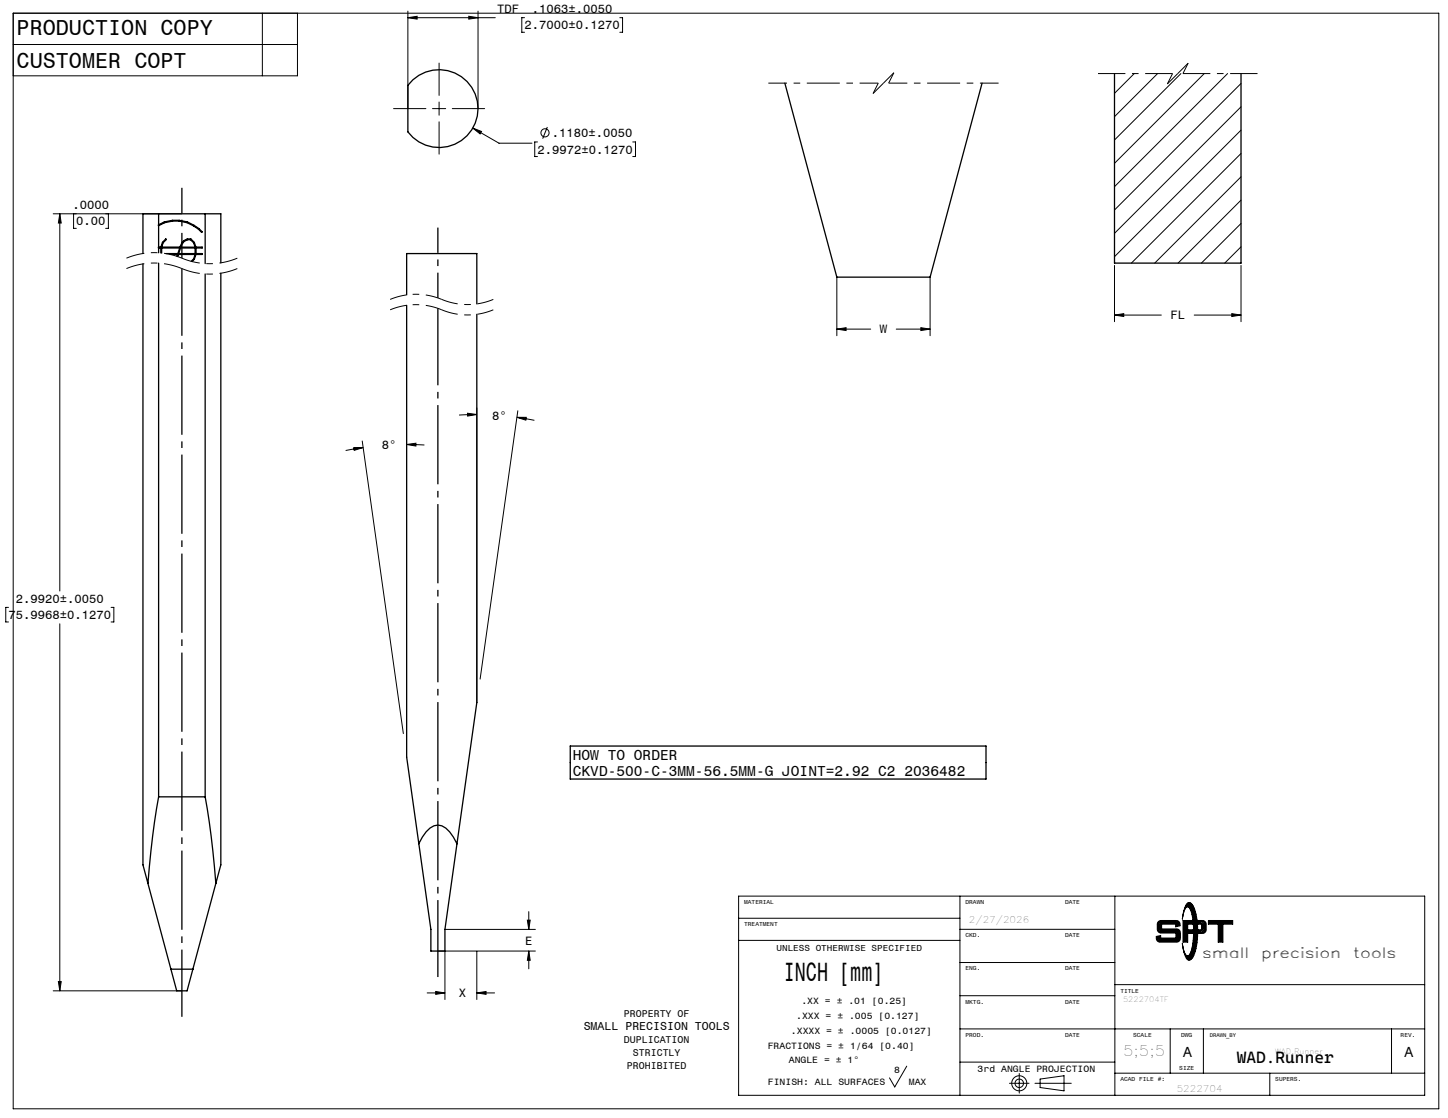
[picture p160: page 1]
3rd ANGLE PROJECTION; FINISH: ALL SURFACES; MAX; .XX = ± .01 [0.25] .XXX = ± .005 [0.127]; ANGLE = ± 1°; FRACTIONS = ± 1/64 [0.40]; .XXXX = ± .0005 [0.0127]; INCH [mm]; ACAD FILE #:; TDF .1063±.0050

PRODUCTION COPY
CUSTOMER COPT

HOW TO ORDER
CKVD-500-C-3MM-56.5MM-G JOINT=2.92 C2 2036482

UNLESS OTHERWISE SPECIFIED

small precision tools

PROPERTY OF
SMALL PRECISION TOOLS

DRAWN_BY
WAD.Runner
