yassinekarroukuxvc/WAD.Runner/Resources/Out/FG/Production/3118724/3118724P.pdf

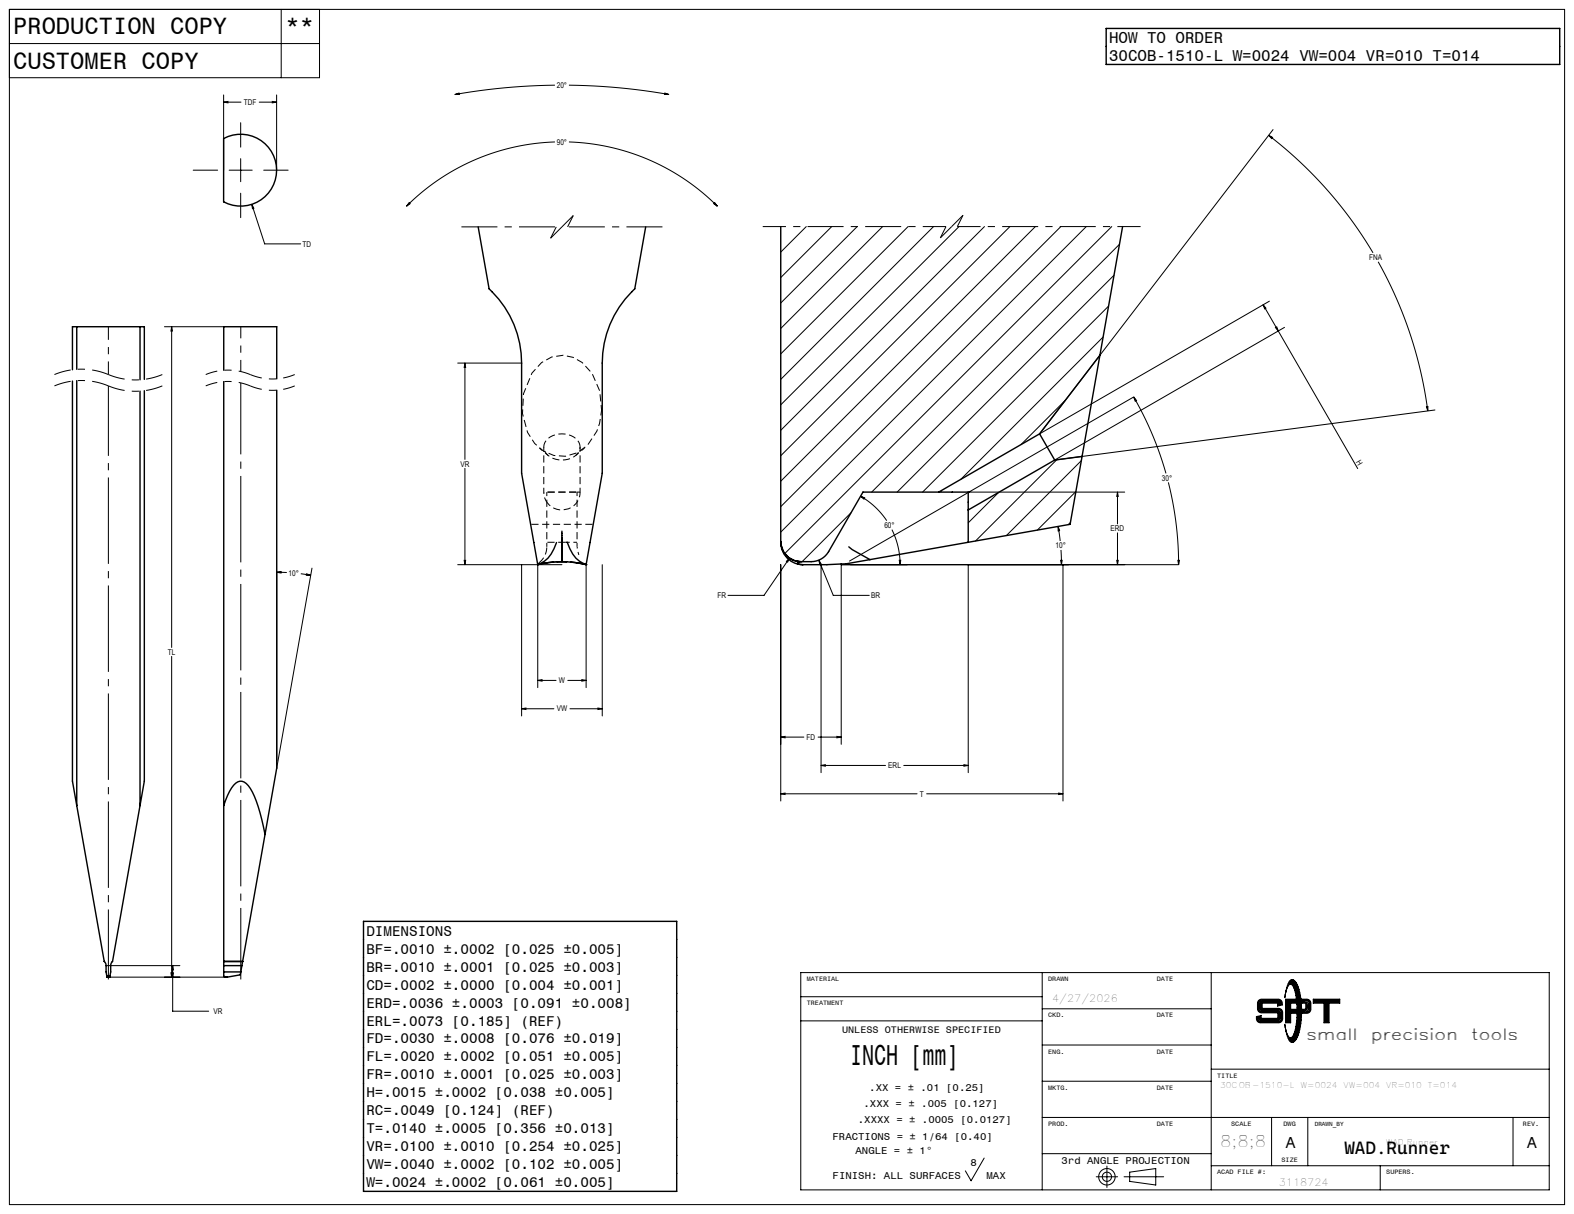
[picture p161: page 1]
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

PRODUCTION COPY | **
CUSTOMER COPY

HOW TO ORDER
30COB-1510-L W=0024 VW=004 VR=010 T=014

UNLESS OTHERWISE SPECIFIED

small precision tools

DRAWN_BY
WAD.Runner
