yassinekarroukuxvc/WAD.Runner/Resources/Out/PGB/Production/3113909/3113909D.pdf

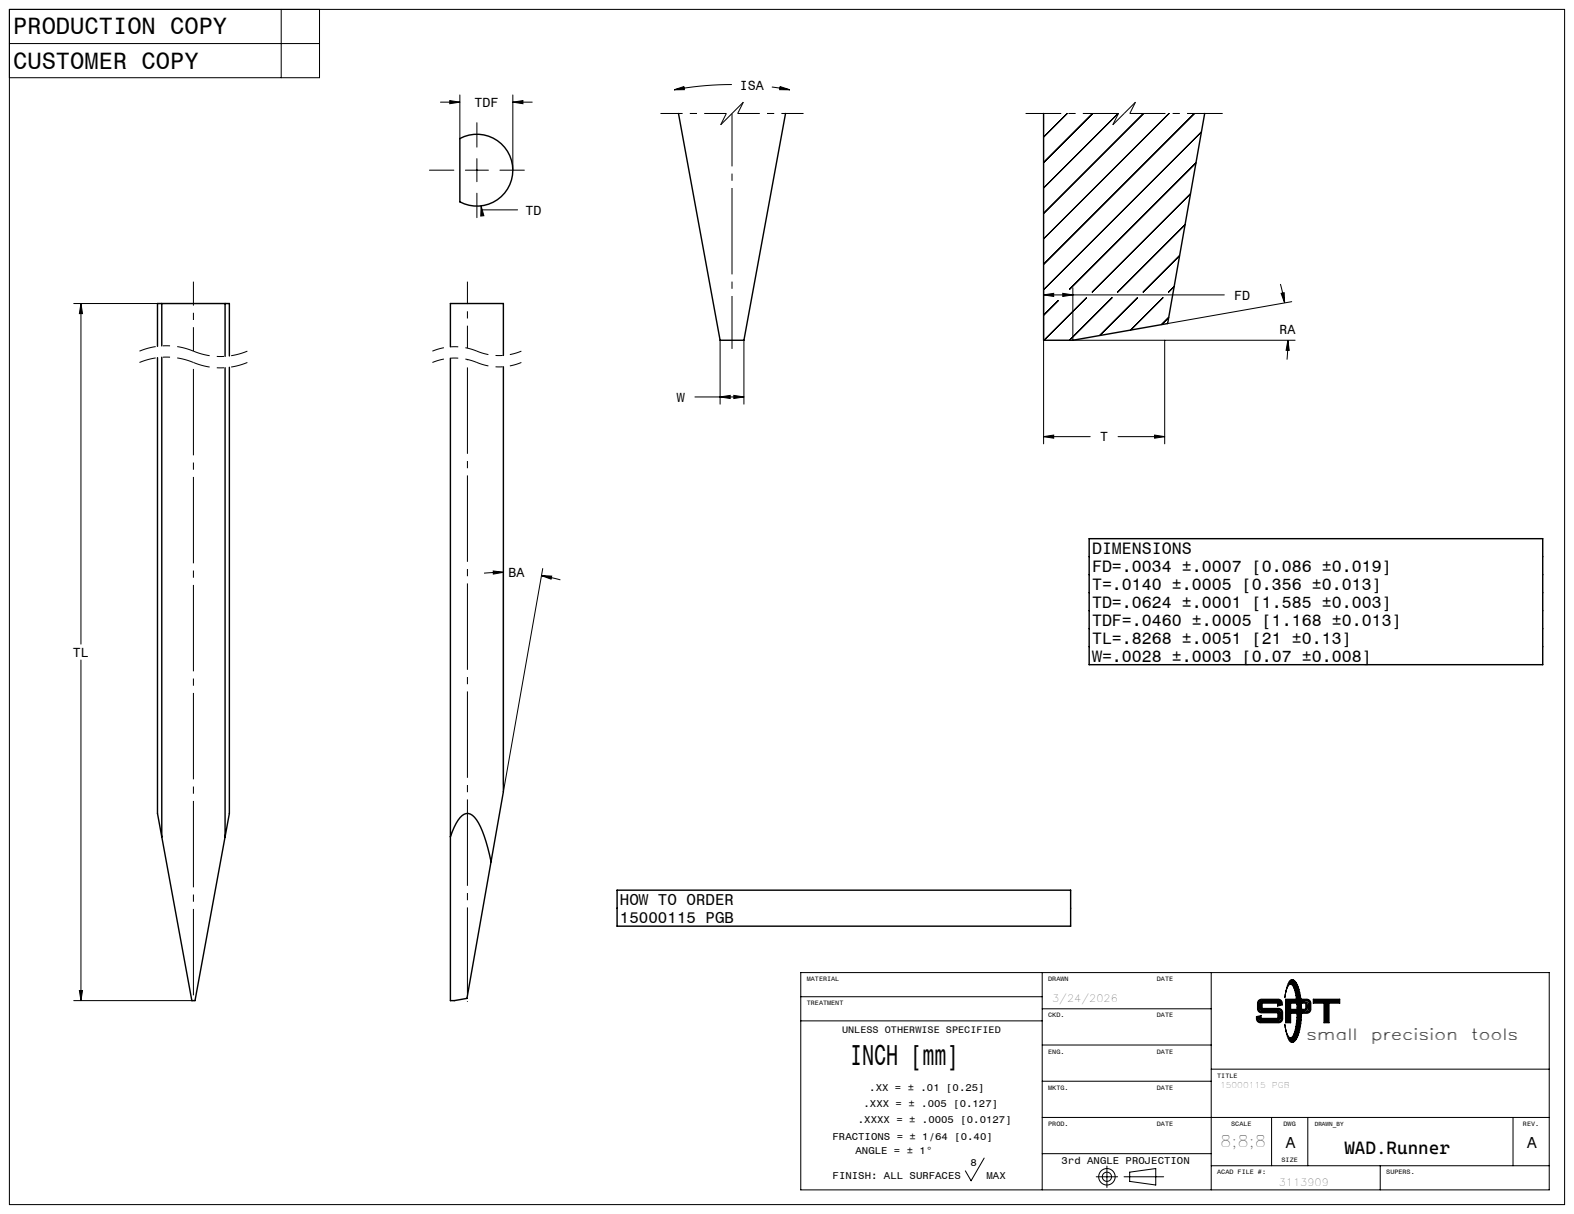
[picture p162: page 1]
3rd ANGLE PROJECTION; FINISH: ALL SURFACES; MAX; .XX = ± .01 [0.25] .XXX = ± .005 [0.127]; ANGLE = ± 1°; FRACTIONS = ± 1/64 [0.40]; .XXXX = ± .0005 [0.0127]; INCH [mm]; ACAD FILE #:; FD=.0034 ±.0007 [0.086 ±0.019] T=.0140 ±.0005 [0.356 ±0.013] TD=.0624 ±.0001 [1.585 ±0.003] TDF=.0460 ±.0005 [1.168 ±0.013] TL=.8268 ±.0051 [21 ±0.13] W=.0028 ±.0003 [0.07 ±0.008]; 15000115 PGB

PRODUCTION COPY
CUSTOMER COPY

HOW TO ORDER
15000115 PGB

UNLESS OTHERWISE SPECIFIED

small precision tools
