yassinekarroukuxvc/WAD.Runner/Resources/Out/PGB/Production/3112256/3112256D.pdf

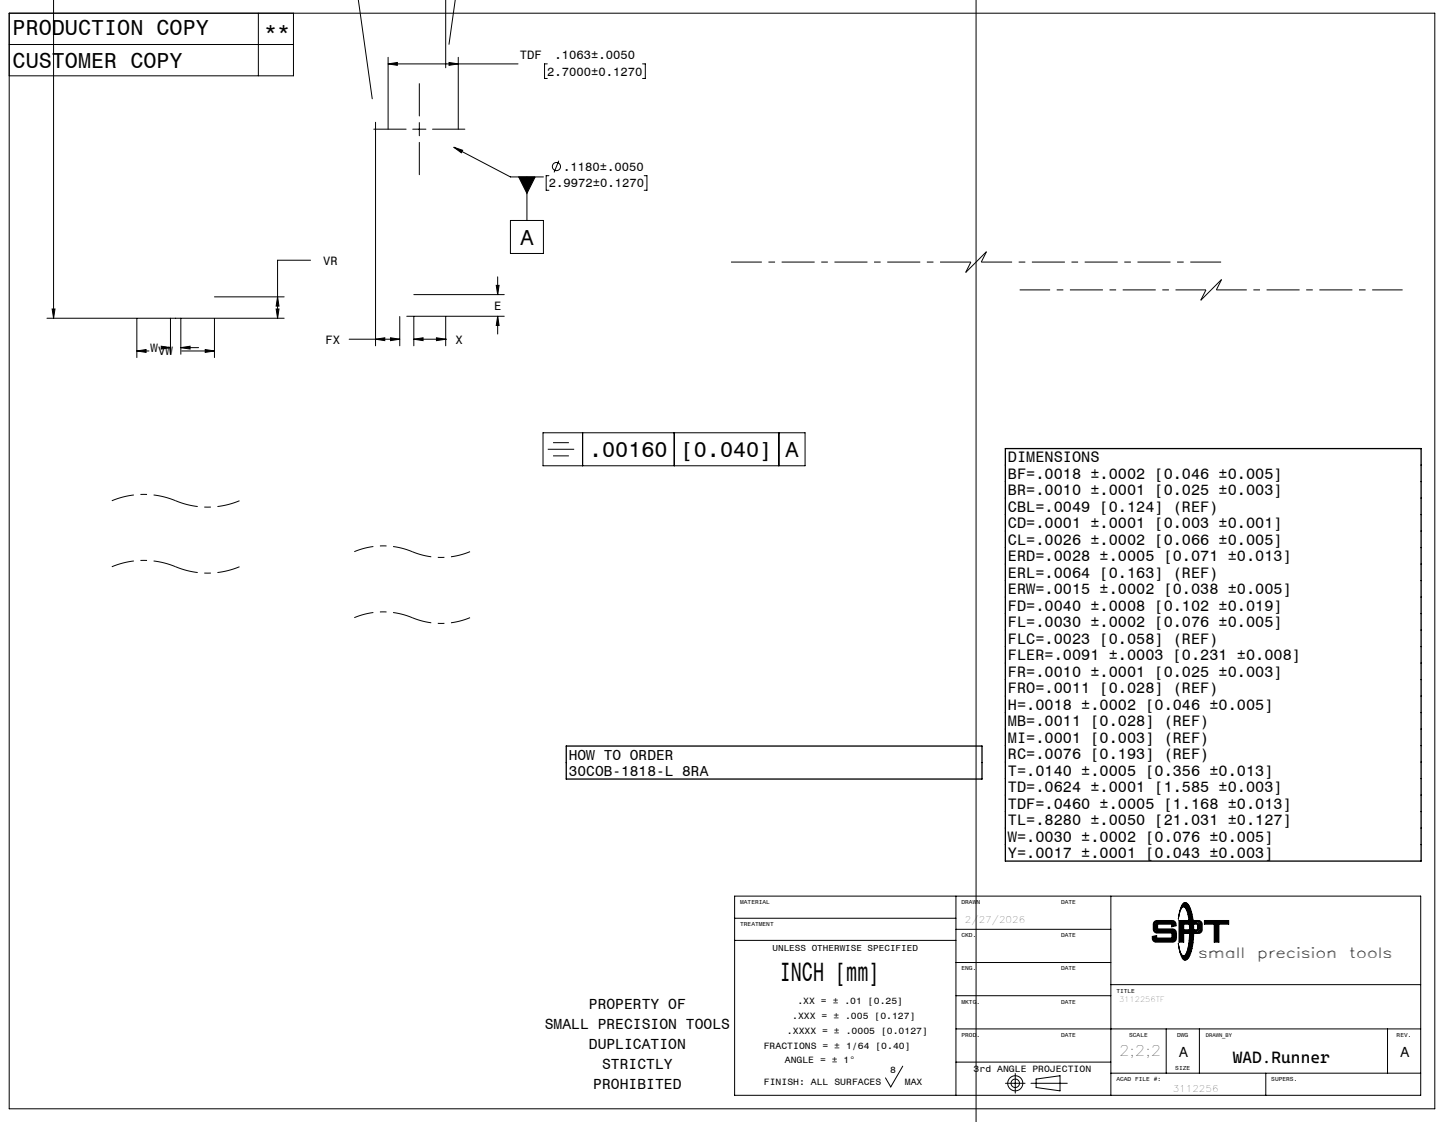
[picture p163: page 1]
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

PRODUCTION COPY | **
CUSTOMER COPY

HOW TO ORDER
30COB-1818-L 8RA

UNLESS OTHERWISE SPECIFIED

small precision tools

PROPERTY OF
SMALL PRECISION TOOLS
DUPLICATION
STRICTLY
PROHIBITED
