yassinekarroukuxvc/WAD.Runner/Resources/Out/PGB/Production/3118724/3118724D.pdf

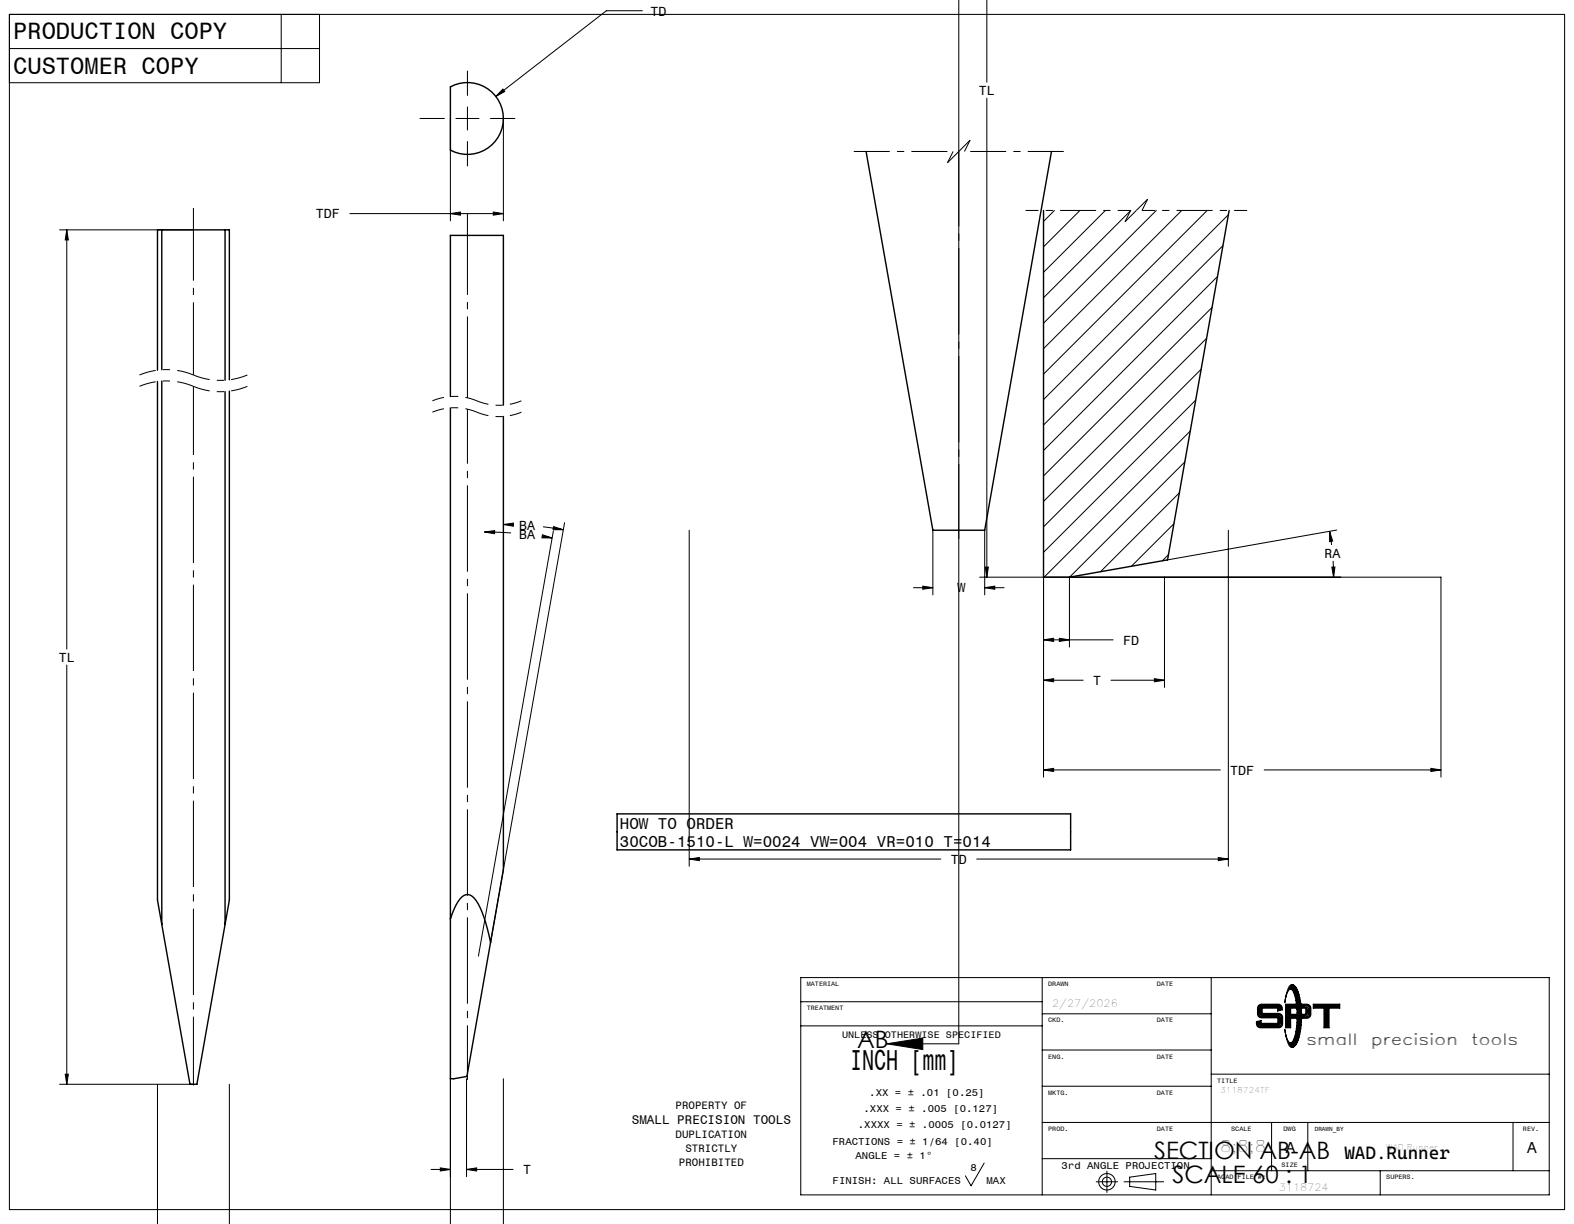
[picture p164: page 1]
3rd ANGLE PROJECTION; FINISH: ALL SURFACES; MAX; .XX = ± .01 [0.25] .XXX = ± .005 [0.127]; ANGLE = ± 1°; FRACTIONS = ± 1/64 [0.40]; .XXXX = ± .0005 [0.0127]; ACAD FILE #:; SUPERS. T; SECTION AB-AB SCALE 60 : 1

PRODUCTION COPY
CUSTOMER COPY

HOW TO ORDER
30COB-1510-L W=0024 VW=004 VR=010 T=014

MATERIAL
UNLESS OTHERWISE SPECIFIED
INCH [mm]

small precision tools

PROPERTY OF
SMALL PRECISION TOOLS

DRAWN_BY
WAD.Runner
