yassinekarroukuxvc/WAD.Runner/(commit log)

2025-12-03 Production-Customer-Overlay Drawings Automation Completed
    [3112955P.SLDDRW, 3112955P.SLDPRT, 3131117P.SLDDRW, 3131117P.SLDPRT, 5203133P.SLDDRW, 5203133P.SLDPRT, CKVD_2023.SLDPRT, OVERLAY_TEMPLATE.SLDDRW]
2025-12-08 PGB Drawings Finished
    [5201065P.SLDDRW, 5201065P.SLDPRT, 5215355P.SLDDRW, 5215355P.SLDPRT]
2025-12-10 COB Dimension Rules Set Ready To Be Implemented
    [3112955P.SLDDRW, 3112955P.SLDPRT, 3118724P.SLDDRW, 3118724P.SLDPRT, 3131117P.SLDDRW, 3131117P.SLDPRT, 5201065P.SLDDRW, 5201065P.SLDPRT]
2025-12-11 Table Service Updated
    [3112277P.SLDDRW, 3112277P.SLDPRT, 3118724P.SLDDRW, 3118724P.SLDPRT, 5201829P.SLDDRW, 5201829P.SLDPRT]
2025-12-12 Drawing Data-Wedge Type Dependent
    [3112277P.SLDDRW, 3112277P.SLDPRT, 3118724P.SLDDRW, 3118724P.SLDPRT, 5201829P.SLDDRW, 5201829P.SLDPRT]
2025-12-17 Runner API Finished
    [3112955C.SLDDRW, 3112955C.SLDPRT, 3118724P.SLDDRW, 3118724P.SLDPRT, 5201829P.SLDDRW, 5201829P.SLDPRT]
2025-12-31 OSG7 Part Automation Rules Set
    [3112955C.SLDDRW, 3112955C.SLDPRT, 5203222D.SLDPRT, 5219283D.SLDPRT, 5219283P.SLDPRT, CKVD_2023.SLDDRW, OVERLAY_TEMPLATE.SLDDRW, wedge_auto_draw_OSG7_3d.SLDDRW]
2026-01-12 OSG7 Finished
    [3112955P.SLDDRW, 3112955P.SLDPRT, 5203222D.SLDPRT, 5219283D.SLDPRT, 5219283P.SLDPRT, wedge_auto_draw_OSG7_3d.SLDDRW, wedge_auto_draw_OSG7_3d.SLDPRT]
2026-02-15 Pre COB Commit
    [wedge-auto-draw-COB-3d-model_sw_version_2023.SLDPRT]
2026-02-20 COB Part Automation Done
    [3112249P.SLDPRT, 3112267P.SLDPRT, 3112955P.SLDPRT, 3117140P.SLDPRT, 3118724--subclassP.SLDPRT, 3118724P.SLDPRT, 3118724_COB_Production.SLDPRT, 3122737P.SLDPRT]
2026-02-27 Pre-COB Drawing Automation
    [3112249P.SLDPRT, 3112251P.SLDPRT, 3112252P.SLDPRT, 3112261P.SLDPRT, 3112262P.SLDPRT, 3112263P.SLDPRT, 3112264P.SLDPRT, 3112274P.SLDPRT]
2026-03-02 COB Production/Customer/PGB automation 80% Ready
    [3112249P.SLDDRW, 3112249P.SLDPRT, 3112256D.SLDDRW, 3112256D.SLDPRT, 3112256P.SLDPRT, 3113909D.SLDDRW, 3113909D.SLDPRT, 3118724D.SLDDRW]
2026-03-03 COB Production/Customer/PGB Automation Finished
    [3112255P.SLDDRW, 3112255P.SLDPRT, 3112263P.SLDDRW, 3112263P.SLDPRT, 3112955P.SLDDRW, 3112955P.SLDPRT, 3113909D.SLDDRW, 3113909D.SLDPRT]
2026-03-04 Final COB Production/Customer/PGB Push
    [3130511P.SLDPRT, 3130511TF.SLDPRT, 3133297TF.SLDDRW, 3133297TF.SLDPRT, 5214273P.SLDPRT, CKVD_2023.SLDDRW, CKVD_2023.SLDPRT, OVERLAY_TEMPLATE.SLDDRW]
2026-03-04 Adding Java API Data Selection
    [3112955P.SLDDRW, 3112955P.SLDPRT, 3112955TF.SLDDRW, 3112955TF.SLDPRT, 3118724P.SLDDRW, 3118724P.SLDPRT, 3118724TF.SLDDRW, 3118724TF.SLDPRT]
2026-03-05 Pre COB PGB Overlay Commit
    [3112256P.SLDPRT, 3118724P.SLDDRW, 3118724P.SLDPRT, 3131117P.SLDDRW, 3131117P.SLDPRT, 3131117TF.SLDDRW, 3131117TF.SLDPRT, 3131744P.SLDDRW]
2026-03-09 COB Automation 90% Dome
    [3112256P.SLDDRW, 3112256P.SLDPRT, 3112955P.SLDDRW, 3112955P.SLDPRT, 3112955TF.SLDDRW, 3112955TF.SLDPRT, 3113909D.SLDDRW, 3113909D.SLDPRT]
2026-03-10 COB Overlay Not Finished Yet
    [3112252TF.SLDDRW, 3112252TF.SLDPRT, 3112267P.SLDDRW, 3112267P.SLDPRT, 3113909D.SLDDRW, 3113909D.SLDPRT, 3118724P.SLDDRW, 3118724P.SLDPRT]
2026-03-11 Commit before pushing the COB automation to the server
    [3112251TF.SLDDRW, 3112251TF.SLDPRT, 3112258TF.SLDDRW, 3112258TF.SLDPRT, 3130092TF.SLDDRW, 3130092TF.SLDPRT, 3131804TF.SLDDRW, 3131804TF.SLDPRT]
2026-03-13 Starting UT/US Automation
    [3112955TF.SLDDRW, 3112955TF.SLDPRT, 5200709P.SLDDRW, 5200709P.SLDPRT, 5200709TF.SLDDRW, 5200709TF.SLDPRT]
2026-03-16 Push Before Finishing UT/US entirely
    [3112580P.SLDDRW, 3112580P.SLDPRT, 5200709C.SLDDRW, 5200709C.SLDPRT, 5200709TF.SLDDRW, 5200709TF.SLDPRT, 5209611P.SLDDRW, 5209611P.SLDPRT]
2026-03-23 Commit Before Starting On FP
    [3112575P.SLDDRW, 3112575P.SLDPRT, 3112575TF.SLDDRW, 3112575TF.SLDPRT, 3114051TF.SLDDRW, 3114051TF.SLDPRT, 3118710TF.SLDDRW, 3118710TF.SLDPRT]
2026-03-30 Stop tracking Resources/Out
    [3112260P.SLDDRW, 3112260P.SLDPRT, 3112260TF.SLDDRW, 3112260TF.SLDPRT, 3112277TF.SLDDRW, 3112277TF.SLDPRT, 3112288TF.SLDDRW, 3112288TF.SLDPRT]
2026-04-01 FP Automation Completed
    [5200337P.SLDPRT, 5202642P.SLDPRT, wedge-auto-draw-COB-2d-drawing.SLDDRW, wedge-auto-draw-COB-2d-overlay.SLDDRW, wedge-auto-draw-COB-3d-model_sw_version_2023.SLDPRT, wedge-auto-draw-FP-2d-drawing.SLDDRW, wedge-auto-draw-FP-2d-overlay.SLDDRW, wedge-auto-draw-FP-3d-model_sw_version_2023.SLDPRT]
2026-04-05 Pre New Templates Commit
    [5214700P.SLDDRW, 5214700P.SLDPRT, COB.SLDPRT, COB_drawings.SLDDRW, wedge-auto-draw-UT-US-2d-drawing.SLDDRW, wedge-auto-draw-UT-US-3d-model_sw_version_2023.SLDPRT]
2026-04-07 Push Before Adding the new parameters to the FP , COB and UT/US
    [3112274P.SLDPRT, 3112573P.SLDPRT, 3118724P.SLDDRW, 3118724P.SLDPRT, 5200709P.SLDDRW, 5200709P.SLDPRT, 5201977P.SLDDRW, 5201977P.SLDPRT]
2026-04-09 ynamic Annotations Positions
    [3112580P.SLDDRW, 3112580P.SLDPRT, 3112984P.SLDDRW, 3112984P.SLDPRT, 3118724P.SLDDRW, 3118724P.SLDPRT, 3126845P.SLDPRT, 3131806P.SLDPRT]
2026-04-16 Pre New COB-UT/US-FP VW VR Cut
    [3112252TF.SLDDRW, 3112252TF.SLDPRT, 3112258TF.SLDDRW, 3112258TF.SLDPRT, 3118724TF.SLDDRW, 3118724TF.SLDPRT, 3130092P.SLDPRT, 3130092TF.SLDDRW]
2026-04-18 Pre Claude Modifications
    [3112249P.SLDDRW, 3112249P.SLDPRT, 3112251P.SLDPRT, 3112251TF.SLDDRW, 3112251TF.SLDPRT, 3112252P.SLDPRT, 3112252TF.SLDDRW, 3112252TF.SLDPRT]
2026-04-20 Commit Before Big Changes. Everything Works Now even the Overlay VW and VR case
    [3118724P.SLDDRW, 3118724P.SLDPRT, 3118724TF.SLDDRW, 3118724TF.SLDPRT, 5201065TF.SLDDRW, 5201065TF.SLDPRT, COB.SLDPRT]
2026-04-21 COB Done
    [COB.SLDPRT, COB_Overlay.SLDDRW, COB_drawings.SLDDRW]
2026-04-25 Pre CASE 3 and CASE 4 Tolerances
    [3112260P.SLDDRW, 3112260P.SLDPRT, 3112260TF.SLDDRW, 3112260TF.SLDPRT, 3118724P.SLDDRW, 3118724P.SLDPRT, 3118724TF.SLDDRW, 3118724TF.SLDPRT]
2026-04-26 Pre PGB Stuff
    [3118724TF.SLDDRW, 3118724TF.SLDPRT, COB.SLDPRT, COB_Overlay.SLDDRW, COB_drawings.SLDDRW]
2026-04-27 COB-FP-UT/US Done
    [3118724TF.SLDDRW, 3118724TF.SLDPRT]
2026-05-01 Pre Tam Adjustments
    [3118724P.SLDDRW, 3118724P.SLDPRT, 3118724TF.SLDDRW, 3118724TF.SLDPRT, COB.SLDPRT, COB_Drawings.SLDDRW, COB_Overlay.SLDDRW, COB_drawings.SLDDRW]
2026-05-06 COB UTUS FP Done
    [COB.SLDPRT, COB_Overlay.SLDDRW, COB_drawings.SLDDRW]
2026-05-22 Pre Cleaning
    [COB.SLDPRT, COB_Overlay.SLDDRW, COB_drawings.SLDDRW, OSG7.SLDDRW, OSG7.SLDPRT, OSG7_overlay.SLDDRW]
2026-06-09 OSG7 Annotation Starting
    [CKVD_2023.SLDDRW, CKVD_2023.SLDPRT, COB.SLDPRT, COB_Drawings.SLDDRW, COB_Overlay.SLDDRW, COB_Template.SLDPRT, COB_drawings.SLDDRW, OSG7.SLDDRW]
2026-06-28 Pre New UTUS FP COB Tolerance Adjustments
    [COB.SLDPRT, COB_Overlay.SLDDRW, COB_drawings.SLDDRW]
2026-07-13 Another COB FP UTUS adjustments made
    [COB.SLDPRT, COB_Overlay.SLDDRW, COB_drawings.SLDDRW]
2026-07-19 Some refactors
    [COB.SLDPRT, OSG7.SLDDRW, OSG7.SLDPRT, OSG7_overlay.SLDDRW]
2026-07-19 Remove ZIP archives and ignore them
    [OSG7.SLDDRW, OSG7.SLDPRT, OSG7_overlay.SLDDRW]
2026-08-03 CKVD Refactoring
    [ckvd_drawing_rev2.SLDPRT.SLDDRW, ckvd_overlay_rev2.SLDDRW, ckvd_part_rev2.SLDPRT]
2026-08-10 4516 Finished
    [4516_drawing_rev2.SLDPRT.SLDDRW, 4516_overlay_rev2.SLDDRW, 4516_part_rev2.SLDPRT]
2026-08-14 ABT Wedge Type Finished
    [AB16_drawing_rev2.SLDPRT.SLDDRW, AB16_overlay_rev2.SLDDRW, AB16_part_rev1.SLDPRT, ABT_drawing_rev1.SLDPRT.SLDDRW, ABT_overlay_rev1.SLDDRW, ABT_part_rev1.SLDPRT]
2026-08-18 AB16 Finished
    [AB16_part_rev1.SLDPRT, CK45_drawing_rev2.SLDPRT.SLDDRW, CK45_overlay_rev2.SLDDRW, CK45_part_rev1.SLDPRT]
2026-08-26 M wedge Type Finished
    [CK45_part_rev1.SLDPRT, M_drawing_rev1.SLDPRT.SLDDRW, M_overlay_rev1.SLDDRW, M_part_rev1.SLDPRT]
2026-08-28 1001 Wedge type finished
    [1001A_drawing_rev1.SLDPRT.SLDDRW, 1001A_overlay_rev1.SLDDRW, 1001A_part_rev1.SLDPRT, 4516_part_rev2.SLDPRT, COB_drawing_rev1.SLDPRT.SLDDRW, COB_overlay_rev1.SLDDRW, COB_part_rev1.SLDPRT, FP_drawing_rev1.SLDPRT.SLDDRW]
2026-08-28 Adjustments made to all the wedges
    [COB_drawing_rev1.SLDPRT.SLDDRW, COB_part_rev1.SLDPRT]
2026-08-30 UTUS - FP Updated
    [COB_part_rev1.SLDPRT, UTUS_drawing_rev1.SLDPRT.SLDDRW, UTUS_overlay_rev1.SLDDRW, UTUS_part_rev1.SLDPRT]
2026-09-02 CKVD Finished Again
    [ckvd_part_rev2.SLDPRT]
2026-09-09 Added Test and Production Database Switching
    [CKVD_2023.SLDDRW, CKVD_2023.SLDPRT, CKVD_2023_fix.SLDDRW, CKVD_fix.SLDPRT, OVERLAY_TEMPLATE.SLDDRW, ckvd_drawing_rev2.SLDPRT.SLDDRW, ckvd_overlay_rev2.SLDDRW, ckvd_part_rev2.SLDPRT]
2026-09-21 Added PGB Feature Cut Management
2026-09-28 Added VM Model Automation
    [VM_drawing_rev1.SLDPRT.SLDDRW, VM_overlay_rev1.SLDDRW, VM_part_rev1.SLDPRT]
2026-10-02 4515 Adjustments 50% Done
    [4516_overlay_rev2.SLDDRW, COB_drawing_rev1.SLDPRT.SLDDRW]
2026-10-05 Modefied the Overlay Cut Finalizer
    [1001A_drawing_rev1.SLDPRT.SLDDRW, 1001A_part_rev1.SLDPRT, 4516_drawing_rev2.SLDPRT.SLDDRW, AB16_drawing_rev2.SLDPRT.SLDDRW, ABT_drawing_rev1.SLDPRT.SLDDRW, ABT_part_rev1.SLDPRT, CK45_drawing_rev2.SLDPRT.SLDDRW, COB_drawing_rev1.SLDPRT.SLDDRW]
2026-10-07 Added an Auto scale for all views in production/customer
    [4516_drawing_rev2.SLDPRT.SLDDRW, 4516_overlay_rev2.SLDDRW, 4516_part_rev2.SLDPRT]
